mechameka/satellite_watch/README.md

# satellite_watch
ESP32-S3 based smartwatch with swappable, modular faceplate

Phase 1: Create prototype large-format board for diagnosing
Phase 2: Create compact mainboard
Phase 3: Create intial faceplate designs of LED, IPS, and blank protoboard/headers
