mechameka/satellite_watch/kicad_references/models/ips_0.96_mock.step

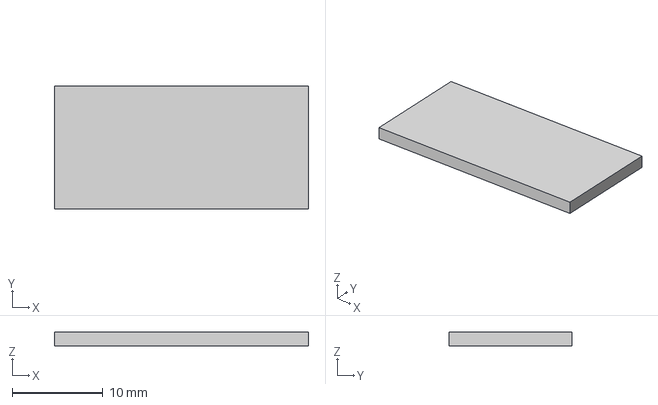
[picture p1: CAD file, 2026-07-30]
kicad_references/models/ips_0.96_mock.step
27.9 x 13.5 x 1.50 mm
