mechameka/satellite_watch/kicad_references/symbols/MSOP8_DIO.step

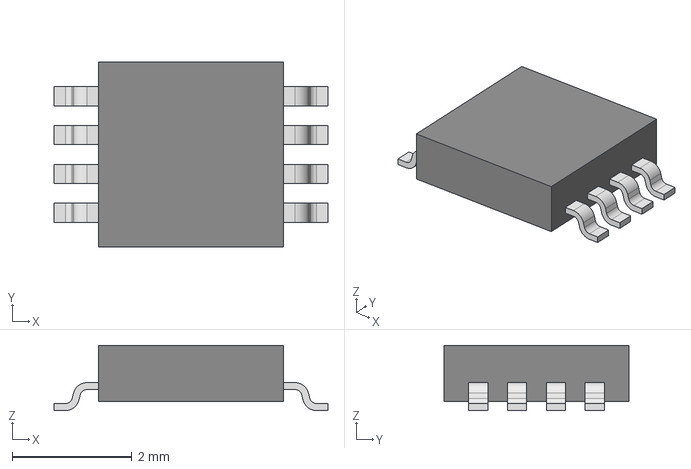
[picture p2: CAD file, 2026-06-10]
kicad_references/symbols/MSOP8_DIO.step
4.58 x 3.10 x 1.09 mm
