mechameka/satellite_watch/kicad_references/models/HP_BubbleLED.step

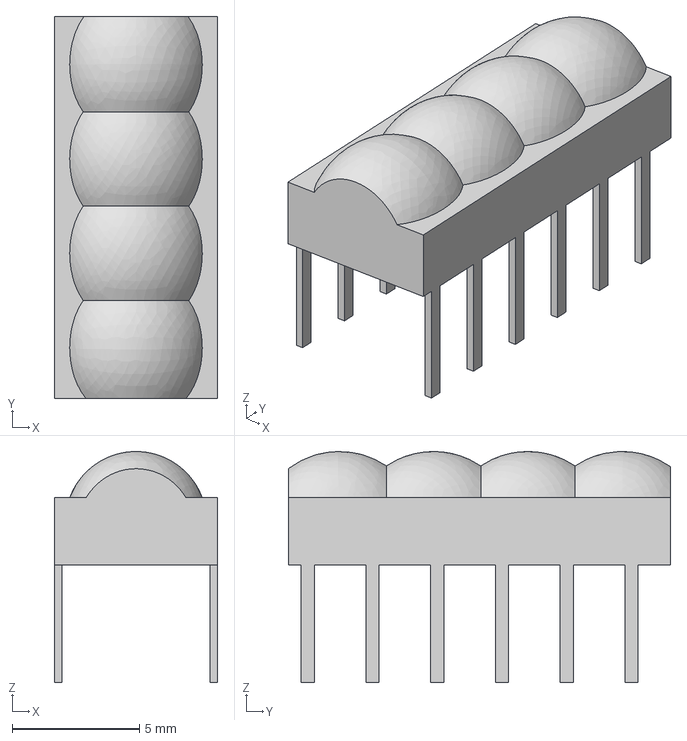
[picture p3: CAD file, 2026-07-30]
kicad_references/models/HP_BubbleLED.step
6.40 x 15.0 x 9.06 mm
