mechameka/satellite_watch/kicad_references/models/HCMS-2901.STEP

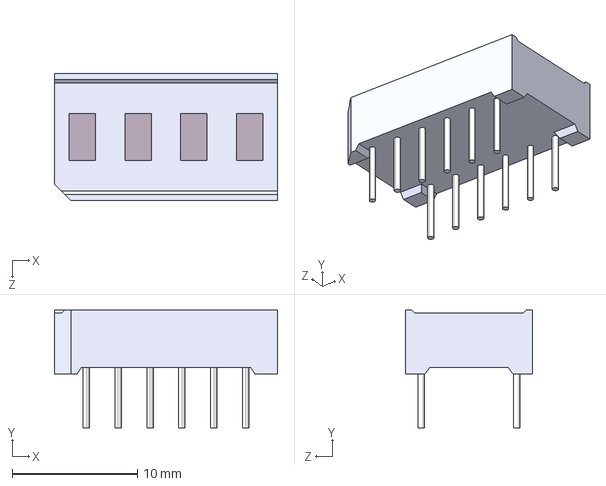
[picture p4: CAD file, 2026-07-30]
kicad_references/models/HCMS-2901.STEP
17.8 x 9.40 x 10.2 mm
