mechameka/satellite_watch/kicad_references/models/3028_2012BATTEYRHOLDER.step

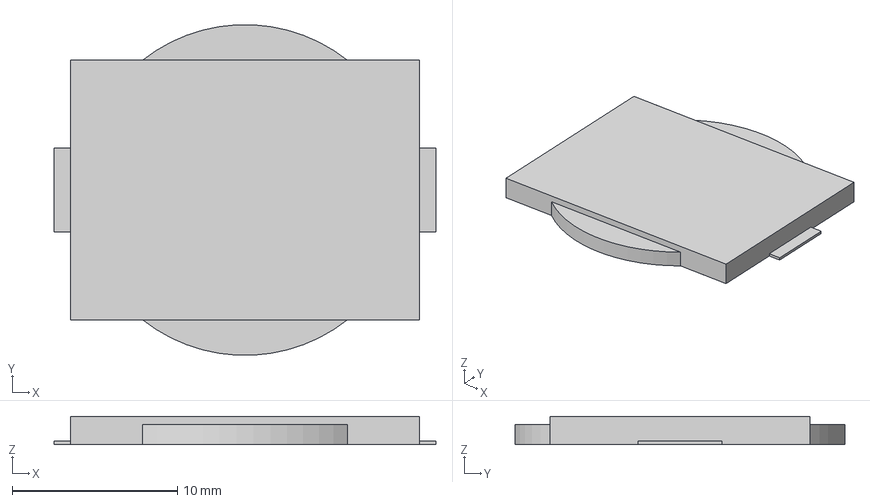
[picture p5: CAD file, 2026-07-30]
kicad_references/models/3028_2012BATTEYRHOLDER.step
23.1 x 20.0 x 1.70 mm
