mechameka/satellite_watch/kicad_references/models/Same_Sky_UJ20-C-H-G-SMT-2A-P16-TR.step

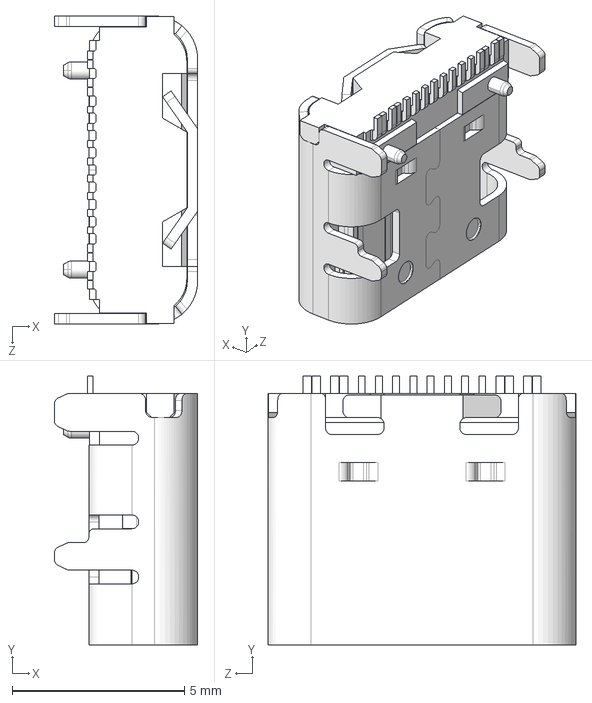
[picture p6: CAD file, 2026-07-30]
kicad_references/models/Same_Sky_UJ20-C-H-G-SMT-2A-P16-TR.step
4.16 x 7.80 x 8.94 mm
