mechameka/satellite_watch/kicad_references/models/SN74HC595NSR.stp

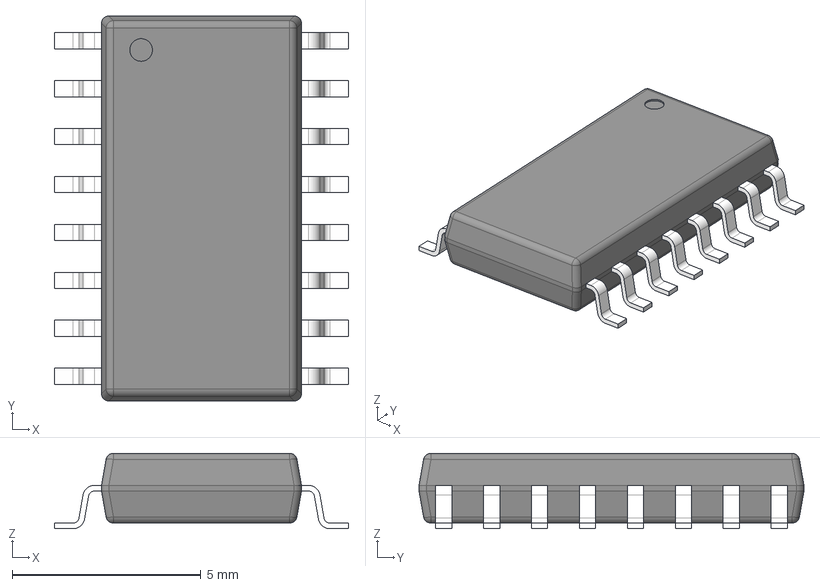
[picture p7: CAD file, 2026-07-30]
kicad_references/models/SN74HC595NSR.stp
7.80 x 10.2 x 2.00 mm
BODY-SO
LEAD-SO x 16
