mechameka/satellite_watch/kicad_references/models/BK-335-SM.step

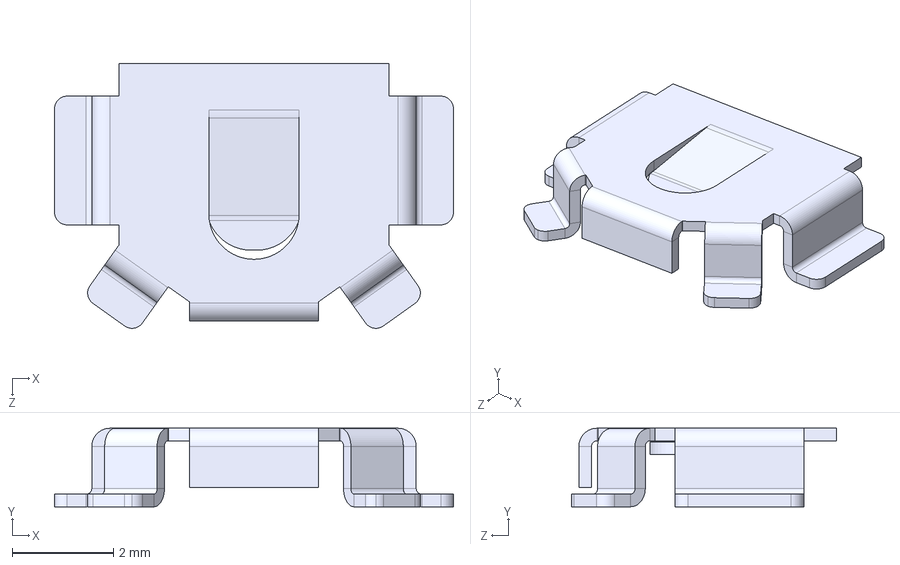
[picture p8: CAD file, 2026-07-30]
kicad_references/models/BK-335-SM.step
7.87 x 1.55 x 5.22 mm
