mechameka/satellite_watch/kicad_references/models/BC-2017.step

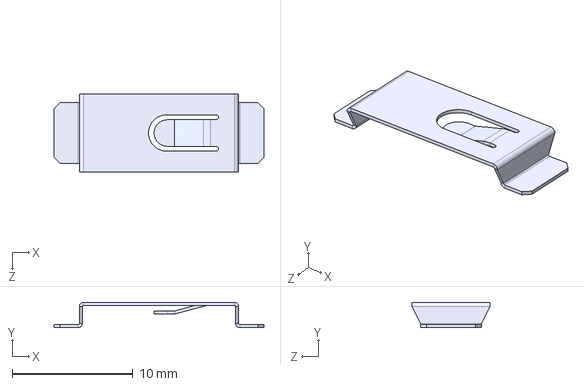
[picture p9: CAD file, 2026-07-20]
kicad_references/models/BC-2017.step
17.4 x 2.11 x 6.48 mm
