mechameka/satellite_watch/kicad_references/models/855-22-006-10-001101.stp

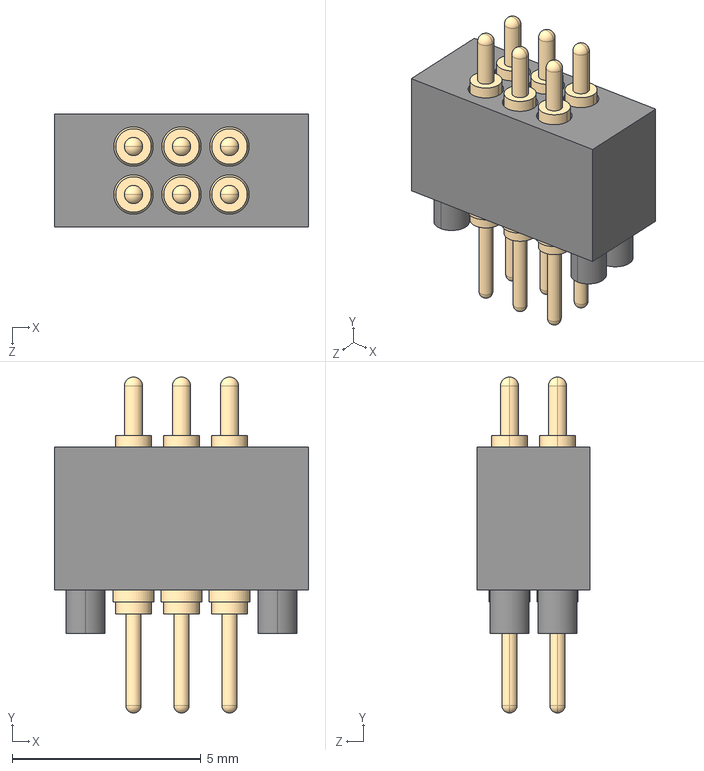
[picture p10: CAD file, 2026-07-16]
kicad_references/models/855-22-006-10-001101.stp
6.73 x 8.89 x 3.00 mm
mill-max-855-22-006-10-001101_P8XX-28-013-02-090000(P806-28-013-02-090000)
mill-max-855-22-006-10-001101_0985 x 6
