mechameka/satellite_watch/kicad_references/models/SOT-416.step

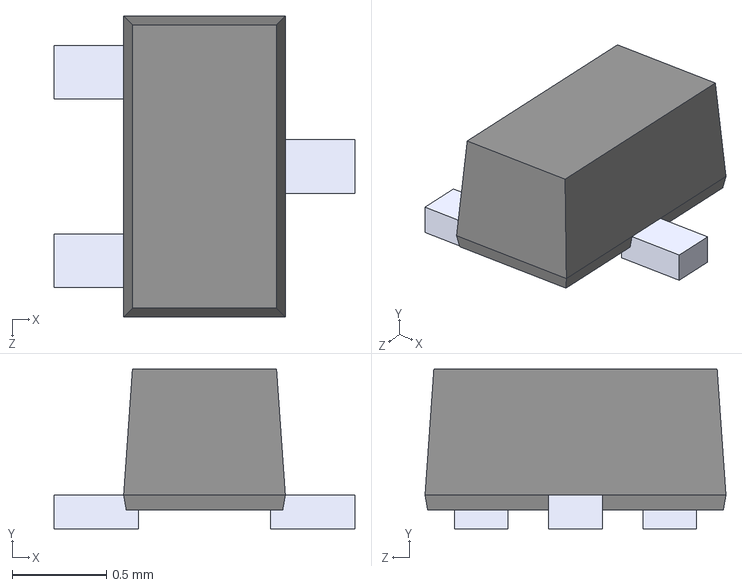
[picture p11: CAD file, 2026-07-16]
kicad_references/models/SOT-416.step
1.60 x 0.85 x 1.60 mm
