mechameka/satellite_watch/kicad_references/models/ABS07-32.768KHZ-T.STEP

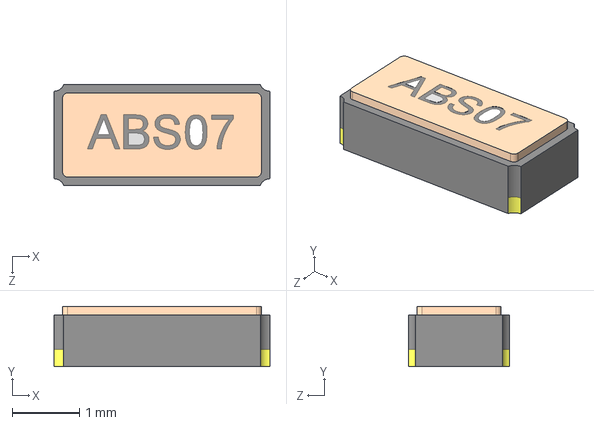
[picture p12: CAD file, 2026-07-16]
kicad_references/models/ABS07-32.768KHZ-T.STEP
3.20 x 0.889 x 1.50 mm
