mechameka/satellite_watch/kicad_references/models/R-667995_MIT.step

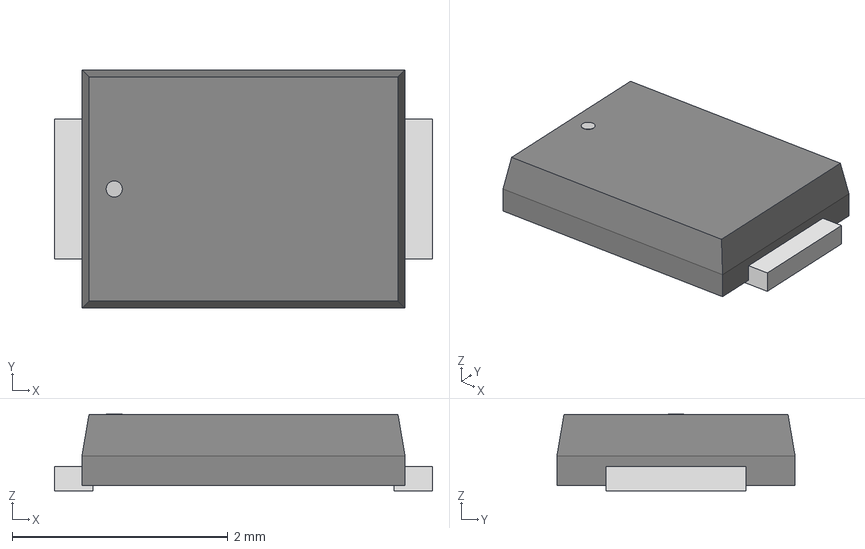
[picture p13: CAD file, 2026-07-16]
kicad_references/models/R-667995_MIT.step
3.51 x 2.21 x 0.714 mm
