mechameka/satellite_watch/kicad_references/models/PAM2401SCADJ.STEP

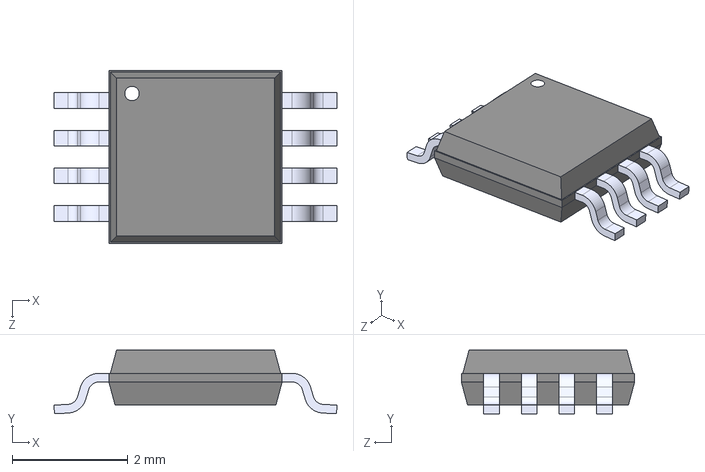
[picture p14: CAD file, 2026-07-06]
kicad_references/models/PAM2401SCADJ.STEP
4.90 x 1.10 x 3.00 mm
