mechameka/satellite_watch/kicad_references/models/TL1105SF160Q.step

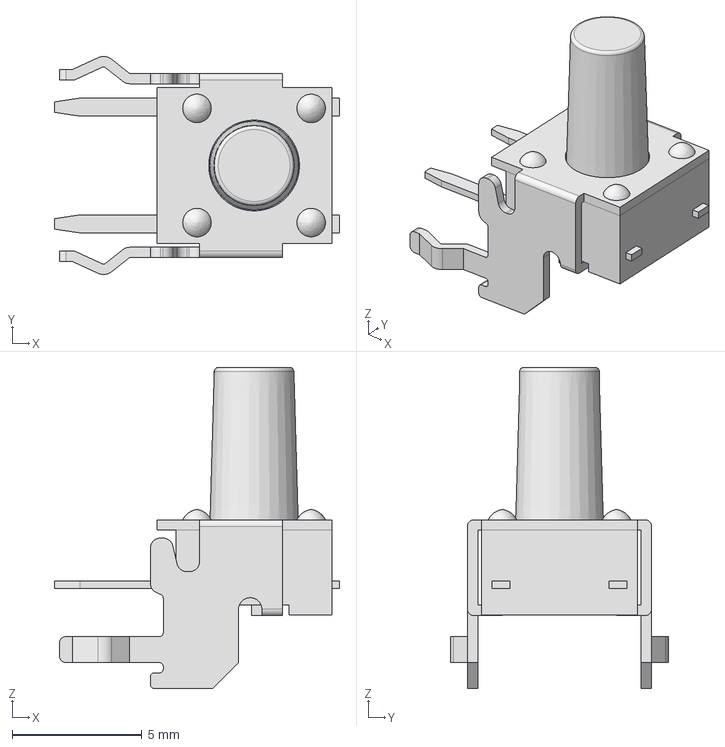
[picture p15: CAD file, 2026-07-06]
kicad_references/models/TL1105SF160Q.step
11.0 x 8.40 x 12.4 mm
