mechameka/satellite_watch/kicad_references/models/BNO085.step

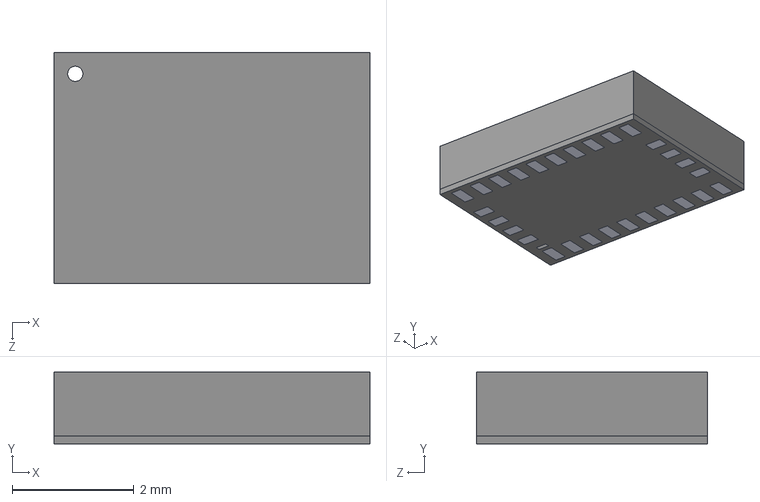
[picture p16: CAD file, 2026-06-24]
kicad_references/models/BNO085.step
5.20 x 1.18 x 3.80 mm
