mechameka/satellite_watch/kicad_references/models/FS8205.step

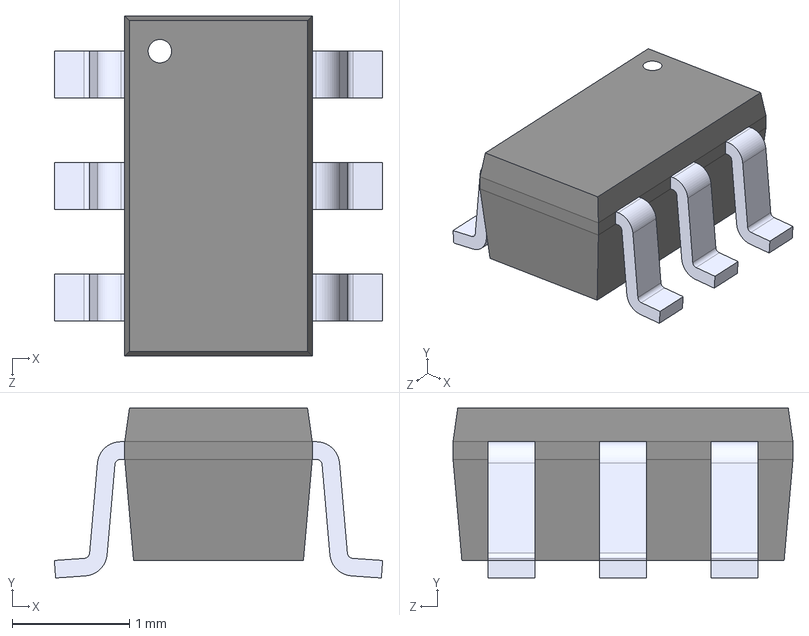
[picture p17: CAD file, 2026-06-17]
kicad_references/models/FS8205.step
2.80 x 1.45 x 2.90 mm
