mechameka/satellite_watch/kicad_references/models/UJ20-C-H-G-MSMT-2B-P16-TR.step

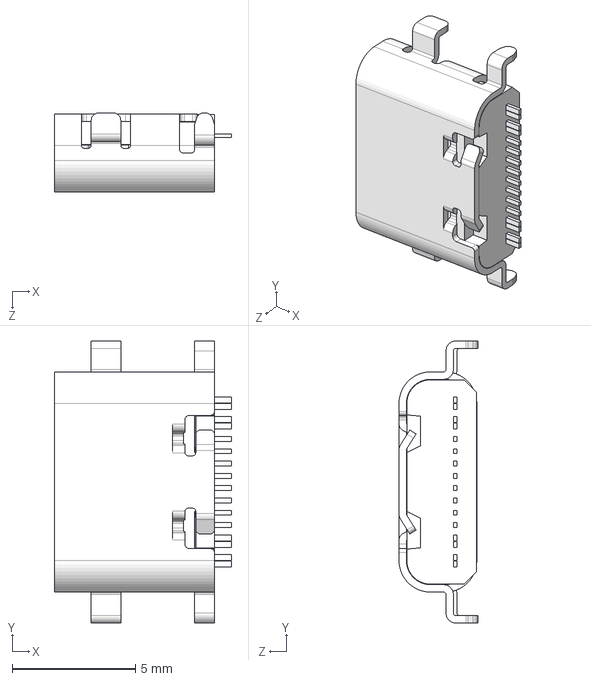
[picture p18: CAD file, 2026-06-10]
kicad_references/models/UJ20-C-H-G-MSMT-2B-P16-TR.step
7.21 x 11.4 x 3.21 mm
