mechameka/satellite_watch/kicad_references/models/NCP186AMX180TAG.STEP

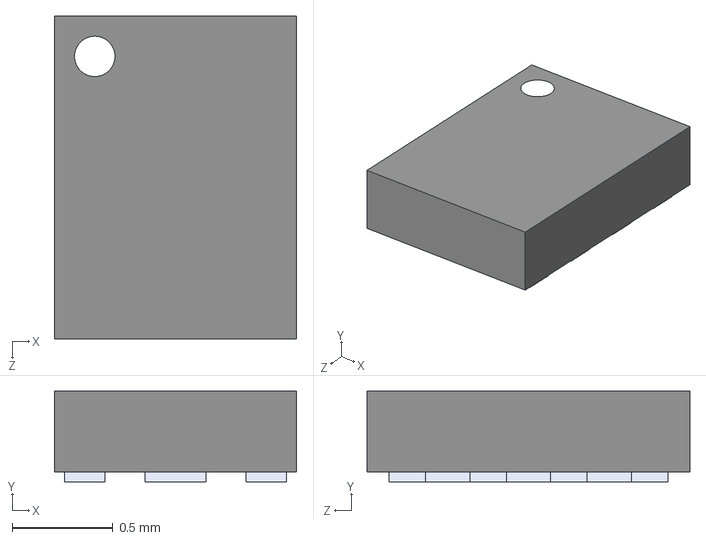
[picture p19: CAD file, 2026-06-10]
kicad_references/models/NCP186AMX180TAG.STEP
1.20 x 0.45 x 1.60 mm
