mechameka/satellite_watch/kicad_references/models/2895.step

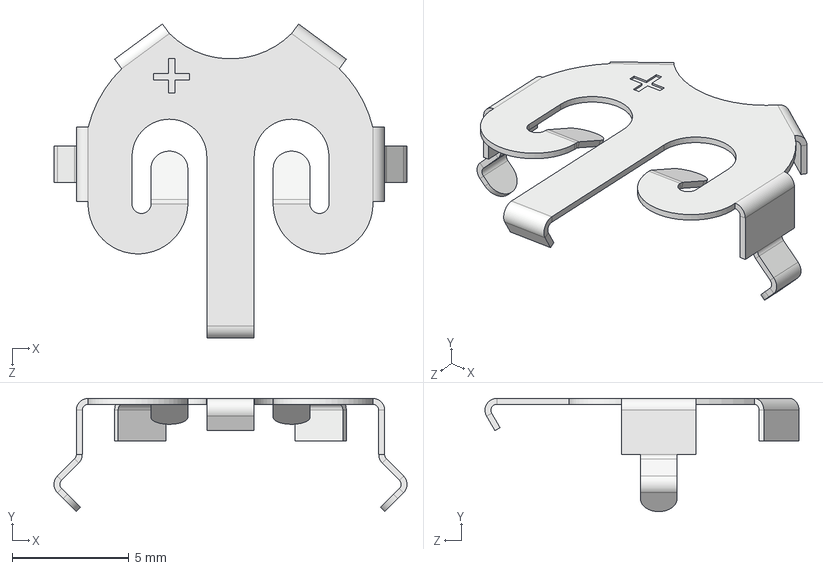
[picture p20: CAD file, 2026-06-10]
kicad_references/models/2895.step
15.1 x 4.85 x 13.5 mm
