mechameka/satellite_watch/(list of files, cad)

Other CAD files:
kicad_references/models/MAX30101EFD_T.step
