mechameka/satellite_watch/schematics/proteus_watch/proteus_watch.kicad_pcb

## KiCad design schematics/proteus_watch/proteus_watch.kicad_pcb (2026-08-21)

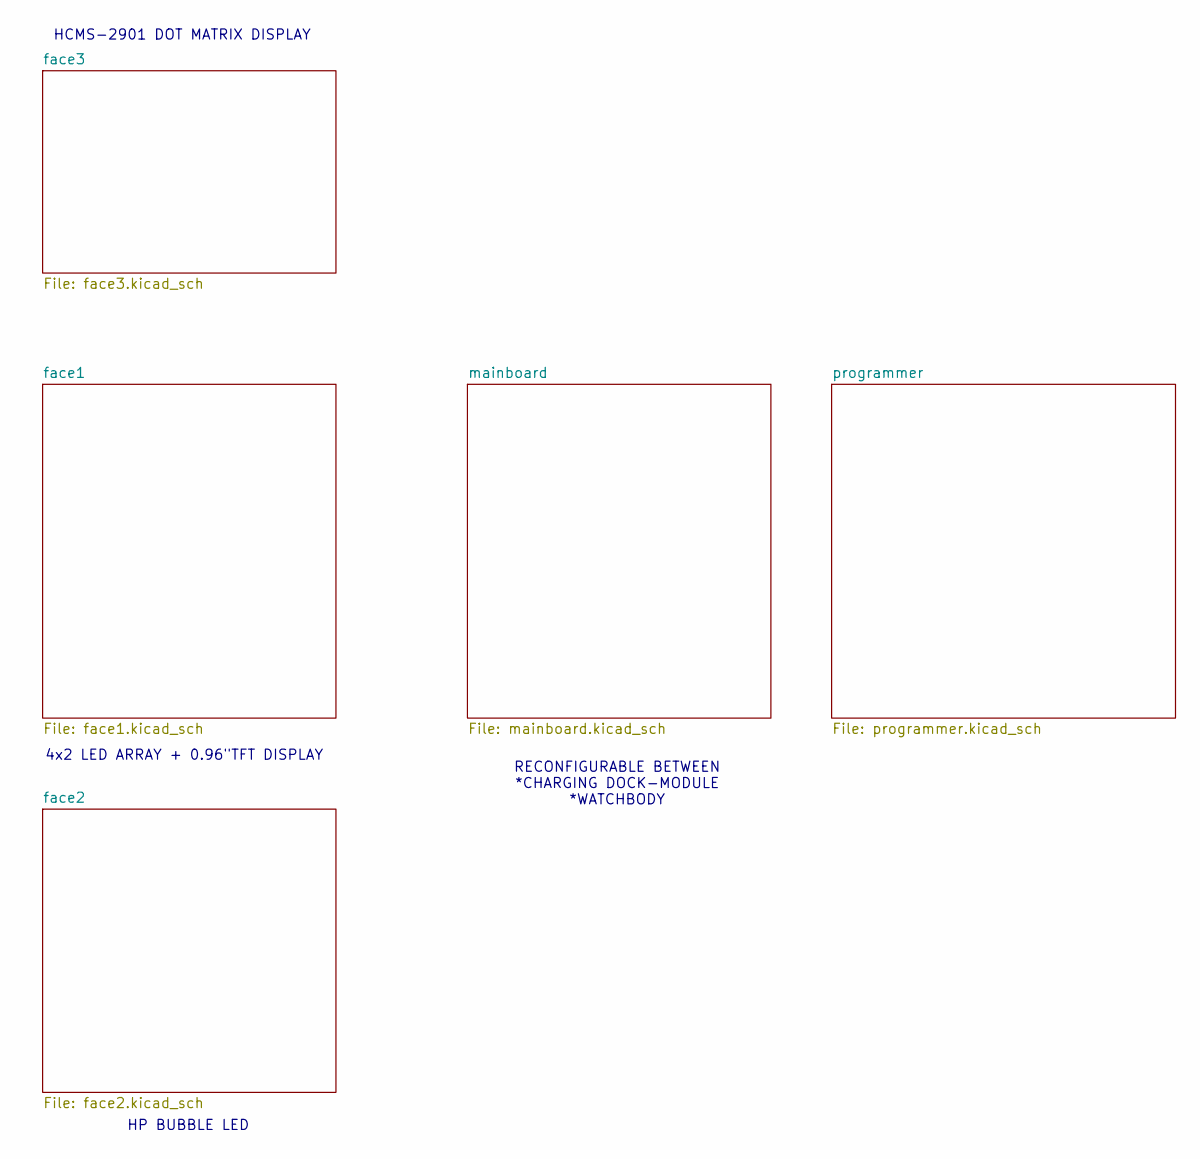
[picture p21: schematic proteus_watch.kicad_sch, PROTEUS SMARTWATCH]

Notes on the sheet:
RECONFIGURABLE BETWEEN *CHARGING DOCK-MODULE *WATCHBODY
4x2 LED ARRAY + 0.96"TFT DISPLAY
HCMS-2901 DOT MATRIX DISPLAY
HP BUBBLE LED

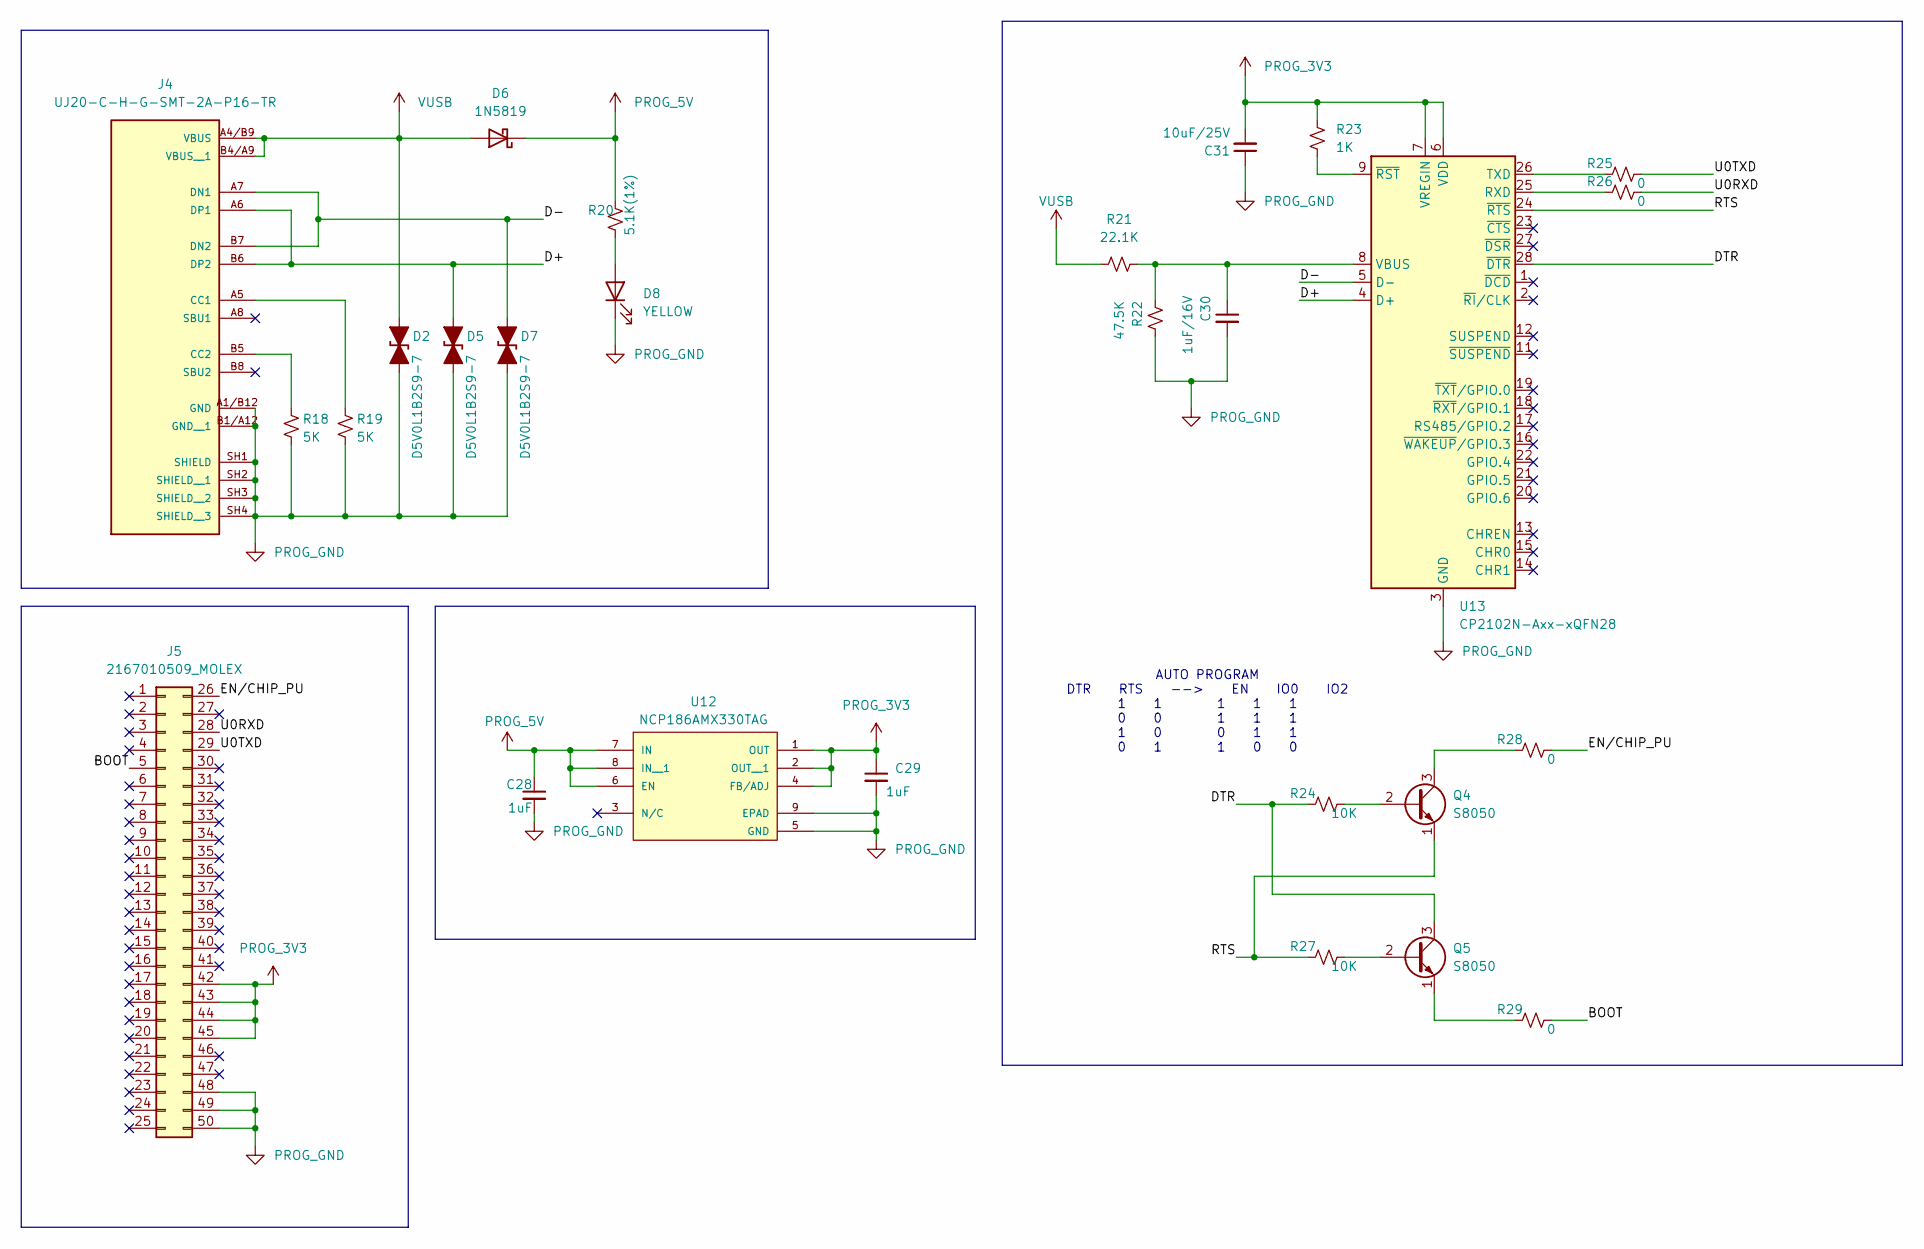
[picture p22: schematic programmer.kicad_sch, PROTEUS SMARTWATCH]

Parts:
C28, C29: 1uF; C_0402_1005Metric_Pad0.74x0.62mm_HandSolder
C30: 1uF/16V; C_0402_1005Metric_Pad0.74x0.62mm_HandSolder
C31: 10uF/25V; C_0402_1005Metric_Pad0.74x0.62mm_HandSolder
D2, D5, D7: D5V0L1B2S9-7; D_SOD-923
D6: 1N5819; D_SOD-123
D8: YELLOW; LED_0402_1005Metric_Pad0.77x0.64mm_HandSolder
J4: UJ20-C-H-G-SMT-2A-P16-TR; SAMESKY_UJ20-C-H-G-SMT-2A-P16-TR_1; PARTREV 1.0
J5: 2167010509_MOLEX; CON_2167010509_MOL
Q4, Q5: S8050; SOT-23
R18, R19: 5K; R_0402_1005Metric_Pad0.72x0.64mm_HandSolder
R20: 5.1K(1%); R_0402_1005Metric_Pad0.72x0.64mm_HandSolder
R21: 22.1K; R_0402_1005Metric_Pad0.72x0.64mm_HandSolder
R22: 47.5K; R_0402_1005Metric_Pad0.72x0.64mm_HandSolder
R23: 1K; R_0402_1005Metric_Pad0.72x0.64mm_HandSolder
R24, R27: 10K; R_0402_1005Metric_Pad0.72x0.64mm_HandSolder
R25, R26, R28, R29: 0; R_0402_1005Metric_Pad0.72x0.64mm_HandSolder
U12: NCP186AMX330TAG; PSON40P160X120X45-9N; PARTREV Rev.5
U13: CP2102N-Axx-xQFN28; QFN-28-1EP_5x5mm_P0.5mm_EP3.25x3.25mm_ThermalVias

Connections:
/programmer/BOOT: J5.5, R29.1
/programmer/D+: D5.1 (A1), J4.A6 (DP1), J4.B6 (DP2), U13.4 (D+)
/programmer/D-: D7.1 (A1), J4.A7 (DN1), J4.B7 (DN2), U13.5 (D-)
/programmer/DTR: Q5.3 (C), R24.2, U13.28 (~DTR)
/programmer/EN/CHIP_PU: J5.26, R28.1
/programmer/RTS: Q4.1 (E), R27.2, U13.24 (~RTS)
/programmer/U0RXD: J5.28, R26.1
/programmer/U0TXD: J5.29, R25.1
unnamed: D8.2 (A), R20.1
unnamed: J4.A5 (CC1), R19.1
unnamed: J4.B5 (CC2), R18.1
unnamed: Q4.2 (B), R24.1
unnamed: Q4.3 (C), R28.2
unnamed: Q5.2 (B), R27.1
unnamed: Q5.1 (E), R29.2
unnamed: R26.2, U13.25 (RXD)
unnamed: R25.2, U13.26 (TXD)
unnamed: C30.1, R21.2, R22.1, U13.8 (VBUS)
unnamed: R23.1, U13.9 (~RST)
PROG_3V3: C29.1, C31.2, J5.42, J5.43, J5.44, J5.45, R23.2, U12.1 (OUT), U12.2 (OUT__1), U12.4 (FB/ADJ), U13.6 (VDD), U13.7 (VREGIN)
PROG_5V: C28.1, D6.1 (K), R20.2, U12.6 (EN), U12.7 (IN), U12.8 (IN__1)
PROG_GND: C28.2, C29.2, C30.2, C31.1, D2.2 (A2), D5.2 (A2), D7.2 (A2), D8.1 (K), J4.A1/B12 (GND), J4.B1/A12 (GND__1), J4.SH1 (SHIELD), J4.SH2 (SHIELD__1), J4.SH3 (SHIELD__2), J4.SH4 (SHIELD__3), J5.48, J5.49, J5.50, R18.2, R19.2, R22.2, U12.5 (GND), U12.9 (EPAD), U13.3 (GND), U13.29 (GND)
VUSB: D2.1 (A1), D6.2 (A), J4.A4/B9 (VBUS), J4.B4/A9 (VBUS__1), R21.1

Notes on the sheet:
AUTO PROGRAM DTR RTS --> EN IO0 IO2 1 1 1 1 1 0 0 1 1 1 1 0 0 1 1 0 1 1 0 0

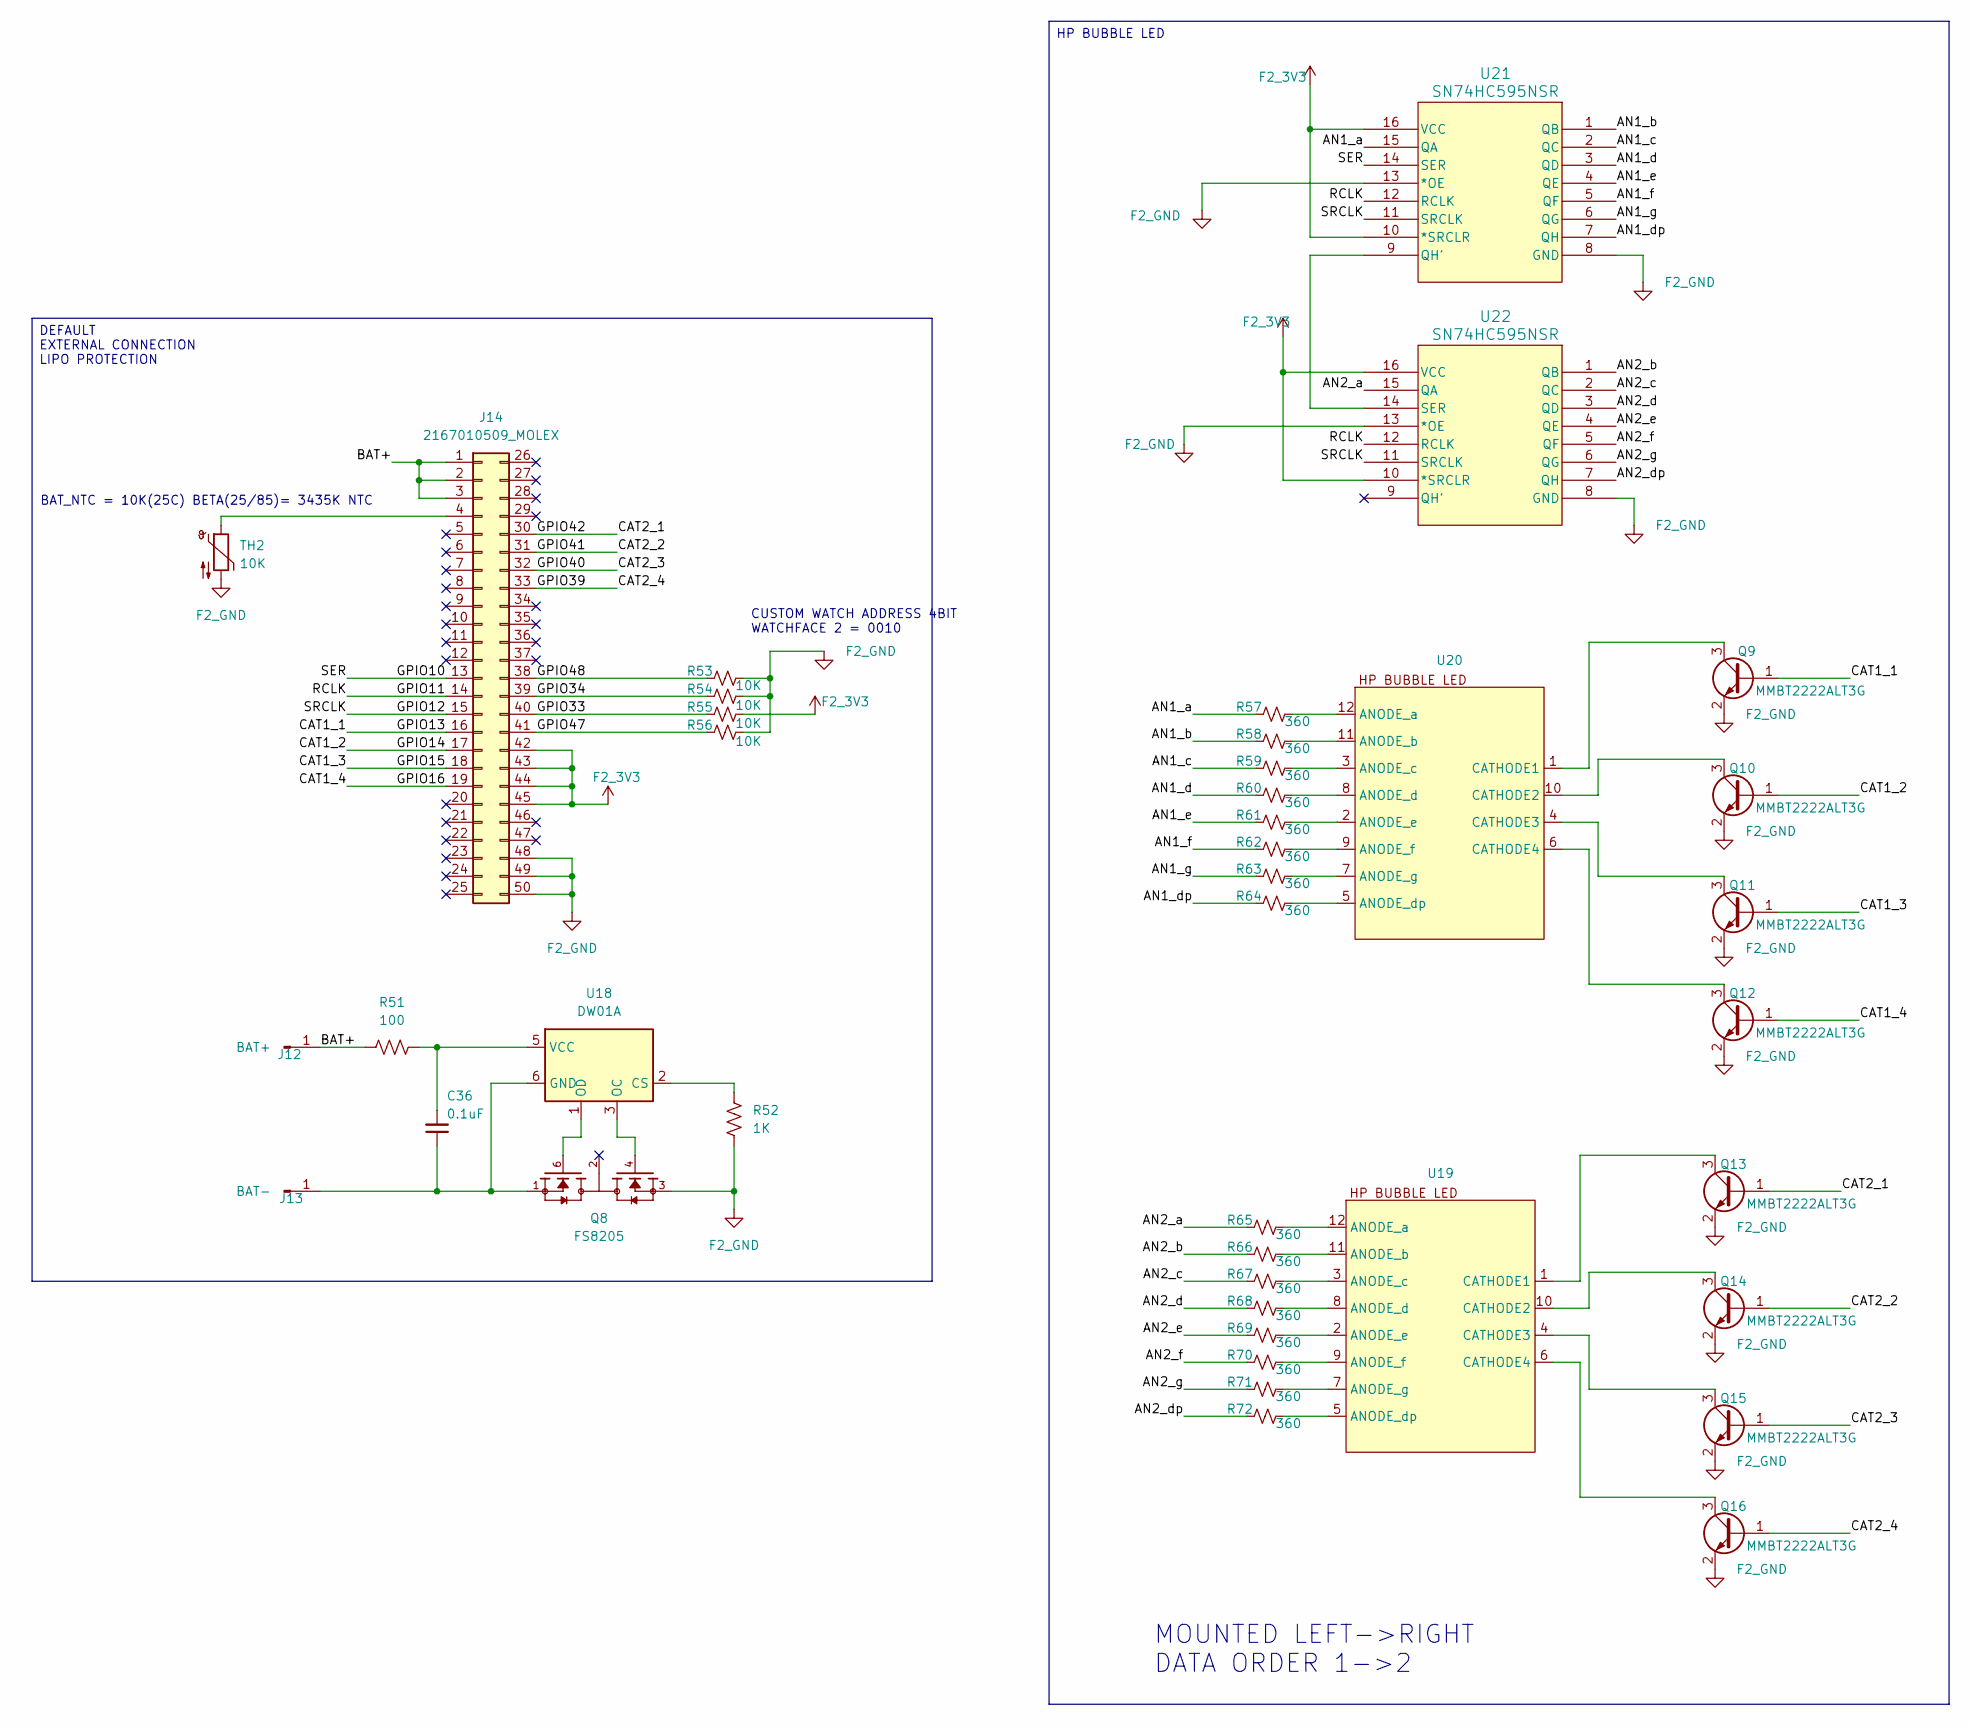
[picture p23: schematic face2.kicad_sch, PROTEUS SMARTWATCH]

Parts:
C36: 0.1uF; C_0402_1005Metric_Pad0.74x0.62mm_HandSolder
J12: BAT+; SolderWirePad_1x01_SMD_3x6mm
J13: BAT-; SolderWirePad_1x01_SMD_3x6mm
J14: 2167010509_MOLEX; CON_2167010509_MOL
Q8: FS8205; SOT95P280X145-6N; PARTREV 1.9
Q9, Q10, Q11, Q12, Q13, Q14, Q15, Q16: MMBT2222ALT3G; SOT-23
R51: 100; R_0402_1005Metric_Pad0.72x0.64mm_HandSolder
R52: 1K; R_0402_1005Metric_Pad0.72x0.64mm_HandSolder
R53, R54, R55, R56: 10K; R_0402_1005Metric_Pad0.72x0.64mm_HandSolder
R57, R58, R59, R60, R61, R62, R63, R64, R65, R66, R67, R68, R69, R70, R71, R72: 360; R_0402_1005Metric_Pad0.72x0.64mm_HandSolder
TH2: 10K; R_0402_1005Metric_Pad0.72x0.64mm_HandSolder
U18: DW01A; SOT-23-6
U19, U20: DIP-12_W7.62mm
U21, U22: SN74HC595NSR; NS16-L

Connections:
/face2/AN1_a: R57.1, U21.15 (QA)
/face2/AN1_b: R58.1, U21.1 (QB)
/face2/AN1_c: R59.1, U21.2 (QC)
/face2/AN1_d: R60.1, U21.3 (QD)
/face2/AN1_dp: R64.1, U21.7 (QH)
/face2/AN1_e: R61.1, U21.4 (QE)
/face2/AN1_f: R62.1, U21.5 (QF)
/face2/AN1_g: R63.1, U21.6 (QG)
/face2/AN2_a: R65.1, U22.15 (QA)
/face2/AN2_b: R66.1, U22.1 (QB)
/face2/AN2_c: R67.1, U22.2 (QC)
/face2/AN2_d: R68.1, U22.3 (QD)
/face2/AN2_dp: R72.1, U22.7 (QH)
/face2/AN2_e: R69.1, U22.4 (QE)
/face2/AN2_f: R70.1, U22.5 (QF)
/face2/AN2_g: R71.1, U22.6 (QG)
/face2/BAT+: J12.1 (Pin_1_1), J14.1, J14.2, J14.3, R51.1
/face2/CAT1_1: J14.16, Q9.1 (B)
/face2/CAT1_2: J14.17, Q10.1 (B)
/face2/CAT1_3: J14.18, Q11.1 (B)
/face2/CAT1_4: J14.19, Q12.1 (B)
/face2/CAT2_1: J14.30, Q13.1 (B)
/face2/CAT2_2: J14.31, Q14.1 (B)
/face2/CAT2_3: J14.32, Q15.1 (B)
/face2/CAT2_4: J14.33, Q16.1 (B)
/face2/GPIO10: J14.13, U21.14 (SER)
/face2/GPIO11: J14.14, U21.12 (RCLK), U22.12 (RCLK)
/face2/GPIO12: J14.15, U21.11 (SRCLK), U22.11 (SRCLK)
/face2/GPIO33: J14.40, R55.1
/face2/GPIO34: J14.39, R54.1
/face2/GPIO47: J14.41, R56.1
/face2/GPIO48: J14.38, R53.1
F2_3V3: J14.42, J14.43, J14.44, J14.45, R55.2, U21.10 (*SRCLR), U21.16 (VCC), U22.10 (*SRCLR), U22.16 (VCC)
F2_GND: J14.48, J14.49, J14.50, Q8.3, Q9.2 (E), Q10.2 (E), Q11.2 (E), Q12.2 (E), Q13.2 (E), Q14.2 (E), Q15.2 (E), Q16.2 (E), R52.1, R53.2, R54.2, R56.2, TH2.2, U21.8 (GND), U21.13 (*OE), U22.8 (GND), U22.13 (*OE)
unnamed: C36.1, J13.1 (Pin_1_1), Q8.1, U18.6 (GND)
unnamed: J14.4, TH2.1
unnamed: Q9.3 (C), U20.1 (CATHODE1)
unnamed: Q10.3 (C), U20.10 (CATHODE2)
unnamed: Q11.3 (C), U20.4 (CATHODE3)
unnamed: Q12.3 (C), U20.6 (CATHODE4)
unnamed: Q13.3 (C), U19.1 (CATHODE1)
unnamed: Q14.3 (C), U19.10 (CATHODE2)
unnamed: Q15.3 (C), U19.4 (CATHODE3)
unnamed: Q16.3 (C), U19.6 (CATHODE4)
unnamed: R52.2, U18.2 (CS)
unnamed: Q8.4, U18.3 (OC)
unnamed: Q8.6, U18.1 (OD)
unnamed: C36.2, R51.2, U18.5 (VCC)
unnamed: R65.2, U19.12 (ANODE_a)
unnamed: R66.2, U19.11 (ANODE_b)
unnamed: R67.2, U19.3 (ANODE_c)
unnamed: R68.2, U19.8 (ANODE_d)
unnamed: R72.2, U19.5 (ANODE_dp)
unnamed: R69.2, U19.2 (ANODE_e)
unnamed: R70.2, U19.9 (ANODE_f)
unnamed: R71.2, U19.7 (ANODE_g)
unnamed: R57.2, U20.12 (ANODE_a)
unnamed: R58.2, U20.11 (ANODE_b)
unnamed: R59.2, U20.3 (ANODE_c)
unnamed: R60.2, U20.8 (ANODE_d)
unnamed: R64.2, U20.5 (ANODE_dp)
unnamed: R61.2, U20.2 (ANODE_e)
unnamed: R62.2, U20.9 (ANODE_f)
unnamed: R63.2, U20.7 (ANODE_g)
unnamed: U21.9 (QH'), U22.14 (SER)

Notes on the sheet:
MOUNTED LEFT->RIGHT DATA ORDER 1->2
BAT_NTC = 10K(25C) BETA(25/85)= 3435K NTC
CUSTOM WATCH ADDRESS 4BIT WATCHFACE 2 = 0010
DEFAULT EXTERNAL CONNECTION LIPO PROTECTION
HP BUBBLE LED

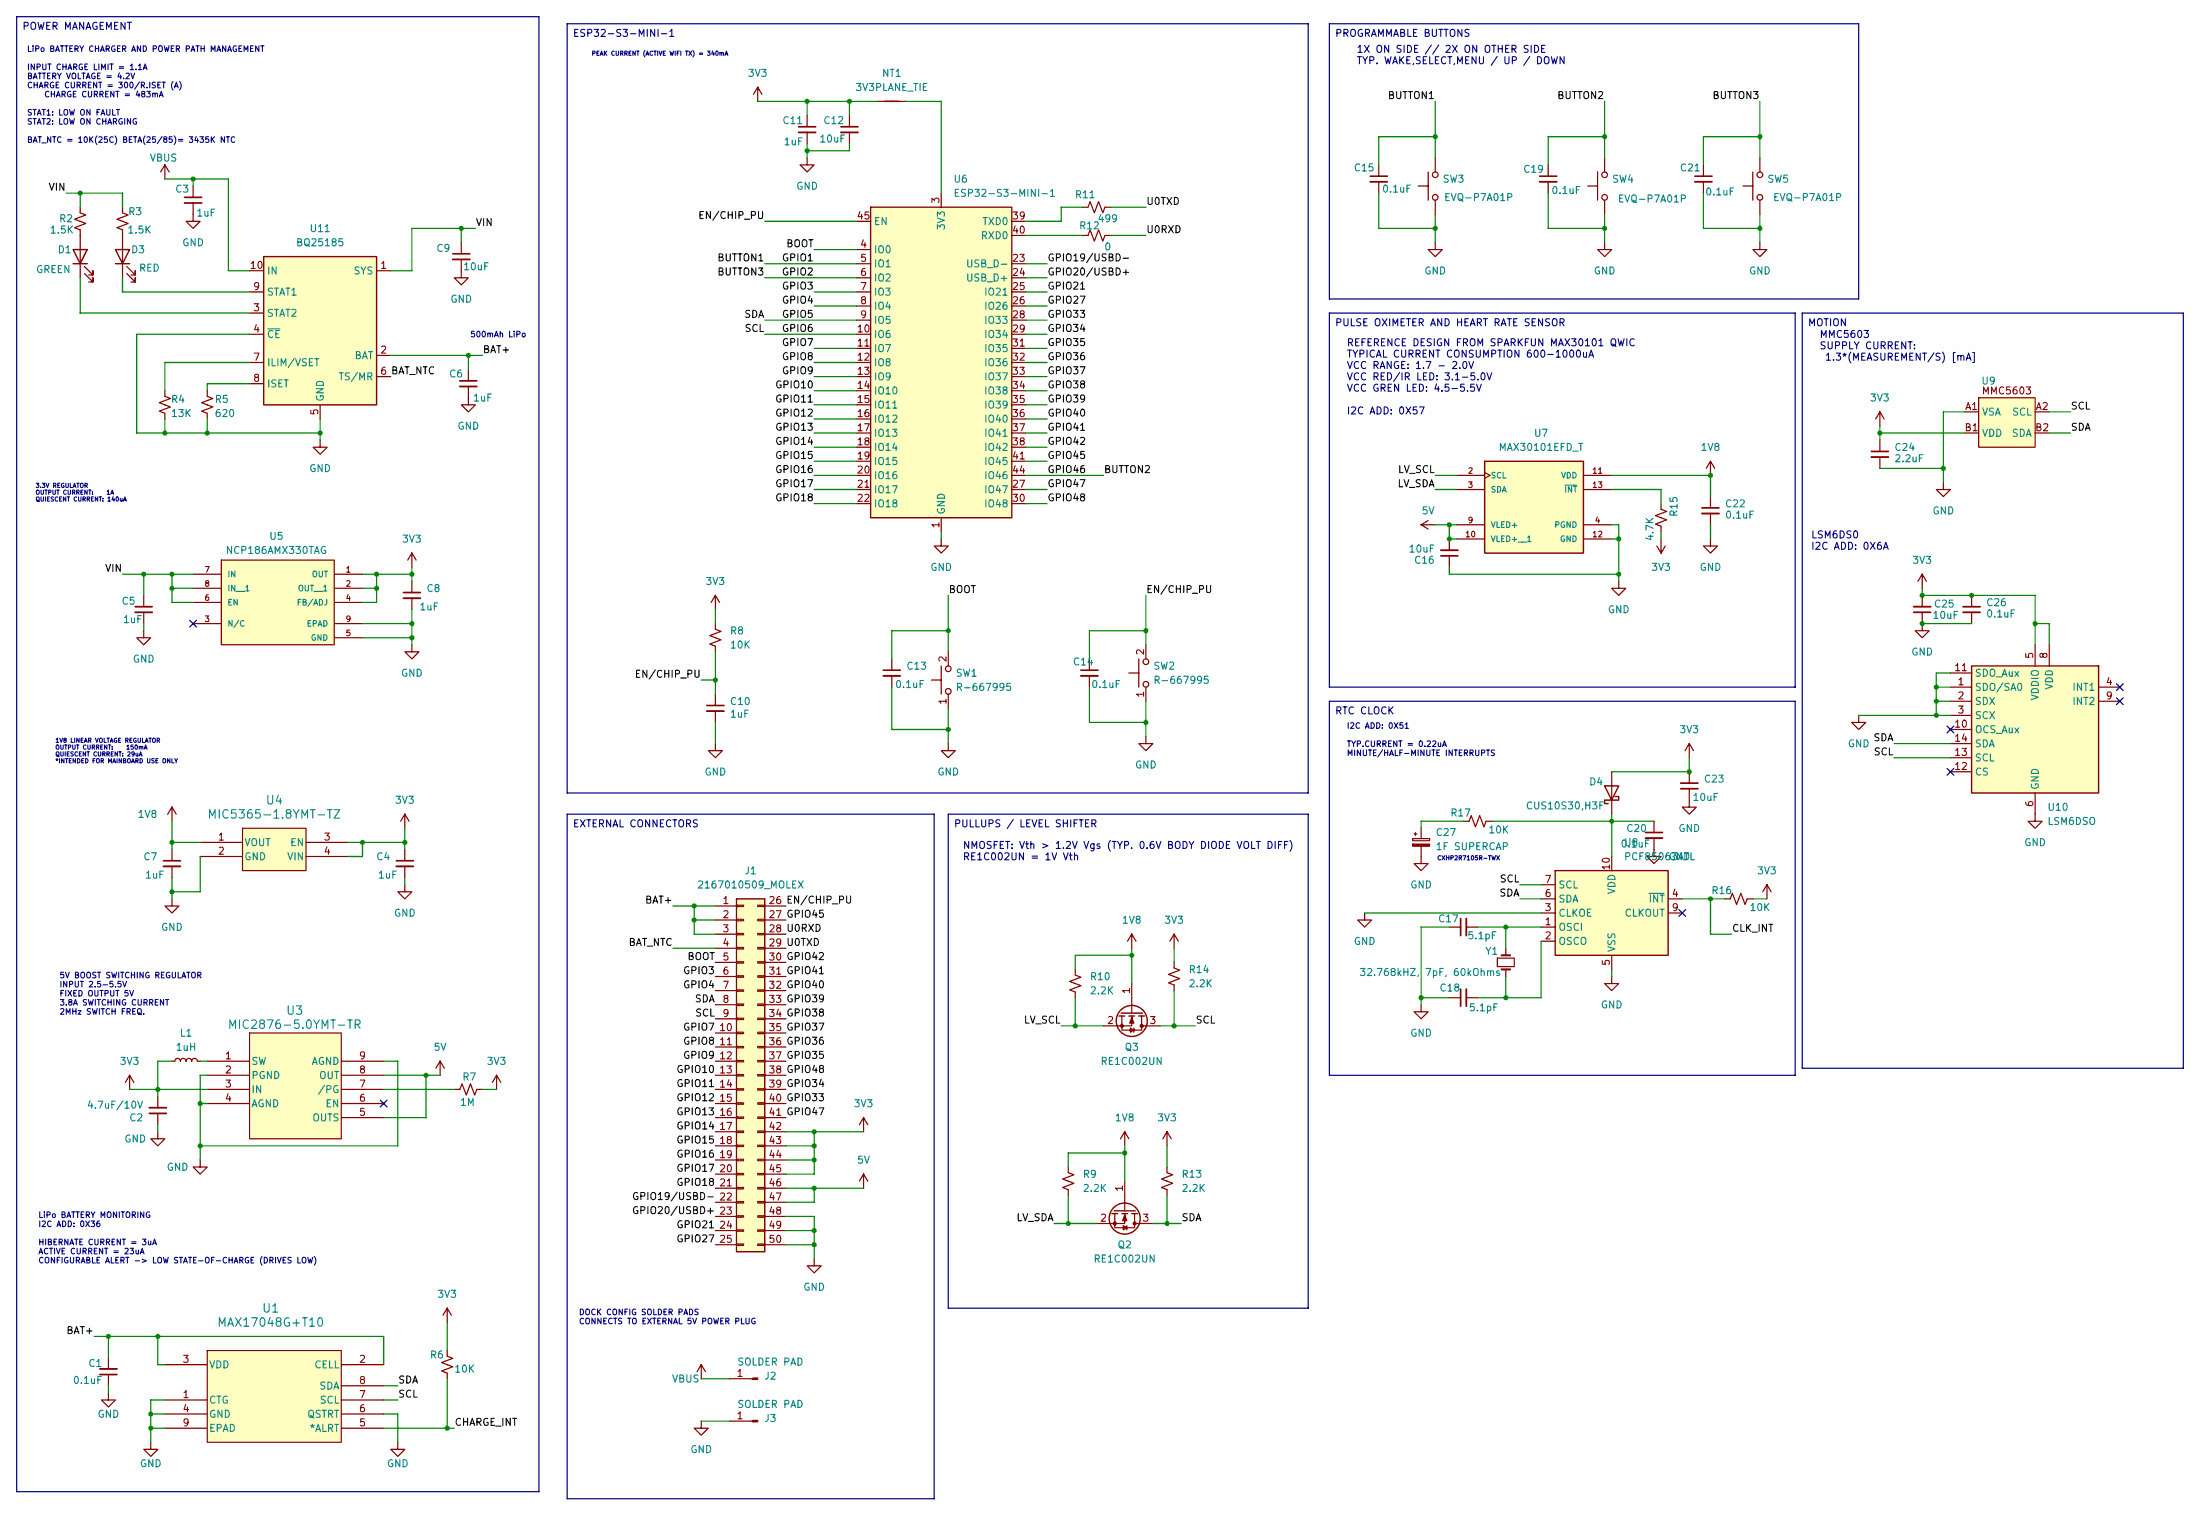
[picture p24: schematic mainboard.kicad_sch, PROTEUS SMARTWATCH]

Parts:
C1, C13, C14, C15, C19, C20, C21, C22, C26: 0.1uF; C_0402_1005Metric_Pad0.74x0.62mm_HandSolder
C2: 4.7uF/10V; C_0402_1005Metric_Pad0.74x0.62mm_HandSolder
C3, C4, C5, C6, C7, C8, C10, C11: 1uF; C_0402_1005Metric_Pad0.74x0.62mm_HandSolder
C9, C12, C16, C23, C25: 10uF; C_0402_1005Metric_Pad0.74x0.62mm_HandSolder
C17, C18: 5.1pF; C_0402_1005Metric_Pad0.74x0.62mm_HandSolder
C24: 2.2uF; C_0402_1005Metric_Pad0.74x0.62mm_HandSolder
C27: 1F SUPERCAP; 2.54mm_SUPERCAP_THT_RIGHTANGLE
D1: GREEN; LED_0402_1005Metric_Pad0.77x0.64mm_HandSolder
D3: RED; LED_0402_1005Metric_Pad0.77x0.64mm_HandSolder
D4: CUS10S30,H3F; D_SOD-323
J1: 2167010509_MOLEX; CON_2167010509_MOL
J2, J3: SOLDER PAD; SolderWirePad_1x01_SMD_1x2mm
L1: 1uH; L_0402_1005Metric_Pad0.77x0.64mm_HandSolder
NT1: 3V3PLANE_TIE; NetTie-2_SMD_Pad0.5mm
Q2, Q3: RE1C002UN; SOT-416
R2, R3: 1.5K; R_0402_1005Metric_Pad0.72x0.64mm_HandSolder
R4: 13K; R_0402_1005Metric_Pad0.72x0.64mm_HandSolder
R5: 620; R_0402_1005Metric_Pad0.72x0.64mm_HandSolder
R6, R8, R16, R17: 10K; R_0402_1005Metric_Pad0.72x0.64mm_HandSolder
R7: 1M; R_0402_1005Metric_Pad0.72x0.64mm_HandSolder
R9, R10, R13, R14: 2.2K; R_0402_1005Metric_Pad0.72x0.64mm_HandSolder
R11: 499; R_0402_1005Metric_Pad0.72x0.64mm_HandSolder
R12: 0; R_0402_1005Metric_Pad0.72x0.64mm_HandSolder
R15: 4.7K; R_0402_1005Metric_Pad0.72x0.64mm_HandSolder
SW1, SW2: R-667995; R-667995_MIT-L
SW3, SW4, SW5: EVQ-P7A01P; SW_SPST_EVQP7A
U1: MAX17048G+T10; TDFN-8-1EP_2x2mm_P0.5mm_EP0.8x1.2mm
U3: MIC2876-5.0YMT-TR; UDFN8_2X2_MCH-L
U4: MIC5365-1.8YMT-TZ; UDFN-4-1EP_1x1mm_P0.65mm_EP0.48x0.48mm
U5: NCP186AMX330TAG; PSON40P160X120X45-9N; PARTREV Rev.5
U6: ESP32-S3-MINI-1
U7: MAX30101EFD_T; MAX30101EFD+T; PARTREV 2
U8: PCF85063ATL; DFN-10-1EP_2.6x2.6mm_P0.5mm_EP1.3x2.2mm
U9: WLP-4_0.83x0.83mm_P0.4mm
U10: LSM6DSO; LGA-14_3x2.5mm_P0.5mm_LayoutBorder3x4y
U11: BQ25185; Texas_DLH0010A_WSON-10-1EP_2.2x2mm_P0.4mm_EP0.9x1.5mm_Therm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
Y1: 32.768kHZ, 7pF, 60kOhms; Crystal_SMD_GEYER_12.87147

Connections:
1V8: C7.1, C22.1, Q2.1 (G), Q3.1 (G), R9.1, R10.1, U4.1 (VOUT), U7.11 (VDD)
3V3: C2.2, C4.1, C8.1, C11.1, C12.1, C23.1, C24.1, C25.2, C26.1, D4.2 (A), J1.42, J1.43, J1.44, J1.45, L1.1, NT1.1, R6.2, R7.2, R8.1, R13.1, R14.1, R15.2, R16.2, U3.3 (IN), U4.3 (EN), U4.4 (VIN), U5.1 (OUT), U5.2 (OUT__1), U5.4 (FB/ADJ), U9.B1 (VDD), U10.5 (VDDIO), U10.8 (VDD)
5V: C16.2, J1.46, J1.47, U3.5 (OUTS), U3.8 (OUT), U7.9 (VLED+), U7.10 (VLED+__1)
/mainboard/BAT+: C1.2, C6.1, J1.1, J1.2, J1.3, U1.2 (CELL), U1.3 (VDD), U11.2 (BAT)
/mainboard/BAT_NTC: J1.4, U11.6 (TS/MR)
/mainboard/BOOT: C13.1, J1.5, SW1.2, U6.4 (IO0)
/mainboard/BUTTON1: C15.1, SW3.2, U6.5 (IO1)
/mainboard/BUTTON2: C19.1, SW4.2, U6.44 (IO46)
/mainboard/BUTTON3: C21.1, SW5.2, U6.6 (IO2)
/mainboard/CHARGE_INT: R6.1, U1.5 (*ALRT)
/mainboard/CLK_INT: R16.1, U8.4 (~INT)
/mainboard/EN/CHIP_PU: C10.1, C14.1, J1.26, R8.2, SW2.2, U6.45 (EN)
/mainboard/GPIO3: J1.6, U6.7 (IO3)
/mainboard/GPIO4: J1.7, U6.8 (IO4)
/mainboard/GPIO5: J1.8, Q2.3 (D), R13.2, U1.8 (SDA), U6.9 (IO5), U8.6 (SDA), U9.B2 (SDA), U10.14 (SDA)
/mainboard/GPIO6: J1.9, Q3.3 (D), R14.2, U1.7 (SCL), U6.10 (IO6), U8.7 (SCL), U9.A2 (SCL), U10.13 (SCL)
/mainboard/GPIO7: J1.10, U6.11 (IO7)
/mainboard/GPIO8: J1.11, U6.12 (IO8)
/mainboard/GPIO9: J1.12, U6.13 (IO9)
/mainboard/GPIO10: J1.13, U6.14 (IO10)
/mainboard/GPIO11: J1.14, U6.15 (IO11)
/mainboard/GPIO12: J1.15, U6.16 (IO12)
/mainboard/GPIO13: J1.16, U6.17 (IO13)
/mainboard/GPIO14: J1.17, U6.18 (IO14)
/mainboard/GPIO15: J1.18, U6.19 (IO15)
/mainboard/GPIO16: J1.19, U6.20 (IO16)
/mainboard/GPIO17: J1.20, U6.21 (IO17)
/mainboard/GPIO18: J1.21, U6.22 (IO18)
/mainboard/GPIO19/USBD-: J1.22, U6.23 (USB_D-)
/mainboard/GPIO20/USBD+: J1.23, U6.24 (USB_D+)
/mainboard/GPIO21: J1.24, U6.25 (IO21)
/mainboard/GPIO27: J1.25, U6.26 (IO26)
/mainboard/GPIO33: J1.40, U6.28 (IO33)
/mainboard/GPIO34: J1.39, U6.29 (IO34)
/mainboard/GPIO35: J1.37, U6.31 (IO35)
/mainboard/GPIO36: J1.36, U6.32 (IO36)
/mainboard/GPIO37: J1.35, U6.33 (IO37)
/mainboard/GPIO38: J1.34, U6.34 (IO38)
/mainboard/GPIO39: J1.33, U6.35 (IO39)
/mainboard/GPIO40: J1.32, U6.36 (IO40)
/mainboard/GPIO41: J1.31, U6.37 (IO41)
/mainboard/GPIO42: J1.30, U6.38 (IO42)
/mainboard/GPIO45: J1.27, U6.41 (IO45)
/mainboard/GPIO47: J1.41, U6.27 (IO47)
/mainboard/GPIO48: J1.38, U6.30 (IO48)
/mainboard/LV_SCL: Q3.2 (S), R10.2, U7.2 (SCL)
/mainboard/LV_SDA: Q2.2 (S), R9.2, U7.3 (SDA)
/mainboard/U0RXD: J1.28, R12.2
/mainboard/U0TXD: J1.29, R11.2
/mainboard/VIN: C5.1, C9.1, R2.2, R3.2, U5.6 (EN), U5.7 (IN), U5.8 (IN__1), U11.1 (SYS)
GND: C1.1, C2.1, C3.2, C4.2, C5.2, C6.2, C7.2, C8.2, C9.2, C10.2, C11.2, C12.2, C13.2, C14.2, C15.2, C16.1, C17.1, C18.1, C19.2, C20.2, C21.2, C22.2, C23.2, C24.2, C25.1, C26.2, C27.2, J1.48, J1.49, J1.50, J3.1 (Pin_1_1), R4.2, R5.2, SW1.1, SW2.1, SW3.1, SW4.1, SW5.1, U1.1 (CTG), U1.4 (GND), U1.6 (QSTRT), U1.9 (EPAD), U3.2 (PGND), U3.4 (AGND), U3.9 (AGND), U4.2 (GND), U4.5 (EP), U5.5 (GND), U5.9 (EPAD), U6.1 (GND), U6.2 (GND), U6.42 (GND), U6.43 (GND), U6.46 (GND), U6.47 (GND), U6.48 (GND), U6.49 (GND), U6.50 (GND), U6.51 (GND), U6.52 (GND), U6.53 (GND), U6.54 (GND), U6.55 (GND), U6.56 (GND), U6.57 (GND), U6.58 (GND), U6.59 (GND), U6.60 (GND), U6.61 (GND), U6.62 (GND), U6.63 (GND), U6.64 (GND), U6.65 (GND), U7.4 (PGND), U7.12 (GND), U8.3 (CLKOE), U8.5 (VSS), U8.11 (EP), U9.A1 (VSA), U10.1 (SDO/SA0), U10.2 (SDX), U10.3 (SCX), U10.6 (GND), U10.7 (GND), U10.11 (SDO_Aux), U11.4 (~CE), U11.5 (GND), U11.11 (EP)
unnamed: C27.1, R17.1
unnamed: D1.2 (A), R2.1
unnamed: D1.1 (K), U11.3 (STAT2)
unnamed: D3.2 (A), R3.1
unnamed: D3.1 (K), U11.9 (STAT1)
unnamed: C20.1, D4.1 (K), R17.2, U8.10 (VDD)
unnamed: L1.2, U3.1 (SW)
unnamed: R7.1, U3.7 (/PG)
unnamed: NT1.2, U6.3 (3V3)
unnamed: R12.1, U6.40 (RXD0)
unnamed: R11.1, U6.39 (TXD0)
unnamed: R15.1, U7.13 (~INT)
unnamed: C17.2, U8.1 (OSCI), Y1.1
unnamed: C18.2, U8.2 (OSCO), Y1.2
unnamed: R4.1, U11.7 (ILIM/VSET)
unnamed: R5.1, U11.8 (ISET)
VBUS: C3.1, J2.1 (Pin_1_1), U11.10 (IN)

Notes on the sheet:
PEAK CURRENT (ACTIVE WIFI TX) = 340mA
REFERENCE DESIGN FROM SPARKFUN MAX30101 QWIC TYPICAL CURRENT CONSUMPTION 600-1000uA VCC RANGE: 1.7 - 2.0V VCC RED/IR LED: 3.1-5.0V VCC GREN LED: 4.5-5.5V I2C ADD: 0X57
500mAh LiPo
LSM6DS0 I2C ADD: 0X6A
LiPo BATTERY CHARGER AND POWER PATH MANAGEMENT INPUT CHARGE LIMIT = 1.1A BATTERY VOLTAGE = 4.2V CHARGE CURRENT = 300/R.ISET (A) CHARGE CURRENT = 483mA STAT1: LOW ON FAULT STAT2: LOW ON CHARGING BAT_NTC = 10K(25C) BETA(25/85)= 3435K NTC
1X ON SIDE // 2X ON OTHER SIDE TYP. WAKE,SELECT,MENU / UP / DOWN
LiPo BATTERY MONITORING I2C ADD: 0X36 HIBERNATE CURRENT = 3uA ACTIVE CURRENT = 23uA CONFIGURABLE ALERT -> LOW STATE-OF-CHARGE (DRIVES LOW)
CXHP2R7105R-TWX
DOCK CONFIG SOLDER PADS CONNECTS TO EXTERNAL 5V POWER PLUG
MMC5603 SUPPLY CURRENT: 1.3*(MEASUREMENT/S) [mA]
NMOSFET: Vth > 1.2V Vgs (TYP. 0.6V BODY DIODE VOLT DIFF) RE1C002UN = 1V Vth
1V8 LINEAR VOLTAGE REGULATOR OUTPUT CURRENT: 150mA QUIESCENT CURRENT: 29uA *INTENDED FOR MAINBOARD USE ONLY
5V BOOST SWITCHING REGULATOR INPUT 2.5-5.5V FIXED OUTPUT 5V 3.8A SWITCHING CURRENT 2MHz SWITCH FREQ.
3.3V REGULATOR OUTPUT CURRENT: 1A QUIESCENT CURRENT: 140uA
I2C ADD: 0X51 TYP.CURRENT = 0.22uA MINUTE/HALF-MINUTE INTERRUPTS
MOTION
POWER MANAGEMENT
RTC CLOCK
PROGRAMMABLE BUTTONS
ESP32-S3-MINI-1
PULSE OXIMETER AND HEART RATE SENSOR
PULLUPS / LEVEL SHIFTER
EXTERNAL CONNECTORS

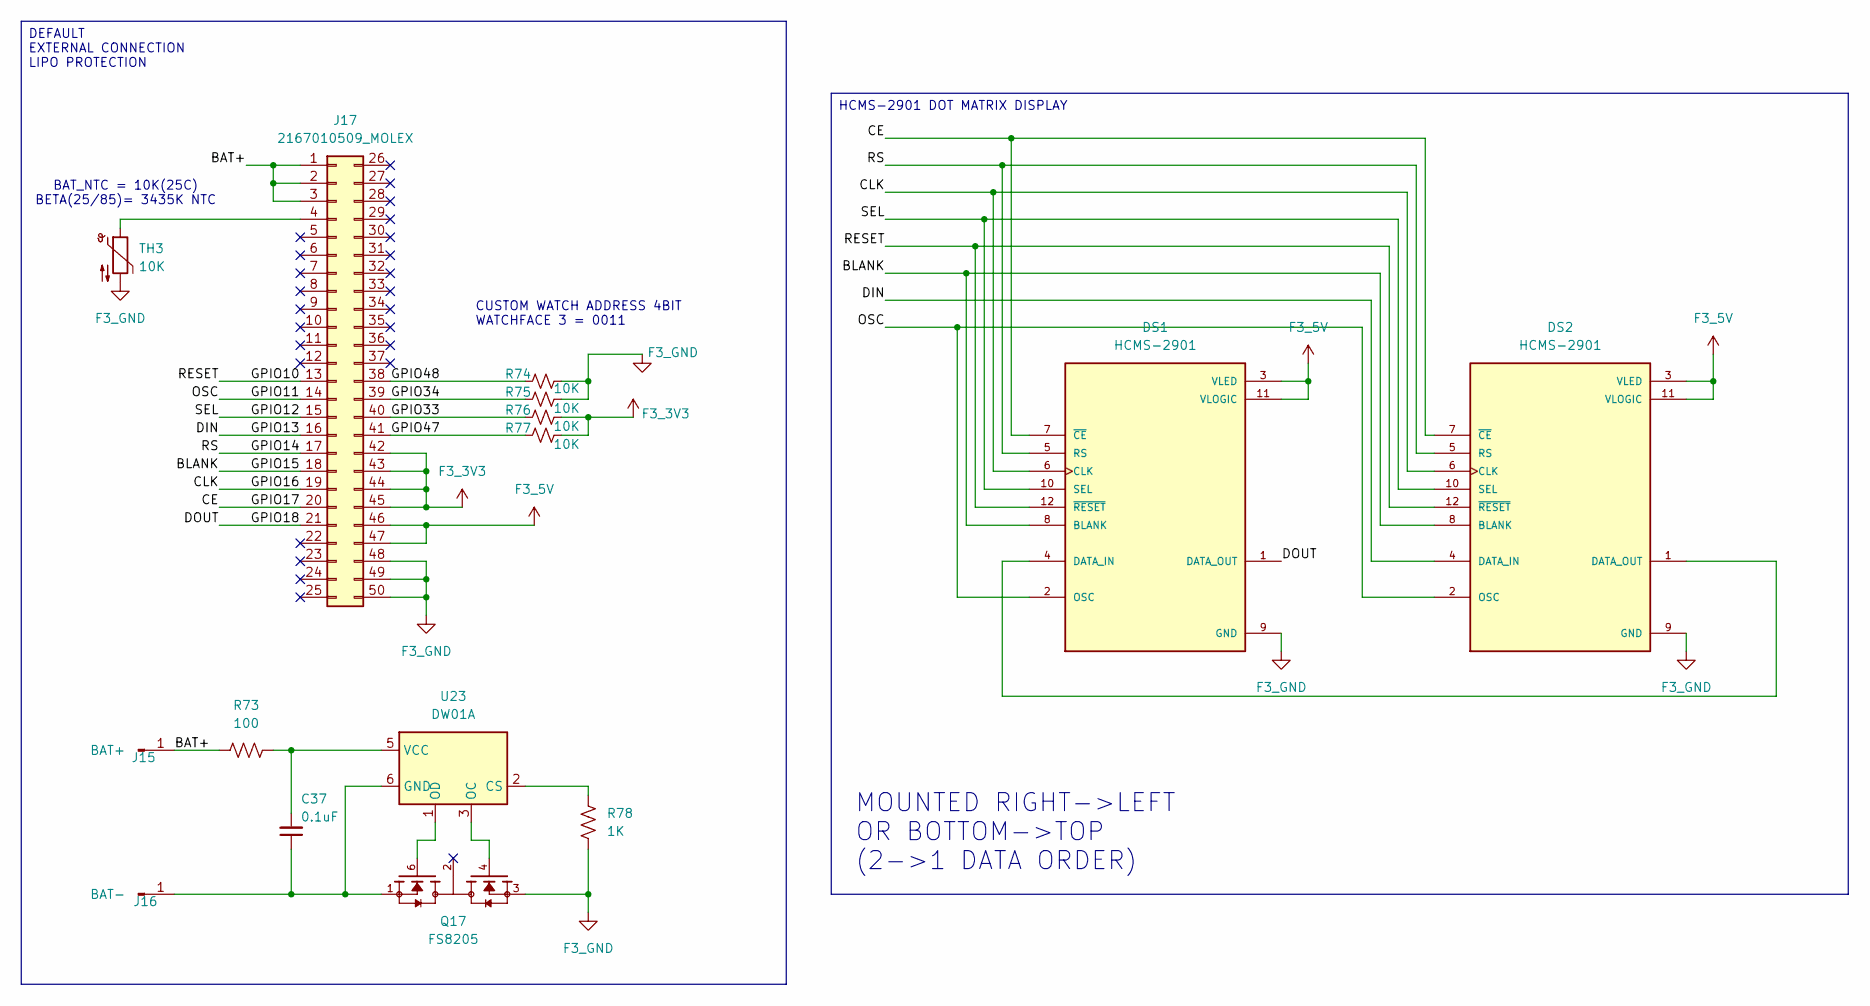
[picture p25: schematic face3.kicad_sch, PROTEUS SMARTWATCH]

Parts:
C37: 0.1uF; C_0402_1005Metric_Pad0.74x0.62mm_HandSolder
DS1, DS2: HCMS-2901; DIP-12_W7.62mm; PARTREV N/A
J15: BAT+; SolderWirePad_1x01_SMD_3x6mm
J16: BAT-; SolderWirePad_1x01_SMD_3x6mm
J17: 2167010509_MOLEX; CON_2167010509_MOL
Q17: FS8205; SOT95P280X145-6N; PARTREV 1.9
R73: 100; R_0402_1005Metric_Pad0.72x0.64mm_HandSolder
R74, R75, R76, R77: 10K; R_0402_1005Metric_Pad0.72x0.64mm_HandSolder
R78: 1K; R_0402_1005Metric_Pad0.72x0.64mm_HandSolder
TH3: 10K; R_0402_1005Metric_Pad0.72x0.64mm_HandSolder
U23: DW01A; SOT-23-6

Connections:
/face3/BAT+: J15.1 (Pin_1_1), J17.1, J17.2, J17.3, R73.1
/face3/BLANK: DS1.8 (BLANK), DS2.8 (BLANK), J17.18
/face3/CE: DS1.7 (~CE), DS2.7 (~CE), J17.20
/face3/CLK: DS1.6 (CLK), DS2.6 (CLK), J17.19
/face3/DIN: DS2.4 (DATA_IN), J17.16
/face3/DOUT: DS1.1 (DATA_OUT), J17.21
/face3/GPIO10: DS1.12 (~RESET), DS2.12 (~RESET), J17.13
/face3/GPIO11: DS1.2 (OSC), DS2.2 (OSC), J17.14
/face3/GPIO12: DS1.10 (SEL), DS2.10 (SEL), J17.15
/face3/GPIO14: DS1.5 (RS), DS2.5 (RS), J17.17
/face3/GPIO33: J17.40, R76.1
/face3/GPIO34: J17.39, R75.1
/face3/GPIO47: J17.41, R77.1
/face3/GPIO48: J17.38, R74.1
F3_3V3: J17.42, J17.43, J17.44, J17.45, R76.2, R77.2
F3_5V: DS1.3 (VLED), DS1.11 (VLOGIC), DS2.3 (VLED), DS2.11 (VLOGIC), J17.46, J17.47
F3_GND: DS1.9 (GND), DS2.9 (GND), J17.48, J17.49, J17.50, Q17.3, R74.2, R75.2, R78.1, TH3.2
unnamed: DS1.4 (DATA_IN), DS2.1 (DATA_OUT)
unnamed: C37.1, J16.1 (Pin_1_1), Q17.1, U23.6 (GND)
unnamed: J17.4, TH3.1
unnamed: R78.2, U23.2 (CS)
unnamed: Q17.4, U23.3 (OC)
unnamed: Q17.6, U23.1 (OD)
unnamed: C37.2, R73.2, U23.5 (VCC)

Notes on the sheet:
BAT_NTC = 10K(25C) BETA(25/85)= 3435K NTC
MOUNTED RIGHT->LEFT OR BOTTOM->TOP (2->1 DATA ORDER)
CUSTOM WATCH ADDRESS 4BIT WATCHFACE 3 = 0011
HCMS-2901 DOT MATRIX DISPLAY
DEFAULT EXTERNAL CONNECTION LIPO PROTECTION
