mechameka/satellite_watch/schematics/proteus_watch/proteus_watch.kicad_pcb

## KiCad design schematics/proteus_watch/proteus_watch.kicad_pcb (continued)

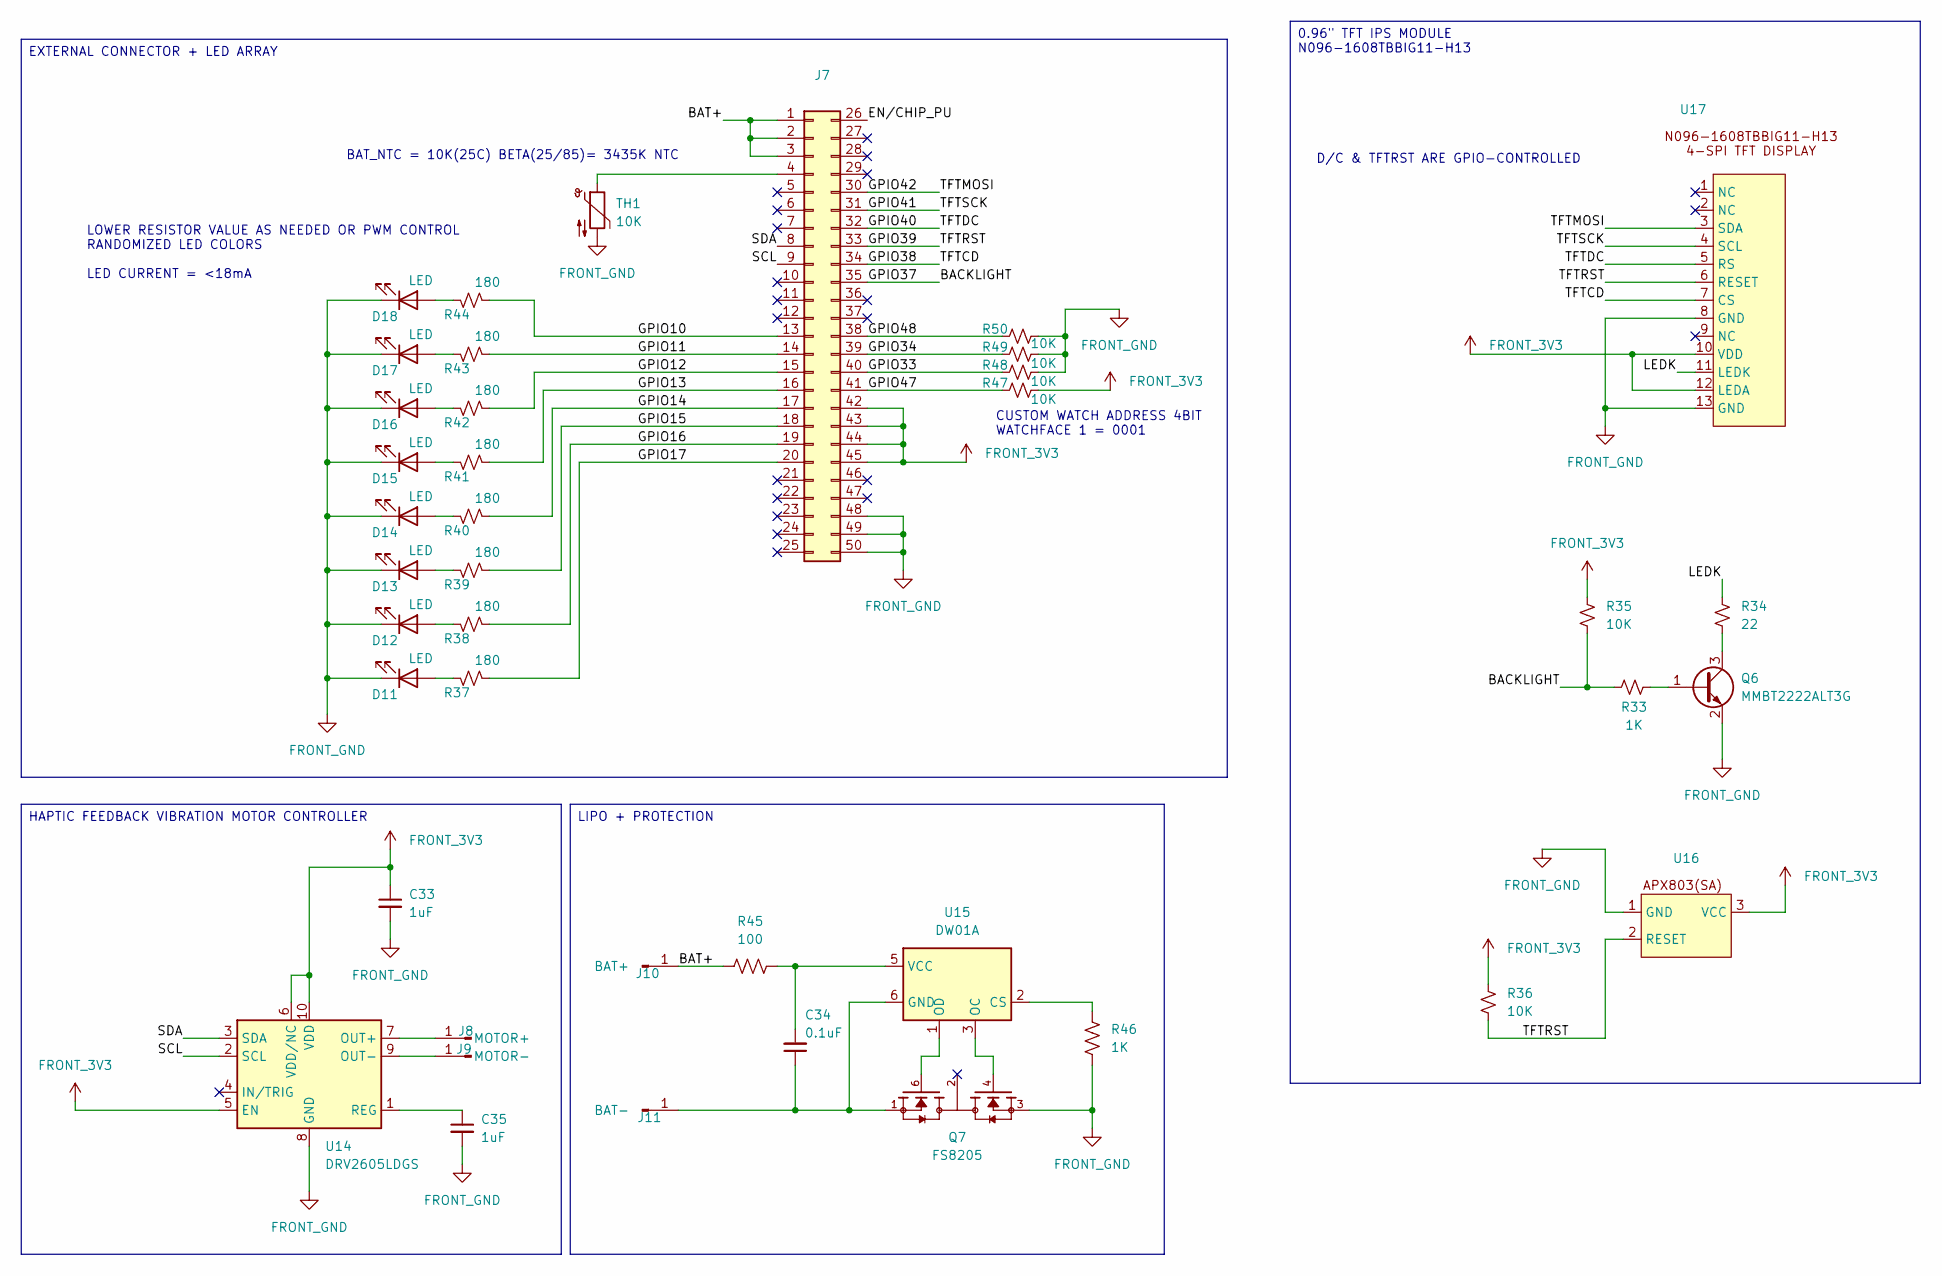
[picture p26: schematic face1.kicad_sch, PROTEUS SMARTWATCH]

Parts:
C33, C35: 1uF; C_0402_1005Metric_Pad0.74x0.62mm_HandSolder
C34: 0.1uF; C_0402_1005Metric_Pad0.74x0.62mm_HandSolder
D11, D12, D13, D14, D15, D16, D17, D18: LED; LED_1206_3216Metric_Pad1.42x1.75mm_HandSolder
J7: 2167010509_MOLEX; CON_2167010509_MOL
J8: MOTOR+; SolderWirePad_1x01_SMD_3x6mm
J9: MOTOR-; SolderWirePad_1x01_SMD_3x6mm
J10: BAT+; SolderWirePad_1x01_SMD_3x6mm
J11: BAT-; SolderWirePad_1x01_SMD_3x6mm
Q6: MMBT2222ALT3G; SOT-23
Q7: FS8205; SOT95P280X145-6N; PARTREV 1.9
R33, R46: 1K; R_0402_1005Metric_Pad0.72x0.64mm_HandSolder
R34: 22; R_0402_1005Metric_Pad0.72x0.64mm_HandSolder
R35, R36, R47, R48, R49, R50: 10K; R_0402_1005Metric_Pad0.72x0.64mm_HandSolder
R37, R38, R39, R40, R41, R42, R43, R44: 180; R_0402_1005Metric_Pad0.72x0.64mm_HandSolder
R45: 100; R_0402_1005Metric_Pad0.72x0.64mm_HandSolder
TH1: 10K; R_0402_1005Metric_Pad0.72x0.64mm_HandSolder
U14: DRV2605LDGS; TSSOP-10_3x3mm_P0.5mm
U15: DW01A; SOT-23-6
U16: SOT-23
U17: Wisevision N096-1608TBBIG11-H13

Connections:
/face1/BACKLIGHT: J7.35, R33.1, R35.1
/face1/BAT+: J7.1, J7.2, J7.3, J10.1 (Pin_1_1), R45.1
/face1/EN/CHIP_PU: J7.26
/face1/GPIO10: J7.13, R44.2
/face1/GPIO11: J7.14, R43.2
/face1/GPIO12: J7.15, R42.2
/face1/GPIO13: J7.16, R41.2
/face1/GPIO14: J7.17, R40.2
/face1/GPIO15: J7.18, R39.2
/face1/GPIO16: J7.19, R38.2
/face1/GPIO17: J7.20, R37.2
/face1/GPIO33: J7.40, R48.1
/face1/GPIO34: J7.39, R49.1
/face1/GPIO38: J7.34, U17.7 (CS)
/face1/GPIO39: J7.33, R36.1, U16.2 (RESET), U17.6 (RESET)
/face1/GPIO40: J7.32, U17.5 (RS)
/face1/GPIO41: J7.31, U17.4 (SCL)
/face1/GPIO42: J7.30, U17.3 (SDA)
/face1/GPIO47: J7.41, R47.1
/face1/GPIO48: J7.38, R50.1
/face1/LEDK: R34.2, U17.11 (LEDK)
/face1/SCL: J7.9, U14.2 (SCL)
/face1/SDA: J7.8, U14.3 (SDA)
FRONT_3V3: C33.1, J7.42, J7.43, J7.44, J7.45, R35.2, R36.2, R47.2, U14.5 (EN), U14.6 (VDD/NC), U14.10 (VDD), U16.3 (VCC), U17.10 (VDD), U17.12 (LEDA)
FRONT_GND: C33.2, C35.2, D11.1 (K), D12.1 (K), D13.1 (K), D14.1 (K), D15.1 (K), D16.1 (K), D17.1 (K), D18.1 (K), J7.48, J7.49, J7.50, Q6.2 (E), Q7.3, R46.1, R48.2, R49.2, R50.2, TH1.2, U14.8 (GND), U16.1 (GND), U17.8 (GND), U17.13 (GND)
unnamed: D11.2 (A), R37.1
unnamed: D12.2 (A), R38.1
unnamed: D13.2 (A), R39.1
unnamed: D14.2 (A), R40.1
unnamed: D15.2 (A), R41.1
unnamed: D16.2 (A), R42.1
unnamed: D17.2 (A), R43.1
unnamed: D18.2 (A), R44.1
unnamed: J7.4, TH1.1
unnamed: J8.1 (Pin_1_1), U14.7 (OUT+)
unnamed: J9.1 (Pin_1_1), U14.9 (OUT-)
unnamed: C34.1, J11.1 (Pin_1_1), Q7.1, U15.6 (GND)
unnamed: Q6.1 (B), R33.2
unnamed: Q6.3 (C), R34.1
unnamed: C35.1, U14.1 (REG)
unnamed: R46.2, U15.2 (CS)
unnamed: Q7.4, U15.3 (OC)
unnamed: Q7.6, U15.1 (OD)
unnamed: C34.2, R45.2, U15.5 (VCC)

Notes on the sheet:
BAT_NTC = 10K(25C) BETA(25/85)= 3435K NTC
D/C & TFTRST ARE GPIO-CONTROLLED
CUSTOM WATCH ADDRESS 4BIT WATCHFACE 1 = 0001
LOWER RESISTOR VALUE AS NEEDED OR PWM CONTROL RANDOMIZED LED COLORS LED CURRENT = <18mA
LIPO + PROTECTION
HAPTIC FEEDBACK VIBRATION MOTOR CONTROLLER
0.96" TFT IPS MODULE N096-1608TBBIG11-H13
EXTERNAL CONNECTOR + LED ARRAY

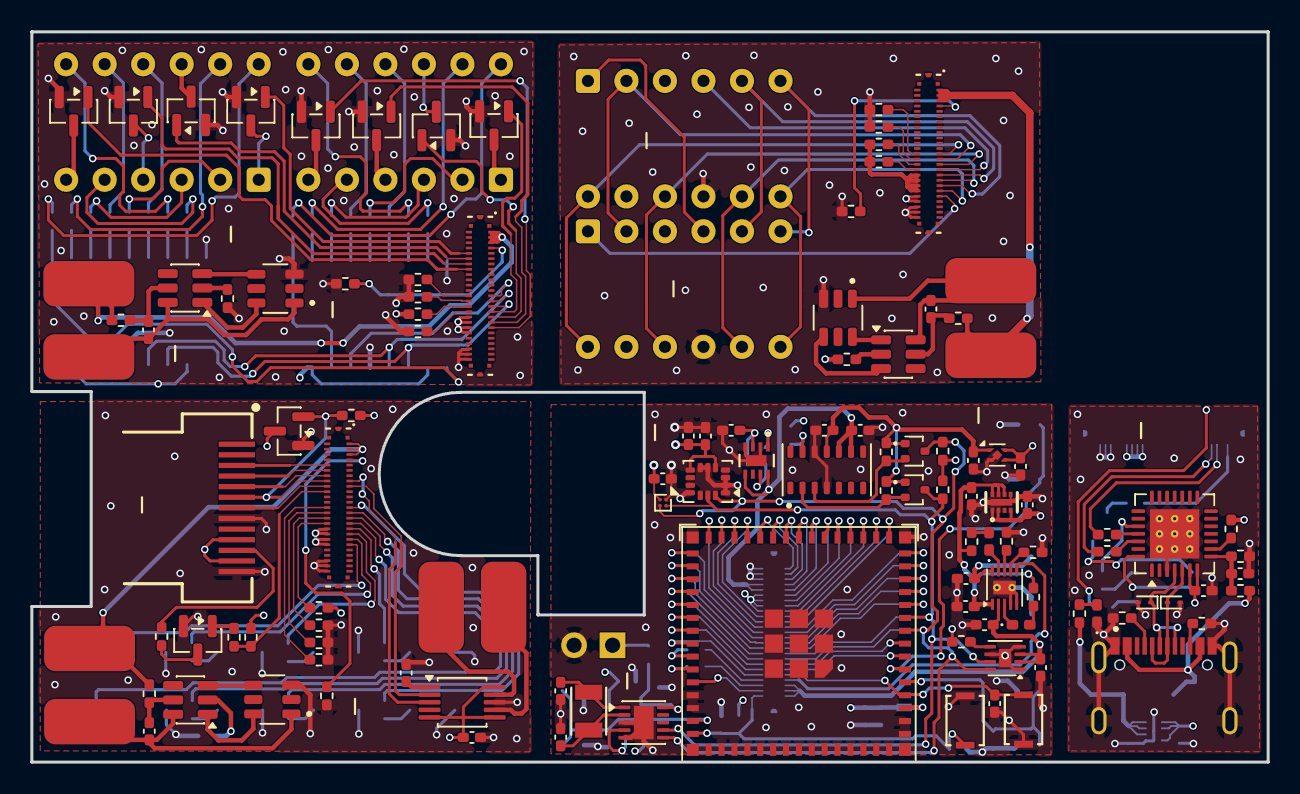
[picture p27: board proteus_watch.kicad_pcb from above]

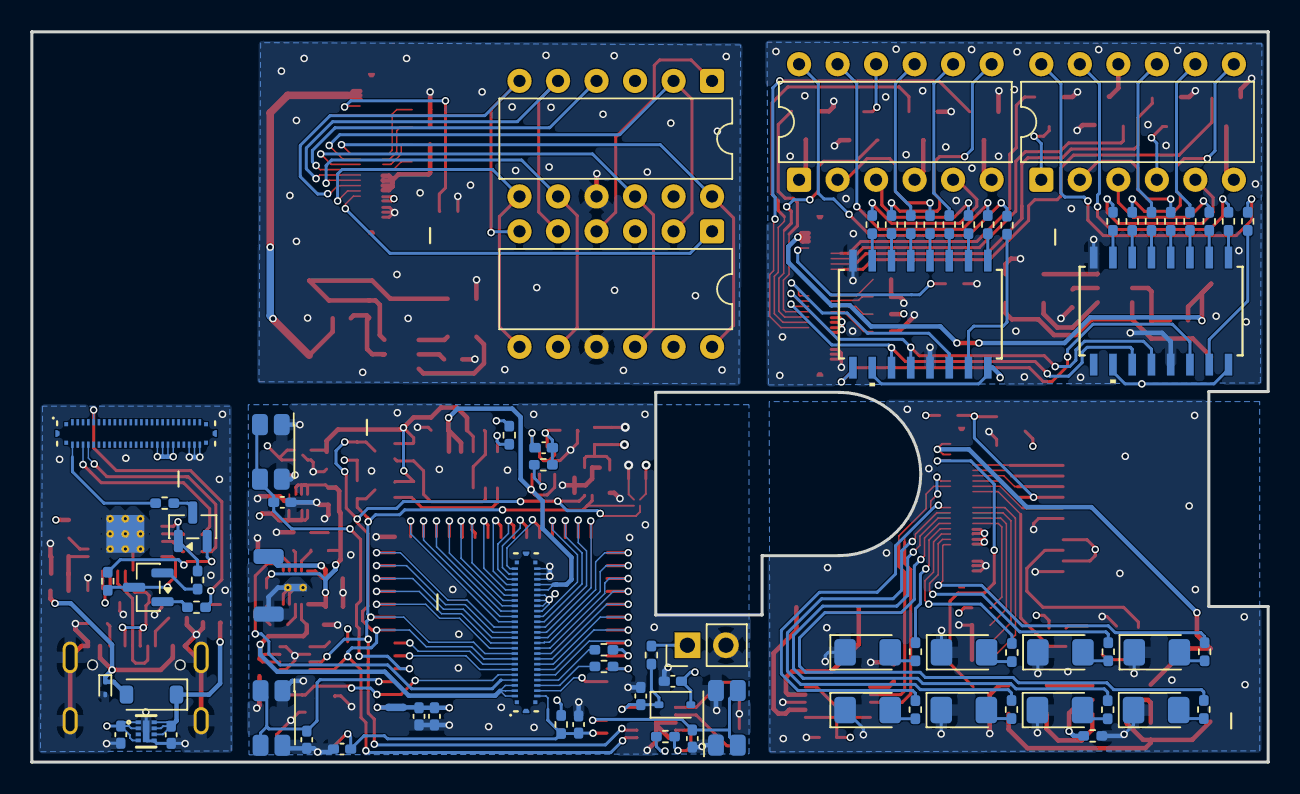
[picture p28: board proteus_watch.kicad_pcb from below]

Board: 4 copper layers, 81.5 x 48.2 mm, 193 parts (77 on the bottom side), 223 nets.
