mechameka/satellite_watch/schematics/satWatch_main/satWatch_main.kicad_pcb

## KiCad design schematics/satWatch_main/satWatch_main.kicad_pcb (2026-07-30)

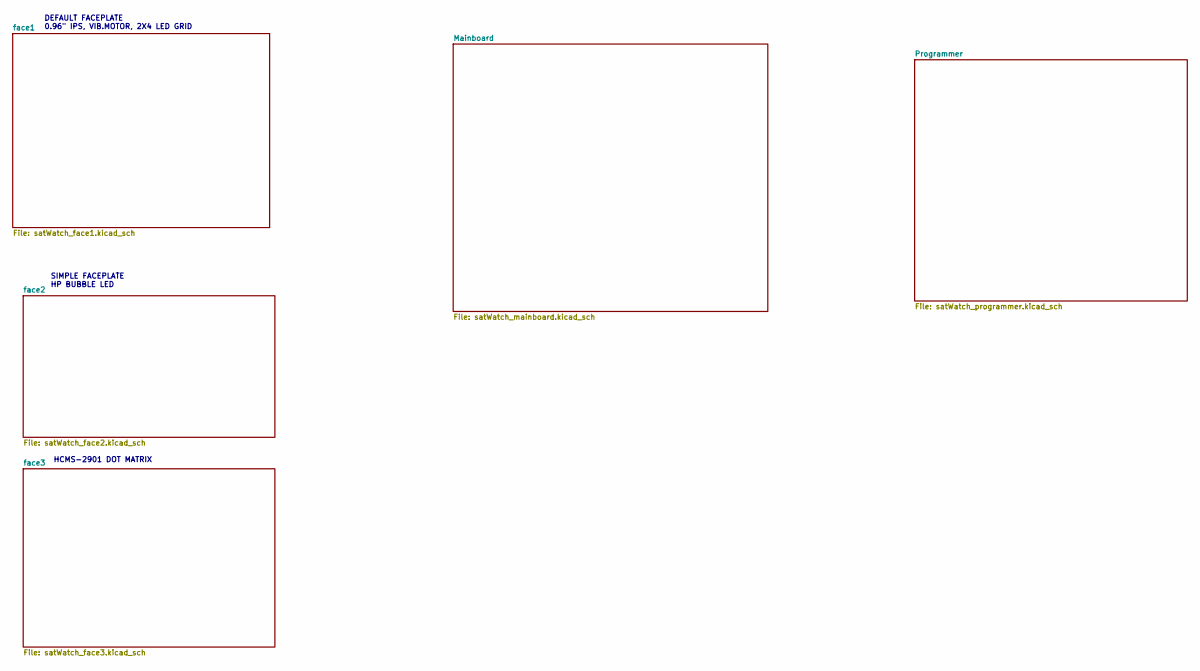
[picture p29: schematic satWatch_main.kicad_sch, satWatch]

Notes on the sheet:
HCMS-2901 DOT MATRIX
SIMPLE FACEPLATE HP BUBBLE LED
DEFAULT FACEPLATE 0.96" IPS, VIB.MOTOR, 2X4 LED GRID

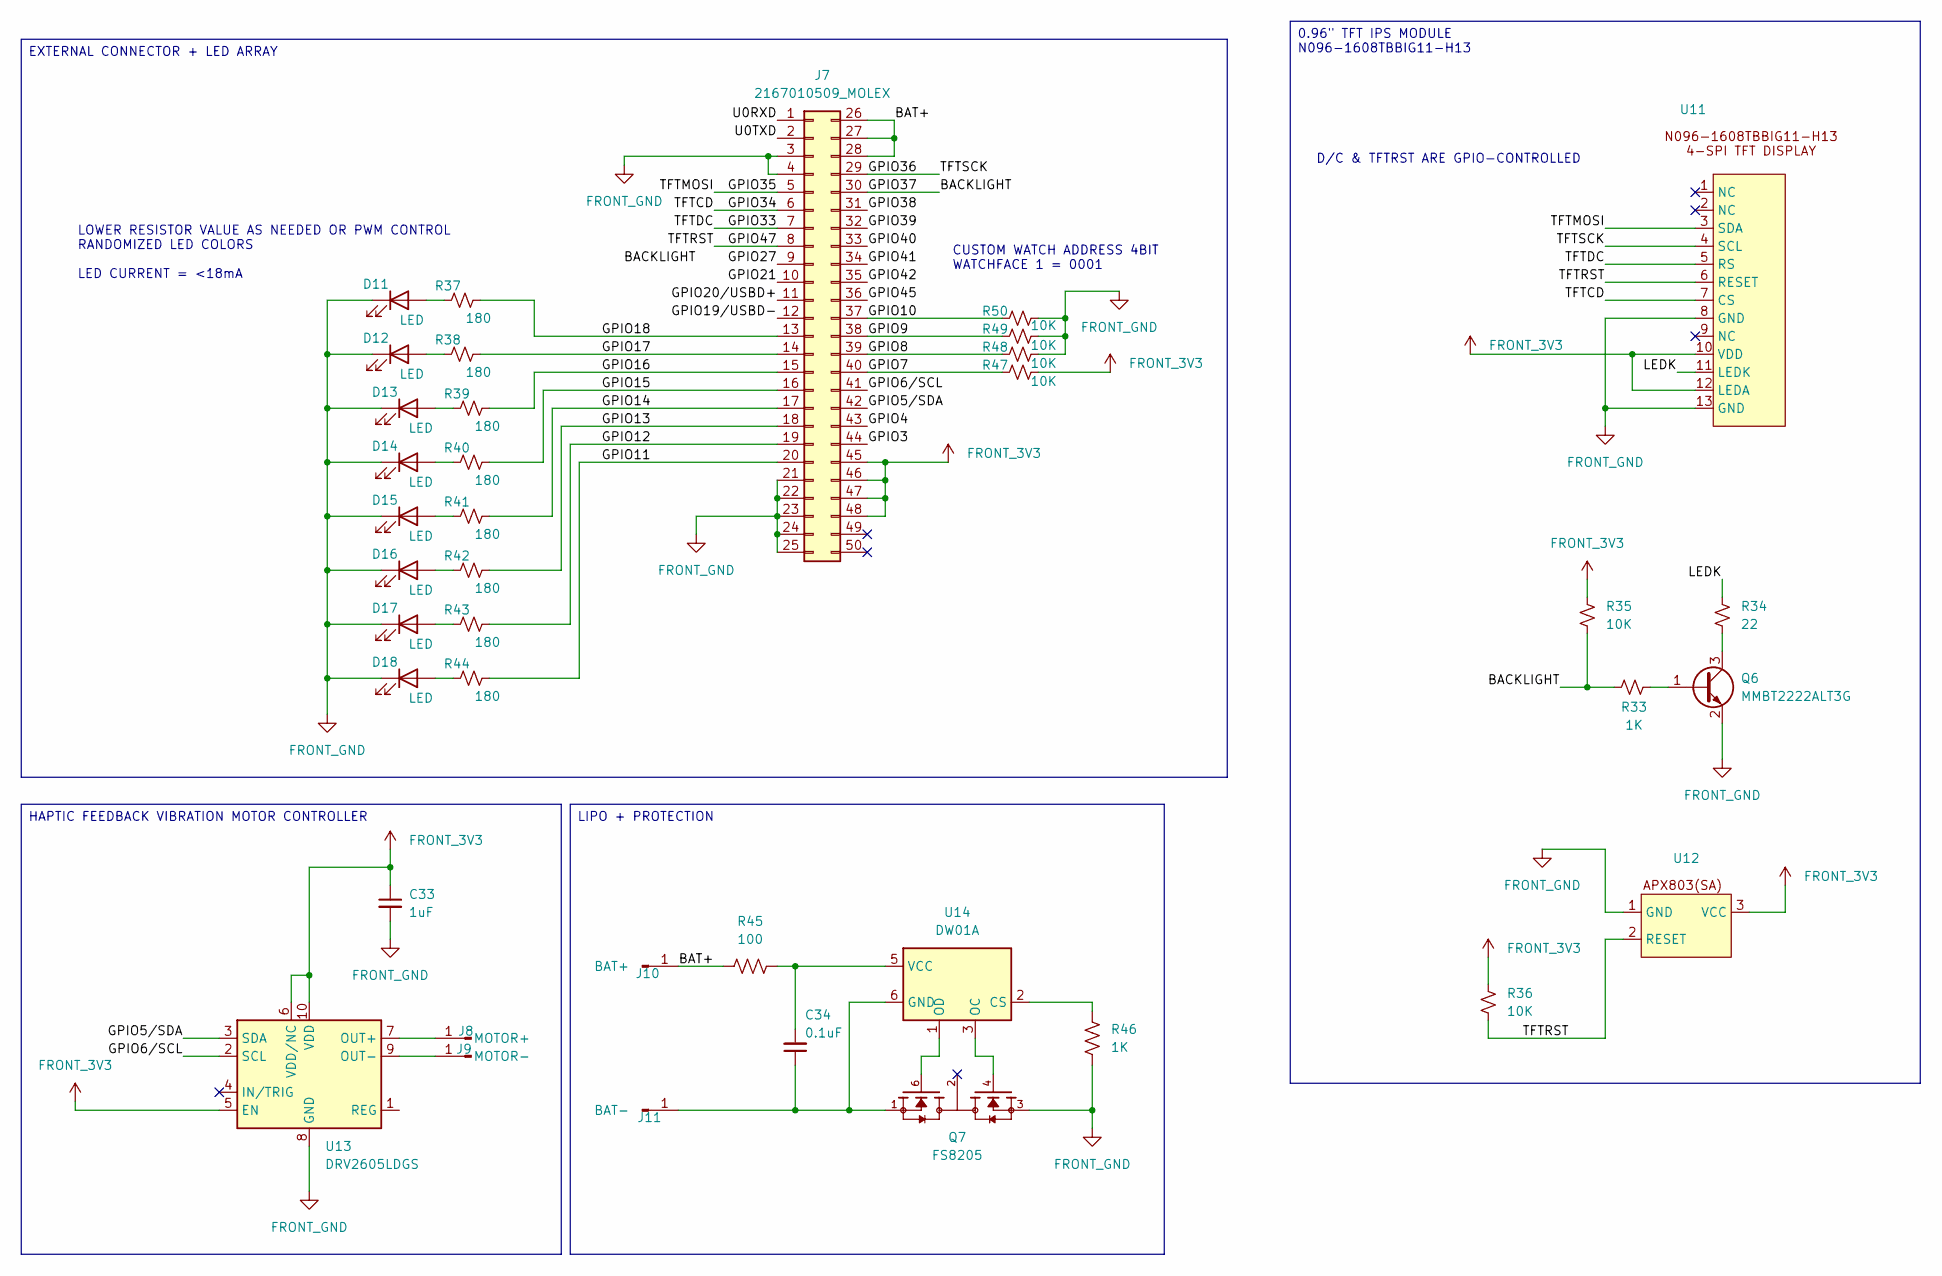
[picture p30: schematic satWatch_face1.kicad_sch, satWatch]

Parts:
C33: 1uF; C_0402_1005Metric_Pad0.74x0.62mm_HandSolder
C34: 0.1uF; C_0402_1005Metric_Pad0.74x0.62mm_HandSolder
D11, D12, D13, D14, D15, D16, D17, D18: LED; LED_1206_3216Metric_Pad1.42x1.75mm_HandSolder
J7: 2167010509_MOLEX; CON_2167010509_MOL
J8: MOTOR+; SolderWirePad_1x01_SMD_3x6mm
J9: MOTOR-; SolderWirePad_1x01_SMD_3x6mm
J10: BAT+; SolderWirePad_1x01_SMD_3x6mm
J11: BAT-; SolderWirePad_1x01_SMD_3x6mm
Q6: MMBT2222ALT3G; SOT-23
Q7: FS8205; SOT95P280X145-6N; PARTREV 1.9
R33, R46: 1K; R_0402_1005Metric_Pad0.72x0.64mm_HandSolder
R34: 22; R_0402_1005Metric_Pad0.72x0.64mm_HandSolder
R35, R36, R47, R48, R49, R50: 10K; R_0402_1005Metric_Pad0.72x0.64mm_HandSolder
R37, R38, R39, R40, R41, R42, R43, R44: 180; R_0402_1005Metric_Pad0.72x0.64mm_HandSolder
R45: 100; R_0402_1005Metric_Pad0.72x0.64mm_HandSolder
U11: Wisevision N096-1608TBBIG11-H13
U12: SOT-23
U13: DRV2605LDGS; TSSOP-10_3x3mm_P0.5mm
U14: DW01A; SOT-23-6

Connections:
/face1/BACKLIGHT: J7.30, R33.1, R35.1
/face1/BAT+: J7.26, J7.27, J7.28, J10.1 (Pin_1_1), R45.1
/face1/GPIO3: J7.44
/face1/GPIO4: J7.43
/face1/GPIO5/SDA: J7.42, U13.3 (SDA)
/face1/GPIO6/SCL: J7.41, U13.2 (SCL)
/face1/GPIO7: J7.40, R47.1
/face1/GPIO8: J7.39, R48.1
/face1/GPIO9: J7.38, R49.1
/face1/GPIO10: J7.37, R50.1
/face1/GPIO11: J7.20, R44.2
/face1/GPIO12: J7.19, R43.2
/face1/GPIO13: J7.18, R42.2
/face1/GPIO14: J7.17, R41.2
/face1/GPIO15: J7.16, R40.2
/face1/GPIO16: J7.15, R39.2
/face1/GPIO17: J7.14, R38.2
/face1/GPIO18: J7.13, R37.2
/face1/GPIO19/USBD-: J7.12
/face1/GPIO20/USBD+: J7.11
/face1/GPIO21: J7.10
/face1/GPIO27: J7.9
/face1/GPIO33: J7.7, U11.5 (RS)
/face1/GPIO34: J7.6, U11.7 (CS)
/face1/GPIO35: J7.5, U11.3 (SDA)
/face1/GPIO36: J7.29, U11.4 (SCL)
/face1/GPIO38: J7.31
/face1/GPIO39: J7.32
/face1/GPIO40: J7.33
/face1/GPIO41: J7.34
/face1/GPIO42: J7.35
/face1/GPIO45: J7.36
/face1/GPIO47: J7.8, R36.1, U11.6 (RESET), U12.2 (RESET)
/face1/LEDK: R34.2, U11.11 (LEDK)
/face1/U0RXD: J7.1
/face1/U0TXD: J7.2
FRONT_3V3: C33.1, J7.45, J7.46, J7.47, J7.48, R35.2, R36.2, R47.2, U11.10 (VDD), U11.12 (LEDA), U12.3 (VCC), U13.5 (EN), U13.6 (VDD/NC), U13.10 (VDD); also elsewhere on the board
FRONT_GND: C33.2, D11.1 (K), D12.1 (K), D13.1 (K), D14.1 (K), D15.1 (K), D16.1 (K), D17.1 (K), D18.1 (K), J7.3, J7.4, J7.21, J7.22, J7.23, J7.24, J7.25, Q6.2 (E), Q7.3, R46.1, R48.2, R49.2, R50.2, U11.8 (GND), U11.13 (GND), U12.1 (GND), U13.8 (GND); also elsewhere on the board
unnamed: D11.2 (A), R37.1
unnamed: D12.2 (A), R38.1
unnamed: D13.2 (A), R39.1
unnamed: D14.2 (A), R40.1
unnamed: D15.2 (A), R41.1
unnamed: D16.2 (A), R42.1
unnamed: D17.2 (A), R43.1
unnamed: D18.2 (A), R44.1
unnamed: J8.1 (Pin_1_1), U13.7 (OUT+)
unnamed: J9.1 (Pin_1_1), U13.9 (OUT-)
unnamed: C34.1, J11.1 (Pin_1_1), Q7.1, U14.6 (GND)
unnamed: Q6.1 (B), R33.2
unnamed: Q6.3 (C), R34.1
unnamed: R46.2, U14.2 (CS)
unnamed: Q7.4, U14.3 (OC)
unnamed: Q7.6, U14.1 (OD)
unnamed: C34.2, R45.2, U14.5 (VCC)

Notes on the sheet:
CUSTOM WATCH ADDRESS 4BIT WATCHFACE 1 = 0001
LOWER RESISTOR VALUE AS NEEDED OR PWM CONTROL RANDOMIZED LED COLORS LED CURRENT = <18mA
D/C & TFTRST ARE GPIO-CONTROLLED
LIPO + PROTECTION
EXTERNAL CONNECTOR + LED ARRAY
0.96" TFT IPS MODULE N096-1608TBBIG11-H13
HAPTIC FEEDBACK VIBRATION MOTOR CONTROLLER

Schematic: satWatch_mainboard.kicad_sch, satWatch

Parts:
BT1: 2895 (CR1220 Holder); BAT_2895; PARTREV B
C1, C3, C31, C32: 1uF; C_0402_1005Metric_Pad0.74x0.62mm_HandSolder
C2, C10, C17, C30: 10uF; C_0402_1005Metric_Pad0.74x0.62mm_HandSolder
C4: 22uF; C_0402_1005Metric_Pad0.74x0.62mm_HandSolder
C5, C7: 1uF/16V(10%); C_0402_1005Metric_Pad0.74x0.62mm_HandSolder
C6: 10uF/16V(10%); C_0402_1005Metric_Pad0.74x0.62mm_HandSolder
C8, C9, C11, C13, C14: 0.1uF/50V(10%); C_0402_1005Metric_Pad0.74x0.62mm_HandSolder
C12, C15, C16, C19, C29: 0.1uF; C_0402_1005Metric_Pad0.74x0.62mm_HandSolder
C18, C20: 22pF; C_0402_1005Metric_Pad0.74x0.62mm_HandSolder
C37: 1uF/6.3V; C_0402_1005Metric_Pad0.74x0.62mm_HandSolder
C38: 10uF/6.3V; C_0402_1005Metric_Pad0.74x0.62mm_HandSolder
D1: SDB14HS-AQ; D_SOD-323_HandSoldering
D8: DONE; LED_0402_1005Metric_Pad0.77x0.64mm_HandSolder
D9: CHRG; LED_0402_1005Metric_Pad0.77x0.64mm_HandSolder
D10: RED; LED_0402_1005Metric_Pad0.77x0.64mm_HandSolder
J1: 2167010509_MOLEX; CON_2167010509_MOL
J2: Pogo_02x03_UARTPROG; CUSTOM_POGO_02X03
J5, J6: SOLDER POINT; SolderWire-0.25sqmm_1x01_D0.65mm_OD1.7mm
L1: 2.2Uh; L_0402_1005Metric_Pad0.77x0.64mm_HandSolder
Q1: DMP1045U; SOT-23-3; PARTREV 7 - 2
Q2, Q3: RE1C002UN; SOT-416
R1, R14: 10K; R_0402_1005Metric_Pad0.72x0.64mm_HandSolder
R2: 100K; R_0402_1005Metric_Pad0.72x0.64mm_HandSolder
R3: 750K; R_0402_1005Metric_Pad0.72x0.64mm_HandSolder
R4, R8, R11, R13: 2.2K; R_0402_1005Metric_Pad0.72x0.64mm_HandSolder
R5: 10K(1%); R_0402_1005Metric_Pad0.72x0.64mm_HandSolder
R6: 499; R_0402_1005Metric_Pad0.72x0.64mm_HandSolder
R7, R9: 0; R_0402_1005Metric_Pad0.72x0.64mm_HandSolder
R10, R12: 220K; R_0402_1005Metric_Pad0.72x0.64mm_HandSolder
R15: 4.7K; R_0402_1005Metric_Pad0.72x0.64mm_HandSolder
R29, R30: 1K; R_0402_1005Metric_Pad0.72x0.64mm_HandSolder
R31: 1.2k; R_0402_1005Metric_Pad0.72x0.64mm_HandSolder
R32: 5.1K(1%); R_0402_1005Metric_Pad0.72x0.64mm_HandSolder
SW1, SW2: R-667995; R-667995_MIT-L
SW3, SW4, SW5: EVQ-P7A01P; SW_SPST_EVQP7A
U1: PAM2401SCADJ; MSOP8_DIO
U2: MIC5365-1.8YC5; SOT-353_SC-70-5
U3: ESP32-S3-MINI-1
U4: MAX30101EFD_T; MAX30101EFD+T; PARTREV 2
U5: BNO085; IC_BNO085; PARTREV v1.17
U6: DS3231MZ; SOIC-8_3.9x4.9mm_P1.27mm
U9: TP4056-42-ESOP8; SOIC-8-1EP_3.9x4.9mm_P1.27mm_EP2.41x3.3mm_ThermalVias
U10: NCP186AMX330TAG; PSON40P160X120X45-9N; PARTREV Rev.5
U21: ADP5063; QFN-20-1EP_4x4mm_P0.5mm_EP2.5x2.5mm
U22: AXP2101; QFN-40-1EP_5x5mm_P0.4mm_EP3.6x3.6mm_ThermalVias
Y1: 32.768Hz; ABS07-32.768KHZ-T

Connections:
1V8: C3.1, C12.1, Q2.1 (G), Q3.1 (G), R4.1, R11.1, U2.5 (VOUT), U4.11 (VDD)
3V3: C1.1, C2.1, C5.1, C6.1, C16.1, C17.1, C19.1, D1.1 (K), J1.45, J1.46, J1.47, J1.48, L1.1, Q1.2, R5.1, R8.1, R13.1, R14.1, R15.2, U1.2 (EN), U1.3 (VIN), U2.1 (VIN), U2.3 (EN), U3.3 (3V3), U5.3 (VDD), U5.11 (~RST), U5.28 (VDDIO), U6.2 (VCC)
5V: C4.1, C10.2, J1.49, J1.50, R3.2, U1.7 (OUT), U4.9 (VLED+), U4.10 (VLED+__1)
/Mainboard/BAT+: C30.1, J1.26, J1.27, J1.28, Q1.3, R10.2, U9.5 (BAT)
/Mainboard/BATTERY_MONITOR: R9.1, U3.30 (IO48)
/Mainboard/EN/CHIP_PU: C7.1, C9.1, J2.3, R5.2, SW2.2, U3.45 (EN)
/Mainboard/GPIO0/BOOT: C8.1, J2.6, SW1.2, U3.4 (IO0)
/Mainboard/GPIO1/BUTTON1: C11.1, SW3.2, U3.5 (IO1)
/Mainboard/GPIO2/BUTTON3: C14.1, SW5.2, U3.6 (IO2)
/Mainboard/GPIO3: J1.44, U3.7 (IO3)
/Mainboard/GPIO4: J1.43, U3.8 (IO4)
/Mainboard/GPIO5/SDA: J1.42, Q3.3 (D), R13.2, U3.9 (IO5), U5.20 (H_SDA/H_MISO/TX), U6.7 (SDA)
/Mainboard/GPIO6/SCL: J1.41, Q2.3 (D), R8.2, U3.10 (IO6), U5.19 (H_SCL/SCK/RX), U6.8 (SCL)
/Mainboard/GPIO7: J1.40, U3.11 (IO7)
/Mainboard/GPIO8: J1.39, U3.12 (IO8)
/Mainboard/GPIO9: J1.38, U3.13 (IO9)
/Mainboard/GPIO10: J1.37, U3.14 (IO10)
/Mainboard/GPIO11: J1.20, U3.15 (IO11)
/Mainboard/GPIO12: J1.19, U3.16 (IO12)
/Mainboard/GPIO13: J1.18, U3.17 (IO13)
/Mainboard/GPIO14: J1.17, U3.18 (IO14)
/Mainboard/GPIO15: J1.16, U3.19 (IO15)
/Mainboard/GPIO16: J1.15, U3.20 (IO16)
/Mainboard/GPIO17: J1.14, U3.21 (IO17)
/Mainboard/GPIO18: J1.13, U3.22 (IO18)
/Mainboard/GPIO19/USBD-: J1.12, U3.23 (USB_D-)
/Mainboard/GPIO20/USBD+: J1.11, U3.24 (USB_D+)
/Mainboard/GPIO21: J1.10, U3.25 (IO21)
/Mainboard/GPIO27: J1.9, U3.26 (IO26)
/Mainboard/GPIO33: J1.7, U3.28 (IO33)
/Mainboard/GPIO34: J1.6, U3.29 (IO34)
/Mainboard/GPIO35: J1.5, U3.31 (IO35)
/Mainboard/GPIO36: J1.29, U3.32 (IO36)
/Mainboard/GPIO37: J1.30, U3.33 (IO37)
/Mainboard/GPIO38: J1.31, U3.34 (IO38)
/Mainboard/GPIO39: J1.32, U3.35 (IO39)
/Mainboard/GPIO40: J1.33, U3.36 (IO40)
/Mainboard/GPIO41: J1.34, U3.37 (IO41)
/Mainboard/GPIO42: J1.35, U3.38 (IO42)
/Mainboard/GPIO45: J1.36, U3.41 (IO45)
/Mainboard/GPIO46/BUTTON2: C13.1, SW4.2, U3.44 (IO46)
/Mainboard/GPIO47: J1.8, U3.27 (IO47)
/Mainboard/LV_SCL: Q2.2 (S), R4.2, U4.2 (SCL)
/Mainboard/LV_SDA: Q3.2 (S), R11.2, U4.3 (SDA)
/Mainboard/U0RXD: J1.1, J2.4, R7.2
/Mainboard/U0TXD: J1.2, J2.5, R6.2
/Mainboard/VDOCK_5V: C29.1, C31.1, D8.2 (A), D9.2 (A), J5.1 (Pin_1_1), U9.4 (V_{CC}), U9.8 (CE), U10.6 (EN), U10.7 (IN), U10.8 (IN__1)
GND: BT1.N, C1.2, C2.2, C3.2, C4.2, C5.2, C6.2, C7.2, C8.2, C9.2, C10.1, C11.2, C12.2, C13.2, C14.2, C15.2, C16.2, C17.2, C18.2, C19.2, C20.2, C29.2, C30.2, C31.2, C32.2, C37.1, C38.1, D10.1 (K), J1.3, J1.4, J1.21, J1.22, J1.23, J1.24, J1.25, J2.2, J6.1 (Pin_1_1), R1.2, R2.2, R12.2, R31.2, SW1.1, SW2.1, SW3.1, SW4.1, SW5.1, U1.4 (AGND), U1.8 (PGND), U2.2 (GND), U3.1 (GND), U3.2 (GND), U3.42 (GND), U3.43 (GND), U3.46 (GND), U3.47 (GND), U3.48 (GND), U3.49 (GND), U3.50 (GND), U3.51 (GND), U3.52 (GND), U3.53 (GND), U3.54 (GND), U3.55 (GND), U3.56 (GND), U3.57 (GND), U3.58 (GND), U3.59 (GND), U3.60 (GND), U3.61 (GND), U3.62 (GND), U3.63 (GND), U3.64 (GND), U3.65 (GND), U4.4 (PGND), U4.12 (GND), U5.2 (GND), U5.5 (PS1), U5.6 (PS0/WAKE), U5.10 (CLKSEL0), U5.17 (SA0/H_MOSI), U5.18 (~H_CS), U5.25 (GNDIO), U6.5 (GND), U9.1 (TEMP), U9.3 (GND), U9.9 (EPAD), U10.5 (GND), U10.9 (EPAD), U22.3 (GND), U22.40 (SCK)
unnamed: C37.2, U22.2 (VREF)
unnamed: C38.2, U22.37 (VBUS)
unnamed: D8.1 (K), R29.1
unnamed: D9.1 (K), R30.1
unnamed: D10.2 (A), R32.2
unnamed: R9.2, R10.1, R12.1
unnamed: R2.1, R3.1, U1.5 (FB)
unnamed: L1.2, U1.1 (LX)
unnamed: R7.1, U3.40 (RXD0)
unnamed: R6.1, U3.39 (TXD0)
unnamed: R15.1, U4.13 (~INT)
unnamed: C15.1, U5.9 (CAP)
unnamed: C20.1, U5.27 (XIN32), Y1.1
unnamed: C18.1, U5.26 (XOUT32/CLKSEL1), Y1.2
unnamed: R14.2, U5.4 (~BOOT)
unnamed: BT1.P1, BT1.P2, U6.6 (VBAT)
unnamed: R31.1, U9.2 (PROG)
unnamed: R30.2, U9.7 (~CHRG)
unnamed: R29.2, U9.6 (~STDBY)
unnamed: U21.6 (VINx), U21.7 (VINx), U21.8 (VINx)
unnamed: U21.9 (ISO_Sx), U21.10 (ISO_Sx), U21.11 (ISO_Sx)
unnamed: U21.12 (ISO_Bx), U21.13 (ISO_Bx), U21.14 (ISO_Bx)
VIN_3V3: C32.1, D1.2 (A), J2.1, Q1.1, R1.1, R32.1, U10.1 (OUT), U10.2 (OUT__1), U10.4 (FB/ADJ)

Notes on the sheet:
MOUNTS TO AN EXTERNAL CHARGING DOCK BATTERY OVERCHARGE/DISCHARGE (DW01A) TYPICALLY INCLUDED IN FACEPLATE 1000mAh/1A
SWITCHES BETWEEN FRONT PANEL POWER AND PROGRAMMER-SUPPLIED POWER
POPULATE ONLY FOR DOCKUNIT SETUP
NMOSFET: Vth > 1.2V Vgs (TYP. 0.6V BODY DIODE VOLT DIFF) RE1C002UN = 1V Vth
1X ON SIDE // 2X ON OTHER SIDE TYP. WAKE,SELECT,MENU / UP / DOWN
3.3V REGULATOR OUTPUT CURRENT: 1A QUIESCENT CURRENT: 140uA
DC-DC CONVERTER TO 5V FOR MAX30101 INPUT: 2.4-4.75V
REFERENCE DESIGN FROM SPARKFUN MAX30101 QWIC TYPICAL CURRENT CONSUMPTION 600-1000uA VCC RANGE: 1.7 - 2.0V VCC RED/IR LED: 3.1-5.0V VCC GREN LED: 4.5-5.5V I2C ADD: 0X57
I2C ADD: 0X4A (SA0 PULLED TO 0) RESET CONTROL DISABLED (PULLED HIGH)
1.8V REGULATOR OUTPUT CURRENT: 150mA QUIESCENT CURRENT: 29uA
PROGRAMMABLE BUTTONS
POWER LOAD SHARING PROTECTION
POWER REGULATION
PULSE OXIMETER AND HEART RATE SENSOR
EXTERNAL CONNECTORS
9AXIS IMU BNO085
**DOCK CONFIGURATION**
ESP32-S3-MINI-1
RTC CLOCK
LIPO BATTERY CHARGER
DIAGNOSTIC BUTTONS
PULLUPS / LEVEL SHIFTER
WATCHBODY CONFIGURATION

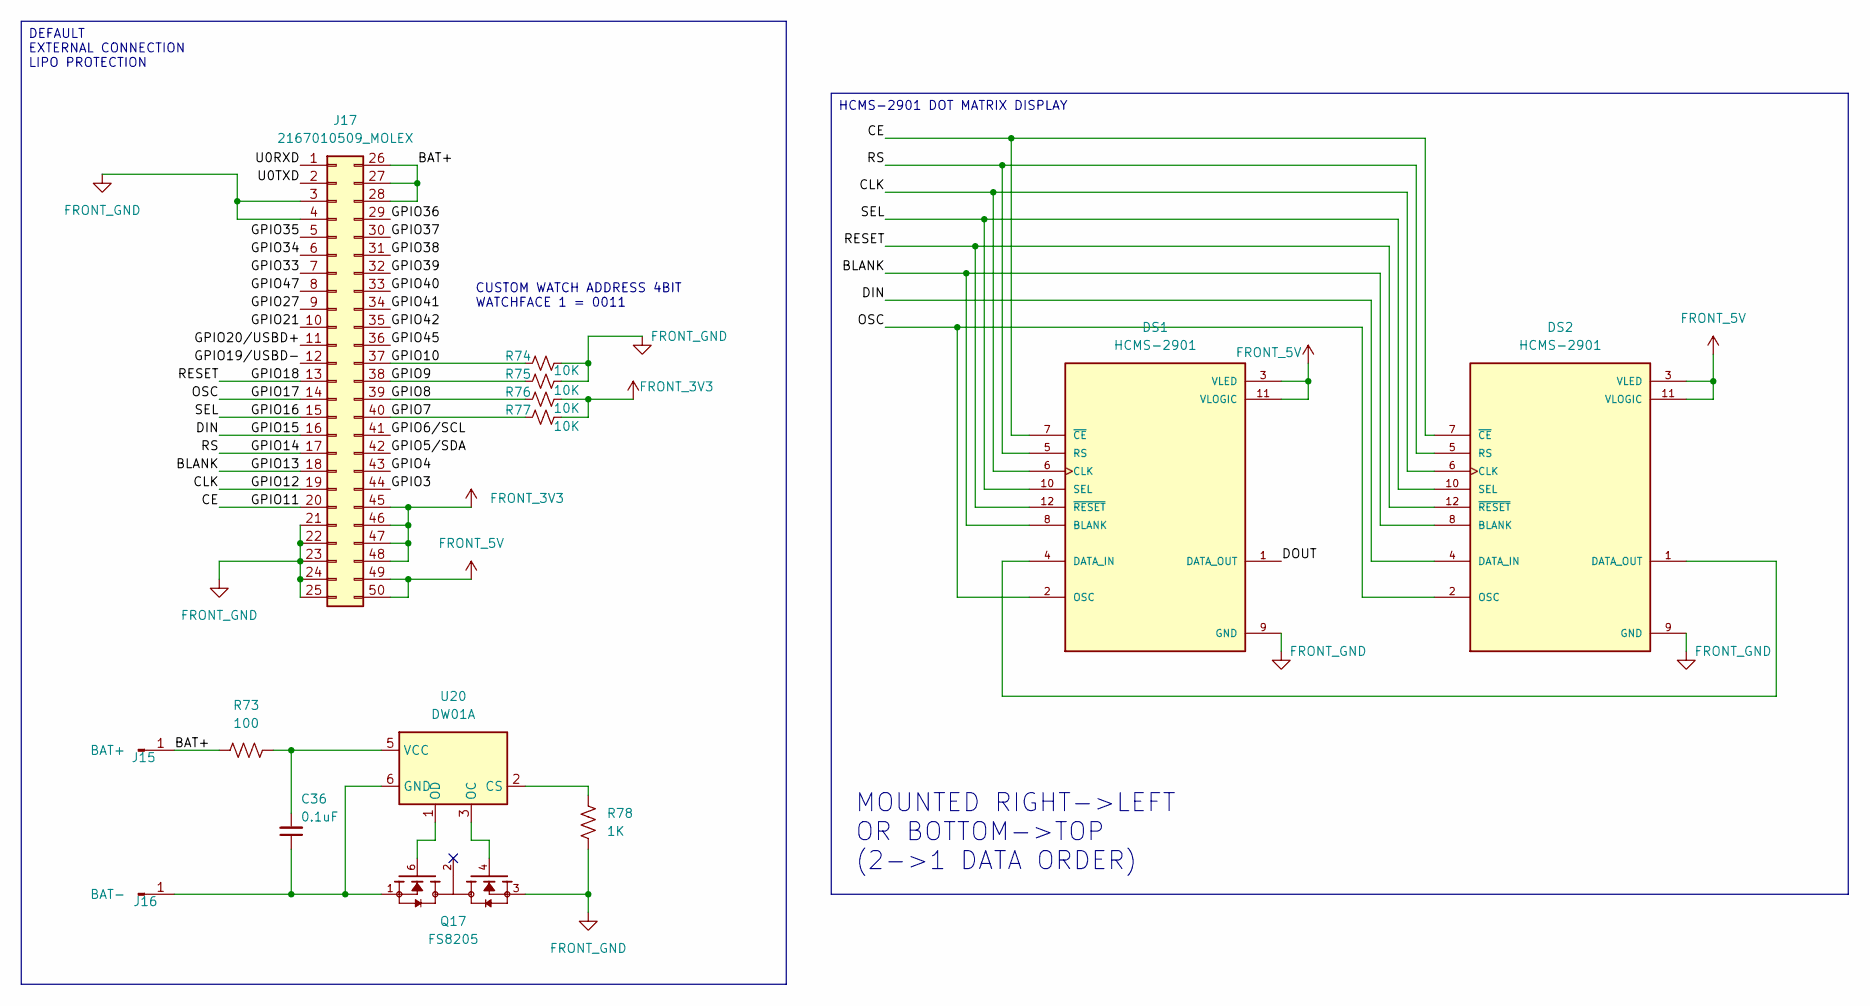
[picture p31: schematic satWatch_face3.kicad_sch, satWatch]

Parts:
C36: 0.1uF; C_0402_1005Metric_Pad0.74x0.62mm_HandSolder
DS1, DS2: HCMS-2901; DIP-12_W7.62mm; PARTREV N/A
J15: BAT+; SolderWirePad_1x01_SMD_3x6mm
J16: BAT-; SolderWirePad_1x01_SMD_3x6mm
J17: 2167010509_MOLEX; CON_2167010509_MOL
Q17: FS8205; SOT95P280X145-6N; PARTREV 1.9
R73: 100; R_0402_1005Metric_Pad0.72x0.64mm_HandSolder
R74, R75, R76, R77: 10K; R_0402_1005Metric_Pad0.72x0.64mm_HandSolder
R78: 1K; R_0402_1005Metric_Pad0.72x0.64mm_HandSolder
U20: DW01A; SOT-23-6

Connections:
/face3/BAT+: J15.1 (Pin_1_1), J17.26, J17.27, J17.28, R73.1
/face3/BLANK: DS1.8 (BLANK), DS2.8 (BLANK), J17.18
/face3/CE: DS1.7 (~CE), DS2.7 (~CE), J17.20
/face3/CLK: DS1.6 (CLK), DS2.6 (CLK), J17.19
/face3/DIN: DS2.4 (DATA_IN), J17.16
/face3/DOUT: DS1.1 (DATA_OUT)
/face3/GPIO3: J17.44
/face3/GPIO4: J17.43
/face3/GPIO5/SDA: J17.42
/face3/GPIO6/SCL: J17.41
/face3/GPIO7: J17.40, R77.1
/face3/GPIO8: J17.39, R76.1
/face3/GPIO9: J17.38, R75.1
/face3/GPIO10: J17.37, R74.1
/face3/GPIO14: DS1.5 (RS), DS2.5 (RS), J17.17
/face3/GPIO16: DS1.10 (SEL), DS2.10 (SEL), J17.15
/face3/GPIO17: DS1.2 (OSC), DS2.2 (OSC), J17.14
/face3/GPIO18: DS1.12 (~RESET), DS2.12 (~RESET), J17.13
/face3/GPIO19/USBD-: J17.12
/face3/GPIO20/USBD+: J17.11
/face3/GPIO21: J17.10
/face3/GPIO27: J17.9
/face3/GPIO33: J17.7
/face3/GPIO34: J17.6
/face3/GPIO35: J17.5
/face3/GPIO36: J17.29
/face3/GPIO37: J17.30
/face3/GPIO38: J17.31
/face3/GPIO39: J17.32
/face3/GPIO40: J17.33
/face3/GPIO41: J17.34
/face3/GPIO42: J17.35
/face3/GPIO45: J17.36
/face3/GPIO47: J17.8
/face3/U0RXD: J17.1
/face3/U0TXD: J17.2
FRONT_3V3: J17.45, J17.46, J17.47, J17.48, R76.2, R77.2; also elsewhere on the board
FRONT_5V: DS1.3 (VLED), DS1.11 (VLOGIC), DS2.3 (VLED), DS2.11 (VLOGIC), J17.49, J17.50
FRONT_GND: DS1.9 (GND), DS2.9 (GND), J17.3, J17.4, J17.21, J17.22, J17.23, J17.24, J17.25, Q17.3, R74.2, R75.2, R78.1; also elsewhere on the board
unnamed: DS1.4 (DATA_IN), DS2.1 (DATA_OUT)
unnamed: C36.1, J16.1 (Pin_1_1), Q17.1, U20.6 (GND)
unnamed: R78.2, U20.2 (CS)
unnamed: Q17.4, U20.3 (OC)
unnamed: Q17.6, U20.1 (OD)
unnamed: C36.2, R73.2, U20.5 (VCC)

Notes on the sheet:
MOUNTED RIGHT->LEFT OR BOTTOM->TOP (2->1 DATA ORDER)
CUSTOM WATCH ADDRESS 4BIT WATCHFACE 1 = 0011
DEFAULT EXTERNAL CONNECTION LIPO PROTECTION
HCMS-2901 DOT MATRIX DISPLAY
