mechameka/satellite_watch/schematics/satWatch_main/satWatch_main.kicad_pcb

## KiCad design schematics/satWatch_main/satWatch_main.kicad_pcb (continued)

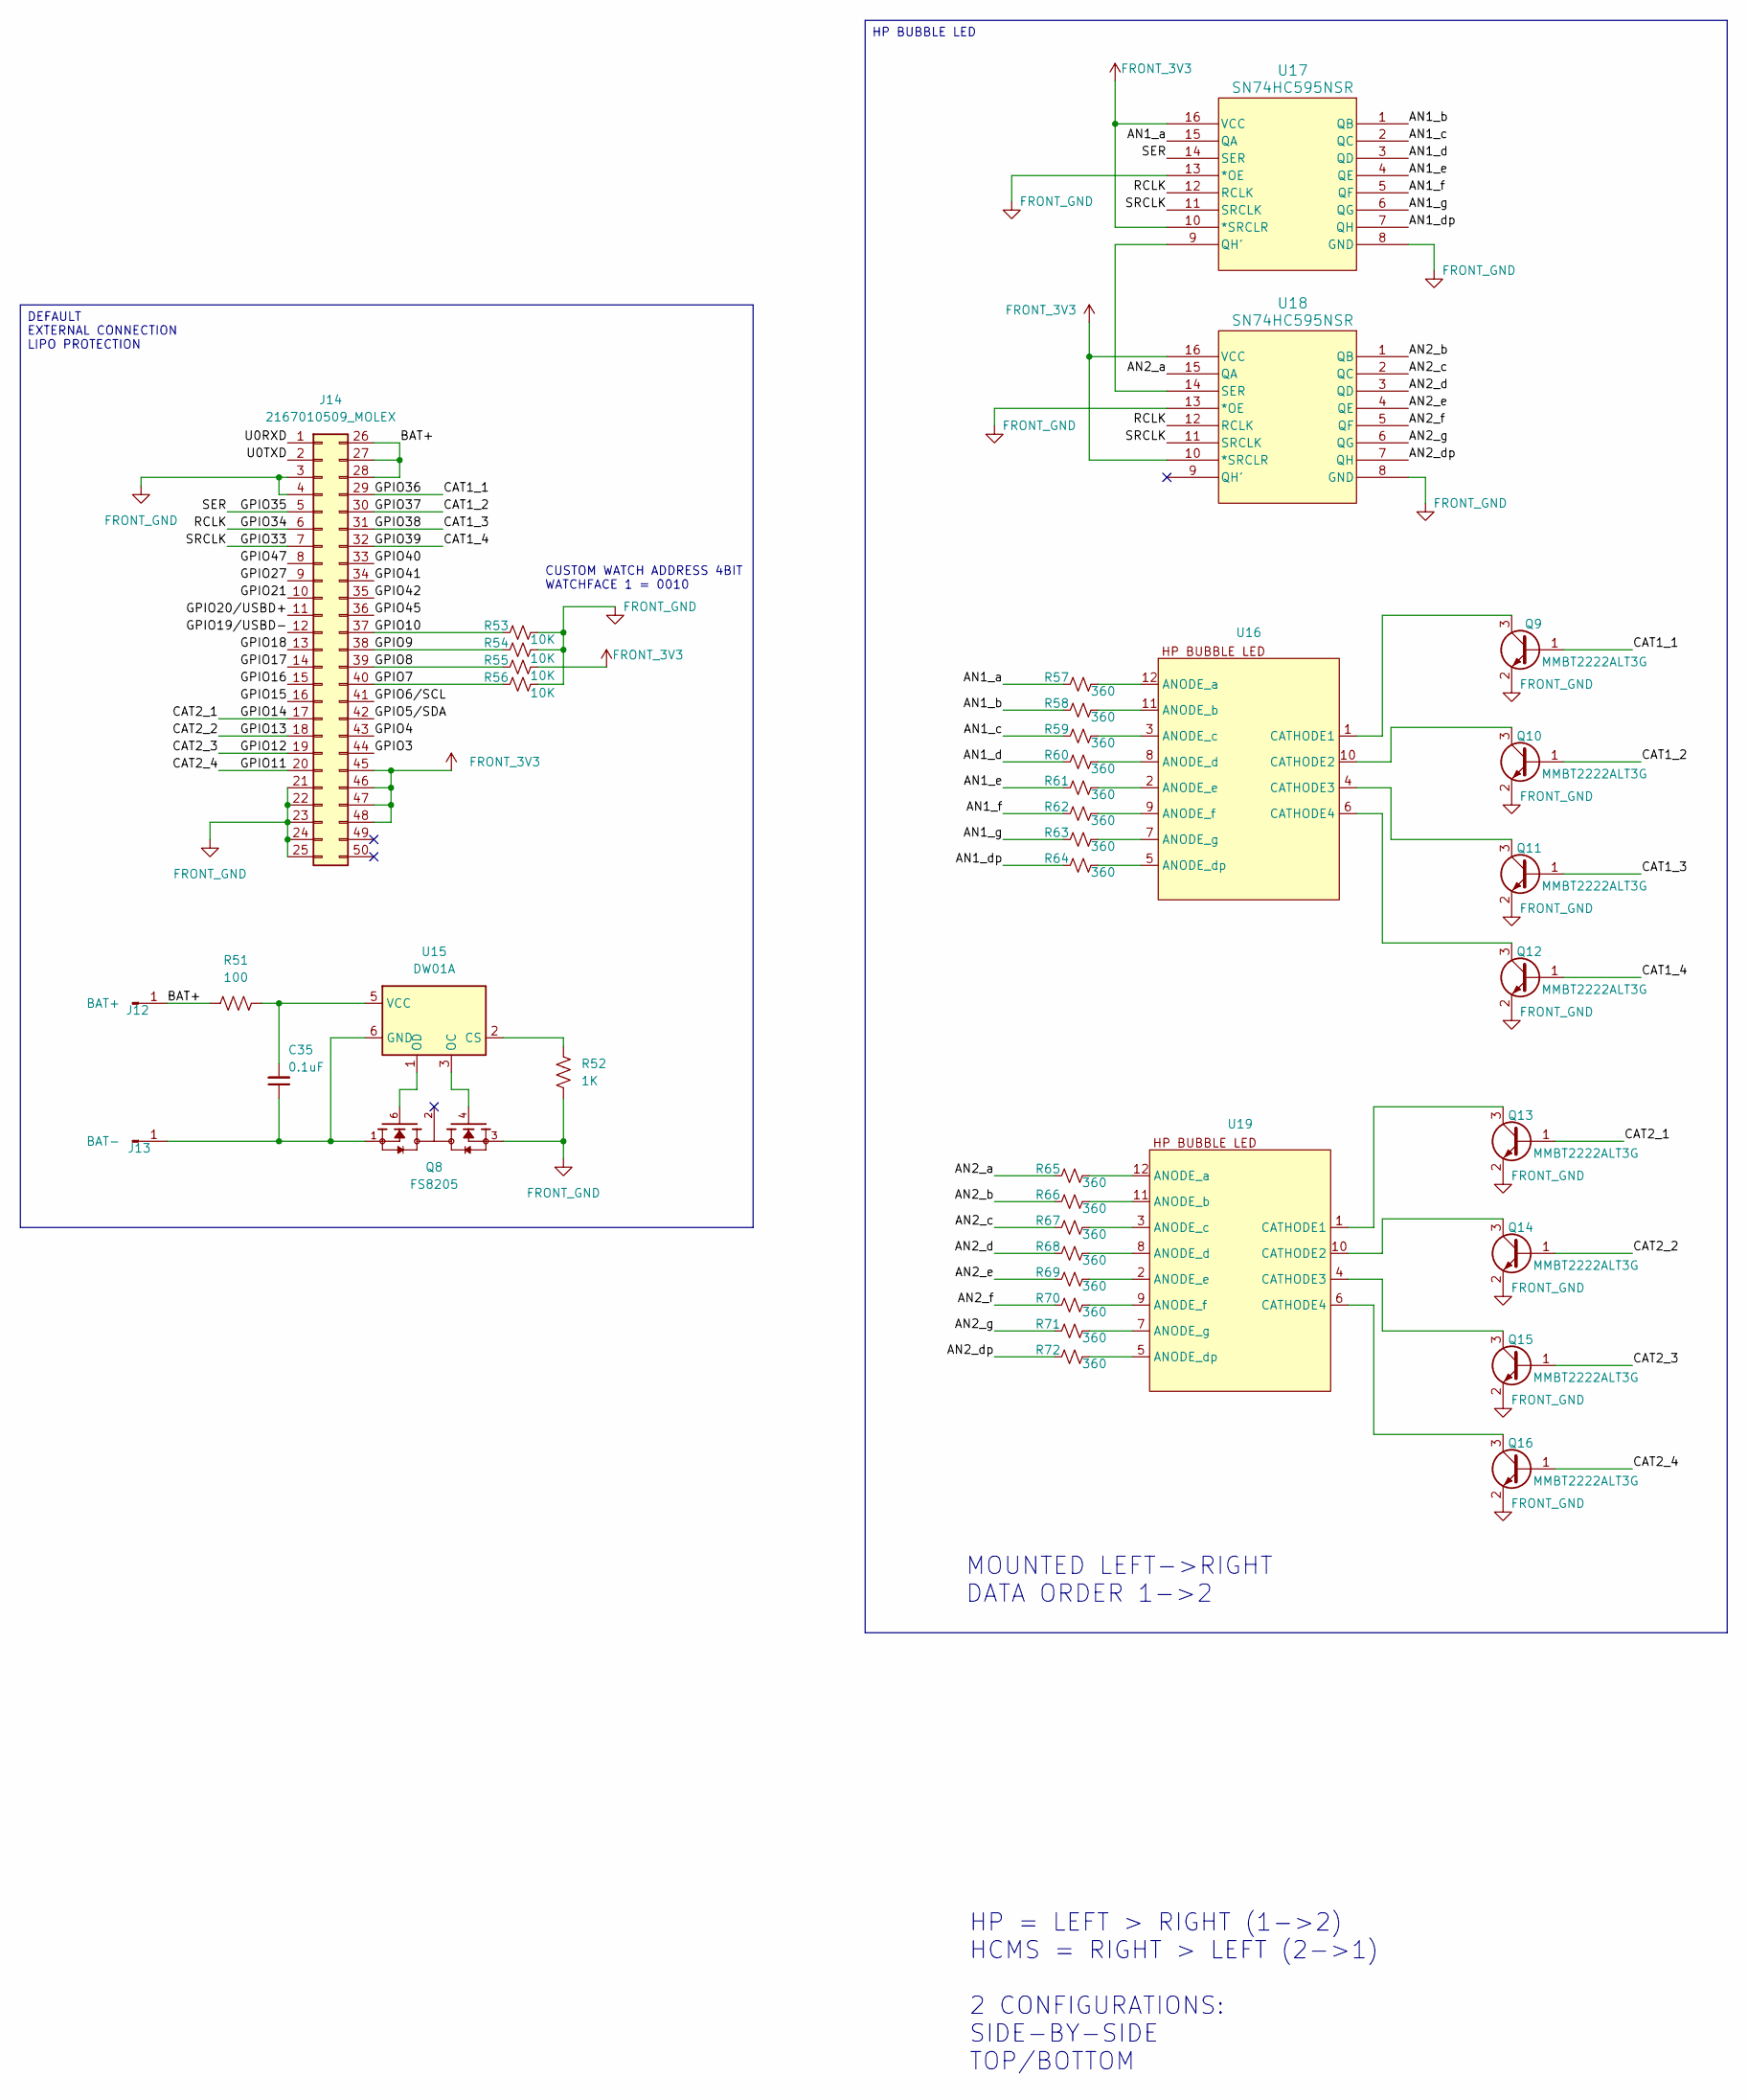
[picture p32: schematic satWatch_face2.kicad_sch, satWatch]

Parts:
C35: 0.1uF; C_0402_1005Metric_Pad0.74x0.62mm_HandSolder
J12: BAT+; SolderWirePad_1x01_SMD_3x6mm
J13: BAT-; SolderWirePad_1x01_SMD_3x6mm
J14: 2167010509_MOLEX; CON_2167010509_MOL
Q8: FS8205; SOT95P280X145-6N; PARTREV 1.9
Q9, Q10, Q11, Q12, Q13, Q14, Q15, Q16: MMBT2222ALT3G; SOT-23
R51: 100; R_0402_1005Metric_Pad0.72x0.64mm_HandSolder
R52: 1K; R_0402_1005Metric_Pad0.72x0.64mm_HandSolder
R53, R54, R55, R56: 10K; R_0402_1005Metric_Pad0.72x0.64mm_HandSolder
R57, R58, R59, R60, R61, R62, R63, R64, R65, R66, R67, R68, R69, R70, R71, R72: 360; R_0402_1005Metric_Pad0.72x0.64mm_HandSolder
U15: DW01A; SOT-23-6
U16, U19: DIP-12_W7.62mm
U17, U18: SN74HC595NSR; NS16-L

Connections:
/face2/AN1_a: R57.1, U17.15 (QA)
/face2/AN1_b: R58.1, U17.1 (QB)
/face2/AN1_c: R59.1, U17.2 (QC)
/face2/AN1_d: R60.1, U17.3 (QD)
/face2/AN1_dp: R64.1, U17.7 (QH)
/face2/AN1_e: R61.1, U17.4 (QE)
/face2/AN1_f: R62.1, U17.5 (QF)
/face2/AN1_g: R63.1, U17.6 (QG)
/face2/AN2_a: R65.1, U18.15 (QA)
/face2/AN2_b: R66.1, U18.1 (QB)
/face2/AN2_c: R67.1, U18.2 (QC)
/face2/AN2_d: R68.1, U18.3 (QD)
/face2/AN2_dp: R72.1, U18.7 (QH)
/face2/AN2_e: R69.1, U18.4 (QE)
/face2/AN2_f: R70.1, U18.5 (QF)
/face2/AN2_g: R71.1, U18.6 (QG)
/face2/BAT+: J12.1 (Pin_1_1), J14.26, J14.27, J14.28, R51.1
/face2/CAT1_1: J14.29, Q9.1 (B)
/face2/CAT1_2: J14.30, Q10.1 (B)
/face2/CAT1_3: J14.31, Q11.1 (B)
/face2/CAT1_4: J14.32, Q12.1 (B)
/face2/CAT2_1: J14.17, Q13.1 (B)
/face2/CAT2_2: J14.18, Q14.1 (B)
/face2/CAT2_3: J14.19, Q15.1 (B)
/face2/CAT2_4: J14.20, Q16.1 (B)
/face2/GPIO3: J14.44
/face2/GPIO4: J14.43
/face2/GPIO5/SDA: J14.42
/face2/GPIO6/SCL: J14.41
/face2/GPIO7: J14.40, R56.1
/face2/GPIO8: J14.39, R55.1
/face2/GPIO9: J14.38, R54.1
/face2/GPIO10: J14.37, R53.1
/face2/GPIO15: J14.16
/face2/GPIO16: J14.15
/face2/GPIO17: J14.14
/face2/GPIO18: J14.13
/face2/GPIO19/USBD-: J14.12
/face2/GPIO20/USBD+: J14.11
/face2/GPIO21: J14.10
/face2/GPIO27: J14.9
/face2/GPIO33: J14.7, U17.11 (SRCLK), U18.11 (SRCLK)
/face2/GPIO34: J14.6, U17.12 (RCLK), U18.12 (RCLK)
/face2/GPIO35: J14.5, U17.14 (SER)
/face2/GPIO40: J14.33
/face2/GPIO41: J14.34
/face2/GPIO42: J14.35
/face2/GPIO45: J14.36
/face2/GPIO47: J14.8
/face2/U0RXD: J14.1
/face2/U0TXD: J14.2
FRONT_3V3: J14.45, J14.46, J14.47, J14.48, R55.2, U17.10 (*SRCLR), U17.16 (VCC), U18.10 (*SRCLR), U18.16 (VCC); also elsewhere on the board
FRONT_GND: J14.3, J14.4, J14.21, J14.22, J14.23, J14.24, J14.25, Q8.3, Q9.2 (E), Q10.2 (E), Q11.2 (E), Q12.2 (E), Q13.2 (E), Q14.2 (E), Q15.2 (E), Q16.2 (E), R52.1, R53.2, R54.2, R56.2, U17.8 (GND), U17.13 (*OE), U18.8 (GND), U18.13 (*OE); also elsewhere on the board
unnamed: C35.1, J13.1 (Pin_1_1), Q8.1, U15.6 (GND)
unnamed: Q9.3 (C), U16.1 (CATHODE1)
unnamed: Q10.3 (C), U16.10 (CATHODE2)
unnamed: Q11.3 (C), U16.4 (CATHODE3)
unnamed: Q12.3 (C), U16.6 (CATHODE4)
unnamed: Q13.3 (C), U19.1 (CATHODE1)
unnamed: Q14.3 (C), U19.10 (CATHODE2)
unnamed: Q15.3 (C), U19.4 (CATHODE3)
unnamed: Q16.3 (C), U19.6 (CATHODE4)
unnamed: R52.2, U15.2 (CS)
unnamed: Q8.4, U15.3 (OC)
unnamed: Q8.6, U15.1 (OD)
unnamed: C35.2, R51.2, U15.5 (VCC)
unnamed: R57.2, U16.12 (ANODE_a)
unnamed: R58.2, U16.11 (ANODE_b)
unnamed: R59.2, U16.3 (ANODE_c)
unnamed: R60.2, U16.8 (ANODE_d)
unnamed: R64.2, U16.5 (ANODE_dp)
unnamed: R61.2, U16.2 (ANODE_e)
unnamed: R62.2, U16.9 (ANODE_f)
unnamed: R63.2, U16.7 (ANODE_g)
unnamed: U17.9 (QH'), U18.14 (SER)
unnamed: R65.2, U19.12 (ANODE_a)
unnamed: R66.2, U19.11 (ANODE_b)
unnamed: R67.2, U19.3 (ANODE_c)
unnamed: R68.2, U19.8 (ANODE_d)
unnamed: R72.2, U19.5 (ANODE_dp)
unnamed: R69.2, U19.2 (ANODE_e)
unnamed: R70.2, U19.9 (ANODE_f)
unnamed: R71.2, U19.7 (ANODE_g)

Notes on the sheet:
MOUNTED LEFT->RIGHT DATA ORDER 1->2
CUSTOM WATCH ADDRESS 4BIT WATCHFACE 1 = 0010
HP = LEFT > RIGHT (1->2) HCMS = RIGHT > LEFT (2->1) 2 CONFIGURATIONS: SIDE-BY-SIDE TOP/BOTTOM
DEFAULT EXTERNAL CONNECTION LIPO PROTECTION
HP BUBBLE LED

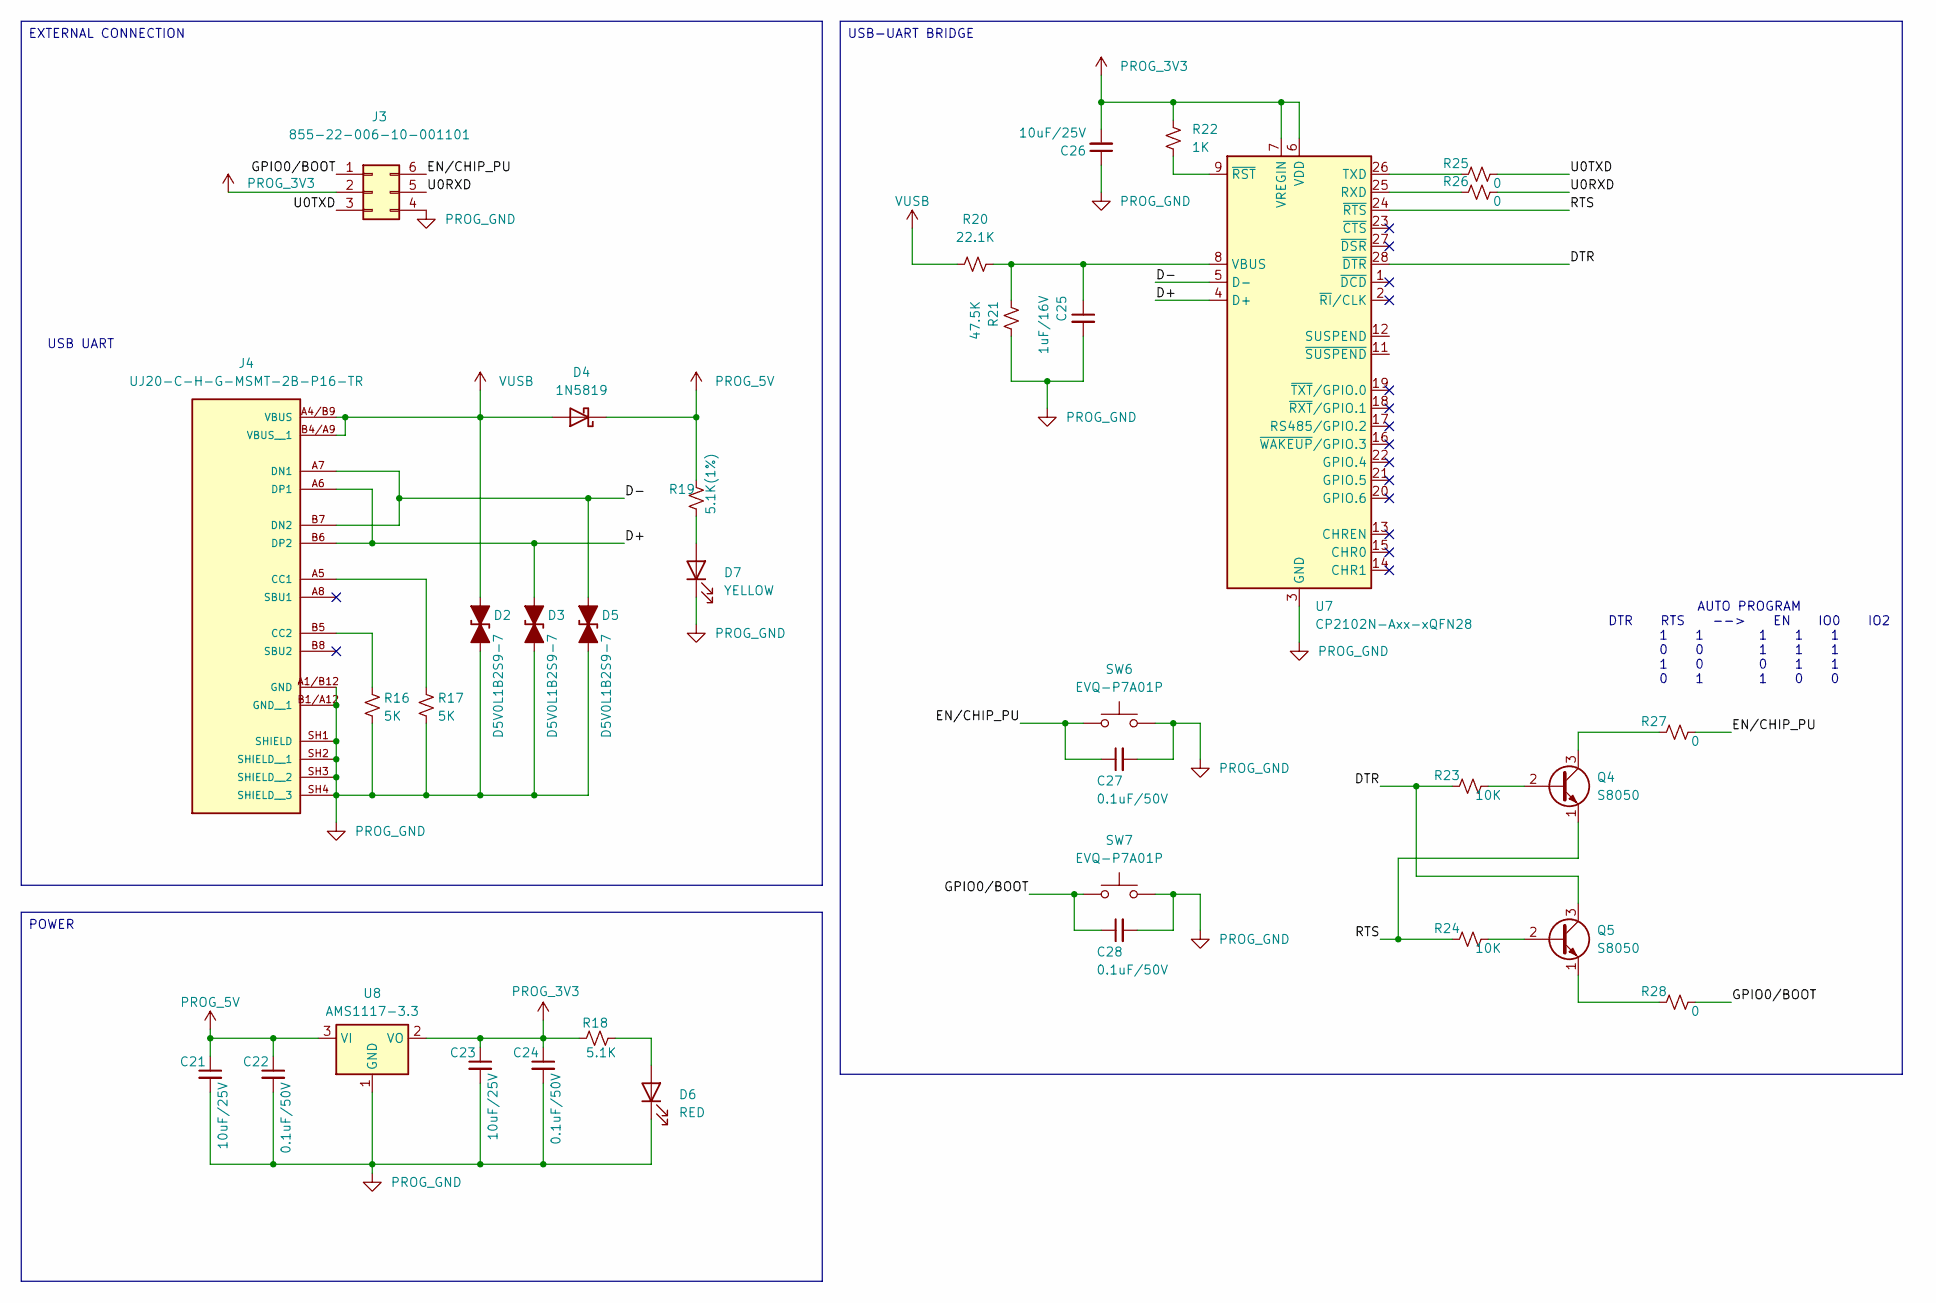
[picture p33: schematic satWatch_programmer.kicad_sch, satWatch]

Parts:
C21, C23, C26: 10uF/25V; C_0603_1608Metric_Pad1.08x0.95mm_HandSolder
C22, C24, C27, C28: 0.1uF/50V; C_0603_1608Metric_Pad1.08x0.95mm_HandSolder
C25: 1uF/16V; C_0603_1608Metric_Pad1.08x0.95mm_HandSolder
D2, D3, D5: D5V0L1B2S9-7; D_SOD-923
D4: 1N5819; D_SOD-123
D6: RED; LED_0603_1608Metric_Pad1.05x0.95mm_HandSolder
D7: YELLOW; LED_0603_1608Metric_Pad1.05x0.95mm_HandSolder
J3: 855-22-006-10-001101; 8552200610001101
J4: UJ20-C-H-G-MSMT-2B-P16-TR; SAMESKY_UJ20-C-H-G-MSMT-2B-P16-TR; PARTREV 1.0
Q4, Q5: S8050; SOT-23_Handsoldering
R16, R17: 5K; R_0603_1608Metric_Pad0.98x0.95mm_HandSolder
R18: 5.1K; R_0603_1608Metric_Pad0.98x0.95mm_HandSolder
R19: 5.1K(1%); R_0603_1608Metric_Pad0.98x0.95mm_HandSolder
R20: 22.1K; R_0603_1608Metric_Pad0.98x0.95mm_HandSolder
R21: 47.5K; R_0603_1608Metric_Pad0.98x0.95mm_HandSolder
R22: 1K; R_0603_1608Metric_Pad0.98x0.95mm_HandSolder
R23, R24: 10K; R_0603_1608Metric_Pad0.98x0.95mm_HandSolder
R25, R26, R27, R28: 0; R_0603_1608Metric_Pad0.98x0.95mm_HandSolder
SW6, SW7: EVQ-P7A01P; SW_SPST_EVQP7A
U7: CP2102N-Axx-xQFN28; QFN-28-1EP_5x5mm_P0.5mm_EP3.35x3.35mm
U8: AMS1117-3.3; SOT-223-3_TabPin2

Connections:
/Programmer/D+: D3.1 (A1), J4.A6 (DP1), J4.B6 (DP2), U7.4 (D+)
/Programmer/D-: D5.1 (A1), J4.A7 (DN1), J4.B7 (DN2), U7.5 (D-)
/Programmer/DTR: Q5.3 (C), R23.2, U7.28 (~DTR)
/Programmer/EN/CHIP_PU: C27.1, J3.6, R27.1, SW6.1
/Programmer/GPIO0/BOOT: C28.1, J3.1, R28.1, SW7.1
/Programmer/RTS: Q4.1 (E), R24.2, U7.24 (~RTS)
/Programmer/U0RXD: J3.5, R26.1
/Programmer/U0TXD: J3.3, R25.1
unnamed: D6.2 (A), R18.2
unnamed: D7.2 (A), R19.1
unnamed: J4.A5 (CC1), R17.1
unnamed: J4.B5 (CC2), R16.1
unnamed: Q4.2 (B), R23.1
unnamed: Q4.3 (C), R27.2
unnamed: Q5.2 (B), R24.1
unnamed: Q5.1 (E), R28.2
unnamed: R26.2, U7.25 (RXD)
unnamed: R25.2, U7.26 (TXD)
unnamed: C25.1, R20.2, R21.1, U7.8 (VBUS)
unnamed: R22.1, U7.9 (~RST)
PROG_3V3: C23.1, C24.1, C26.2, J3.2, R18.1, R22.2, U7.6 (VDD), U7.7 (VREGIN), U8.2 (VO)
PROG_5V: C21.1, C22.1, D4.1 (K), R19.2, U8.3 (VI)
PROG_GND: C21.2, C22.2, C23.2, C24.2, C25.2, C26.1, C27.2, C28.2, D2.2 (A2), D3.2 (A2), D5.2 (A2), D6.1 (K), D7.1 (K), J3.4, J4.A1/B12 (GND), J4.B1/A12 (GND__1), J4.SH1 (SHIELD), J4.SH2 (SHIELD__1), J4.SH3 (SHIELD__2), J4.SH4 (SHIELD__3), R16.2, R17.2, R21.2, SW6.2, SW7.2, U7.3 (GND), U7.29 (GND), U8.1 (GND)
VUSB: D2.1 (A1), D4.2 (A), J4.A4/B9 (VBUS), J4.B4/A9 (VBUS__1), R20.1

Notes on the sheet:
USB UART
AUTO PROGRAM DTR RTS --> EN IO0 IO2 1 1 1 1 1 0 0 1 1 1 1 0 0 1 1 0 1 1 0 0
USB-UART BRIDGE
EXTERNAL CONNECTION
POWER

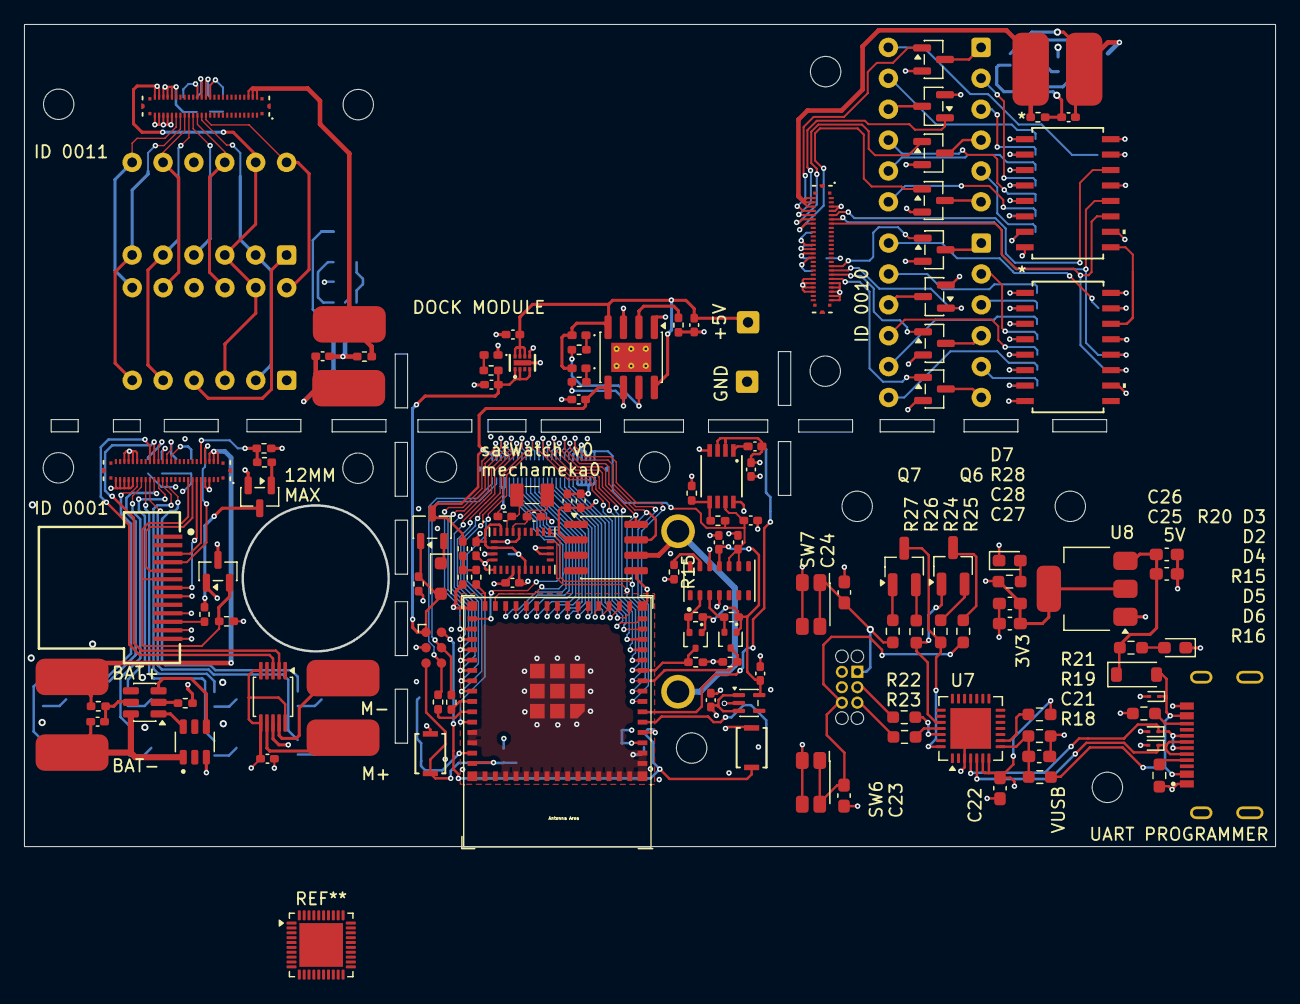
[picture p34: board satWatch_main.kicad_pcb from above]

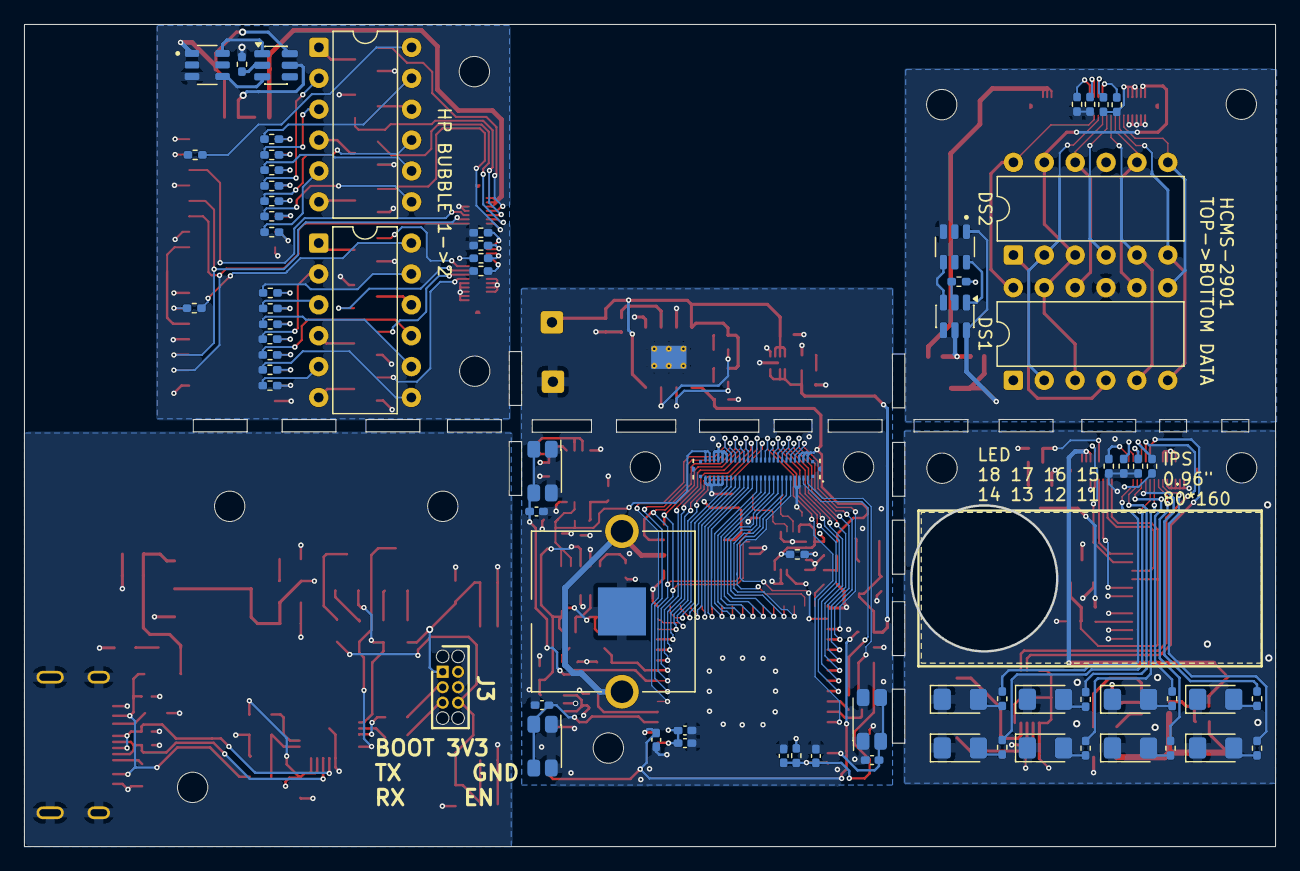
[picture p35: board satWatch_main.kicad_pcb from below]

Board: 4 copper layers, 102.9 x 67.6 mm, 210 parts (70 on the bottom side), 213 nets.

Other parts of the board:
H1, H1#2, H1#3, H1#4, H1#5, H2, H2#2, H2#3, H2#4, H2#5, H3, H3#2: MountingHole; MountingHole_2.5mm
