mechameka/satellite_watch/schematics/satWatch_main_LargePrototype/satWatch_main_LargePrototype.kicad_pcb

## KiCad design schematics/satWatch_main_LargePrototype/satWatch_main_LargePrototype.kicad_pcb (2026-07-16)

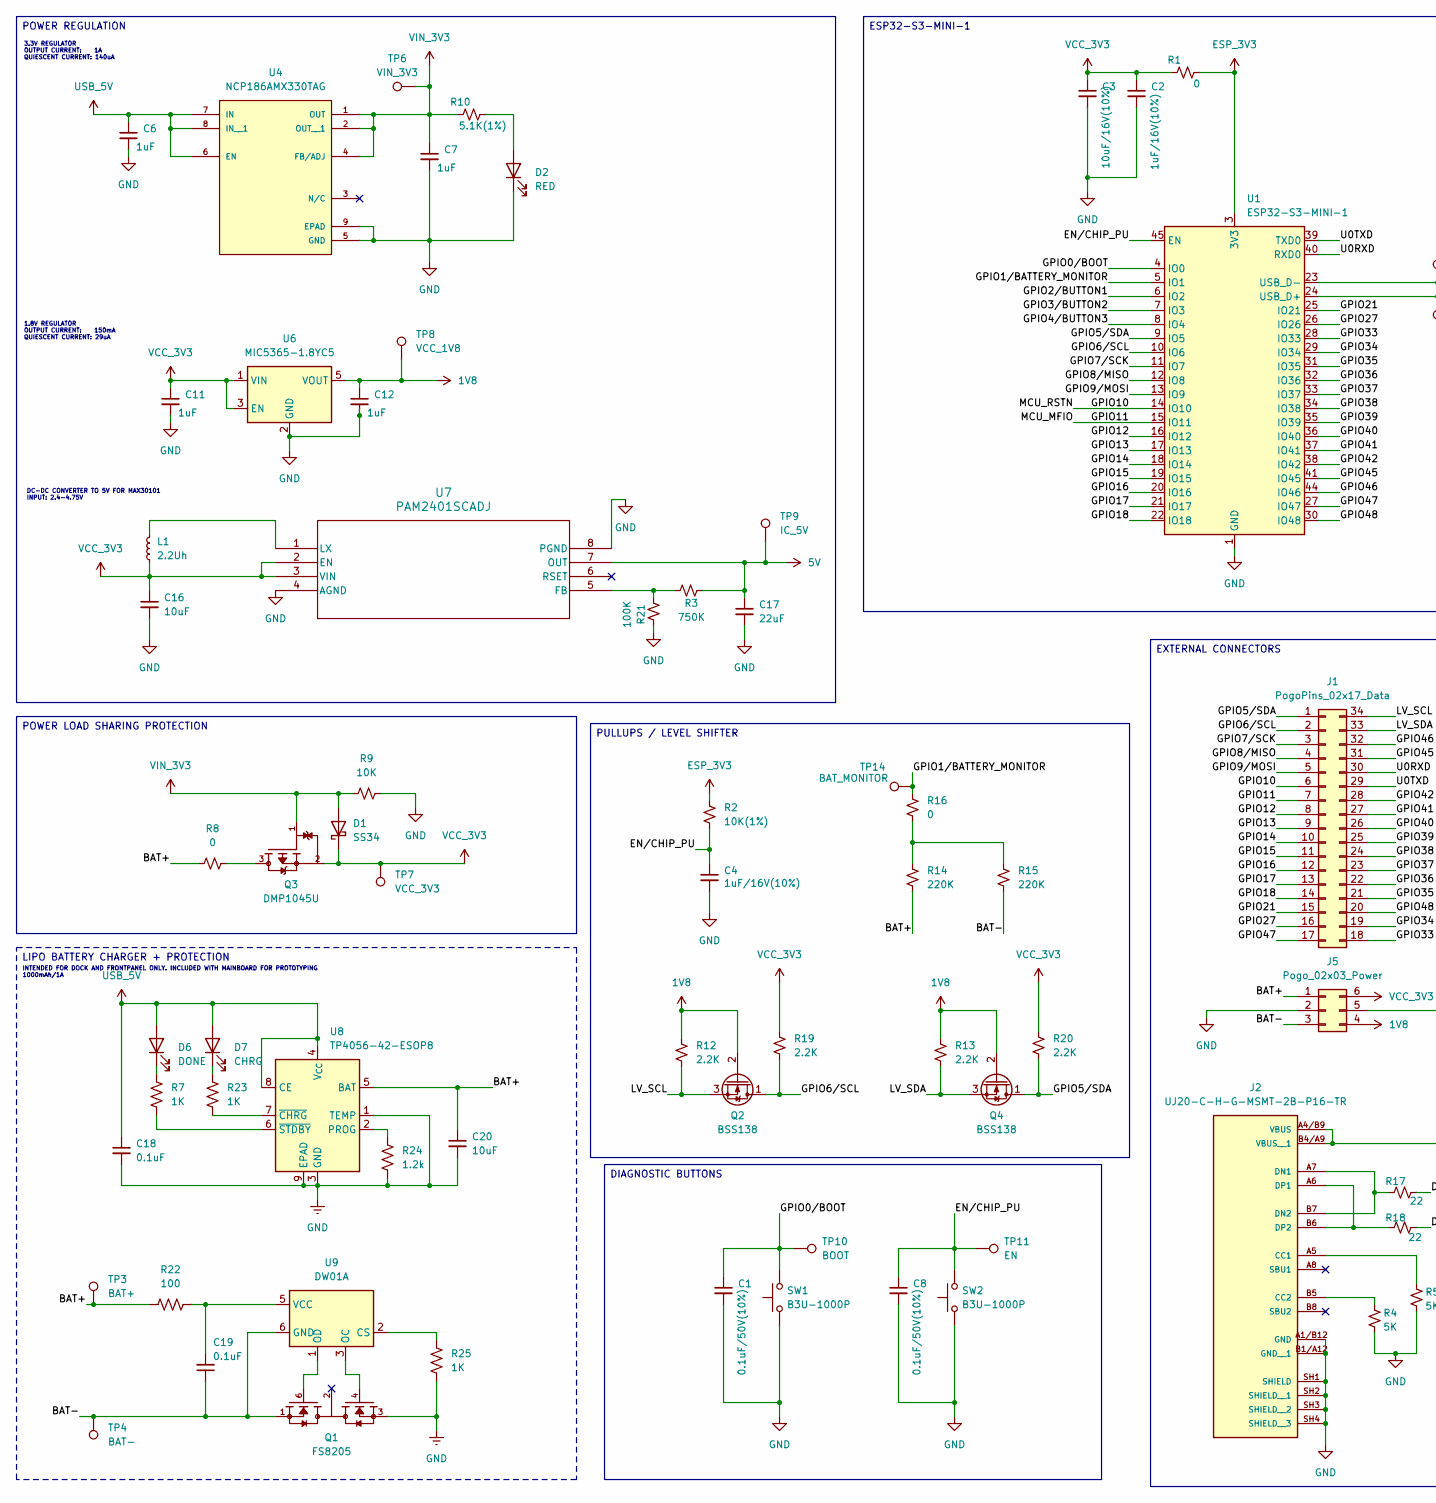
[picture p36: schematic satWatch_main_LargePrototype.kicad_sch, MAINBOARD: LARGE PROTOTYPE, part in row 1, column 1]

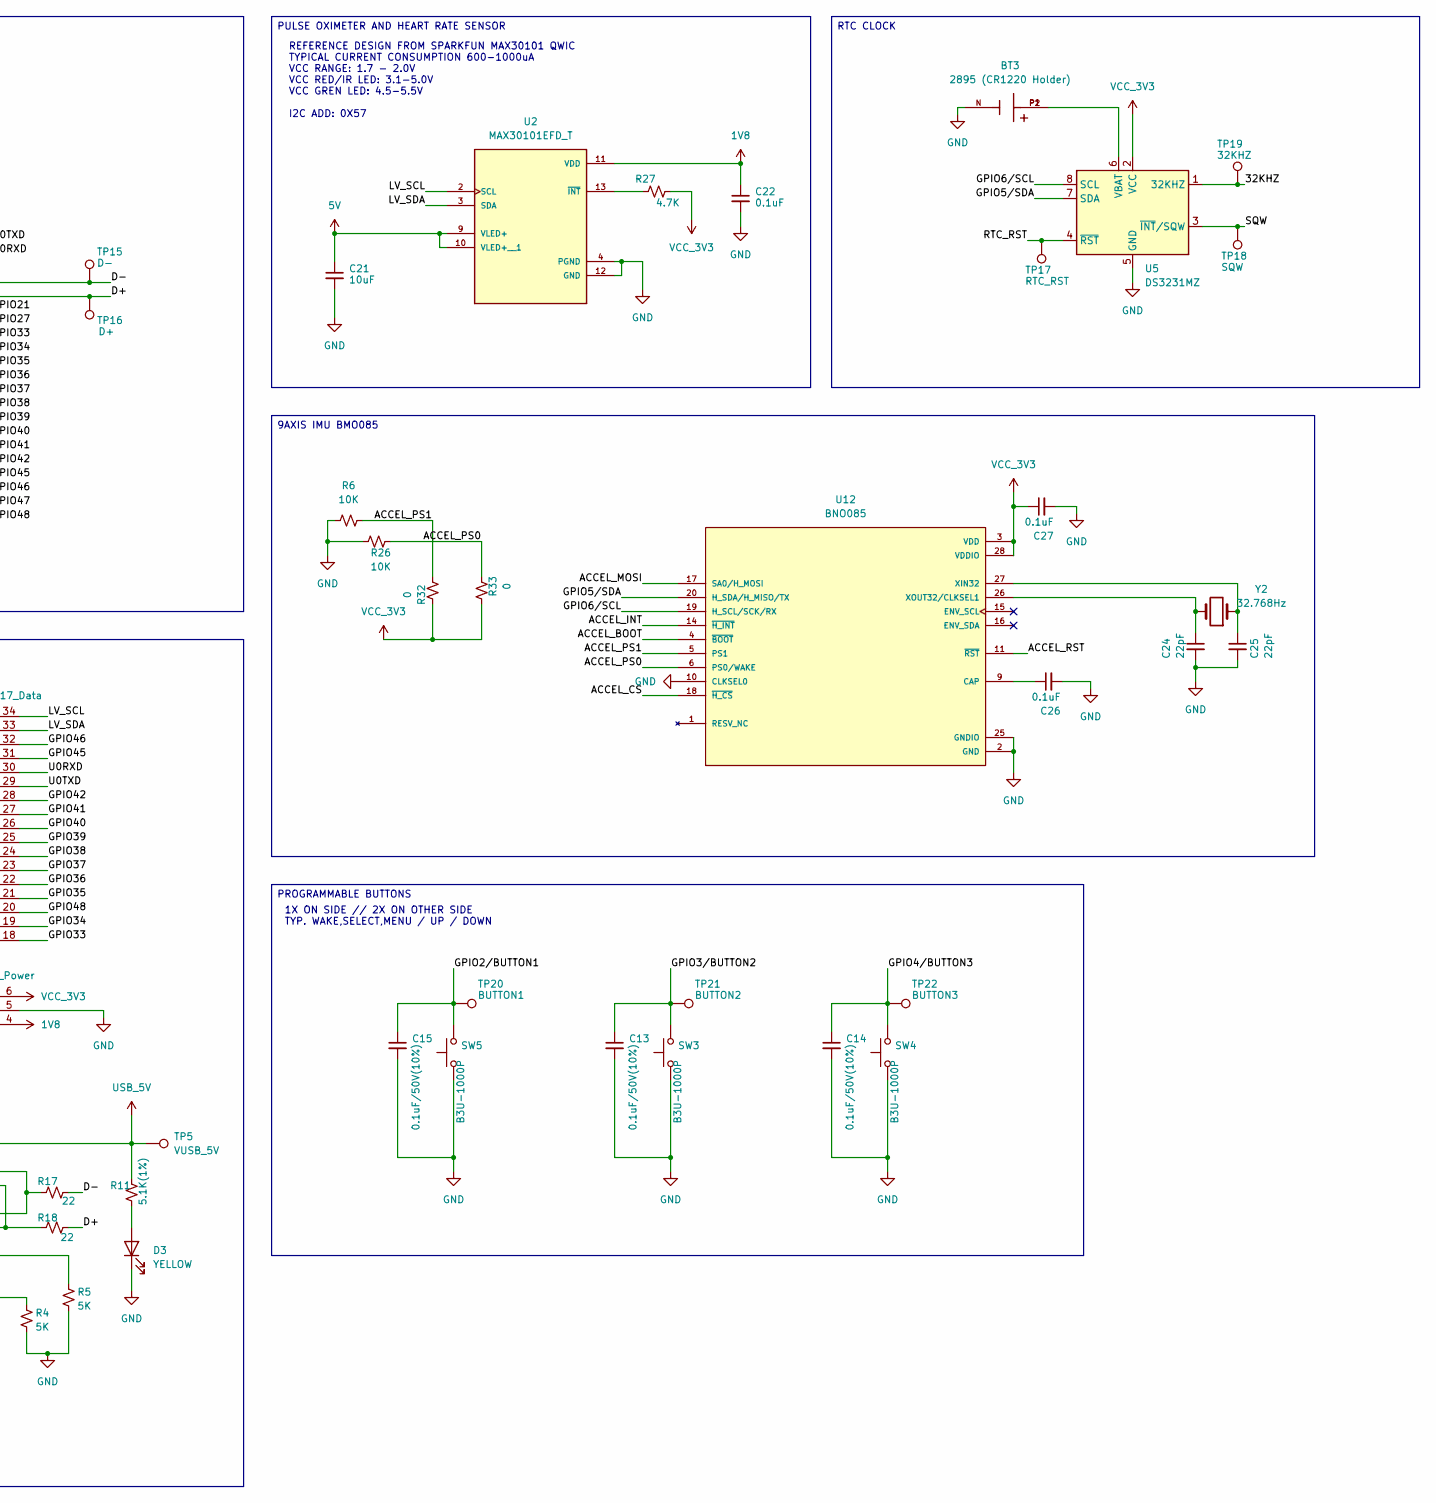
[picture p37: schematic satWatch_main_LargePrototype.kicad_sch, MAINBOARD: LARGE PROTOTYPE, part in row 1, column 2]

Parts:
BT3: 2895 (CR1220 Holder); BAT_2895; PARTREV B
C1, C8, C13, C14, C15: 0.1uF/50V(10%); C_0603_1608Metric_Pad1.08x0.95mm_HandSolder
C2, C4: 1uF/16V(10%); C_0603_1608Metric_Pad1.08x0.95mm_HandSolder
C3: 10uF/16V(10%); C_0603_1608Metric_Pad1.08x0.95mm_HandSolder
C6, C7, C11, C12: 1uF; C_0603_1608Metric_Pad1.08x0.95mm_HandSolder
C16, C20, C21: 10uF; C_0603_1608Metric_Pad1.08x0.95mm_HandSolder
C17: 22uF; C_0603_1608Metric_Pad1.08x0.95mm_HandSolder
C18, C19, C22, C26, C27: 0.1uF; C_0603_1608Metric_Pad1.08x0.95mm_HandSolder
C24, C25: 22pF; C_0603_1608Metric_Pad1.08x0.95mm_HandSolder
D1: SS34; D_0603_1608Metric_Pad1.05x0.95mm_HandSolder
D2: RED; LED_0603_1608Metric_Pad1.05x0.95mm_HandSolder
D3: YELLOW; LED_0603_1608Metric_Pad1.05x0.95mm_HandSolder
D6: DONE; LED_0603_1608Metric_Pad1.05x0.95mm_HandSolder
D7: CHRG; LED_0603_1608Metric_Pad1.05x0.95mm_HandSolder
J1: PogoPins_02x17_Data; PinHeader_2x17_P2.54mm_Vertical
J2: UJ20-C-H-G-MSMT-2B-P16-TR; SAMESKY_UJ20-C-H-G-MSMT-2B-P16-TR; PARTREV 1.0
J5: Pogo_02x03_Power; PinHeader_2x03_P2.54mm_Vertical
L1: 2.2Uh; L_0603_1608Metric_Pad1.05x0.95mm_HandSolder
Q1: FS8205; SOT95P280X145-6N; PARTREV 1.9
Q2, Q4: BSS138; SOT-23-3
Q3: DMP1045U; SOT-23-3; PARTREV 7 - 2
R1, R8, R16, R32, R33: 0; R_0603_1608Metric_Pad0.98x0.95mm_HandSolder
R2: 10K(1%); R_0603_1608Metric_Pad0.98x0.95mm_HandSolder
R3: 750K; R_0603_1608Metric_Pad0.98x0.95mm_HandSolder
R4, R5: 5K; R_0603_1608Metric_Pad0.98x0.95mm_HandSolder
R6, R9, R26: 10K; R_0603_1608Metric_Pad0.98x0.95mm_HandSolder
R7, R23, R25: 1K; R_0603_1608Metric_Pad0.98x0.95mm_HandSolder
R10, R11: 5.1K(1%); R_0603_1608Metric_Pad0.98x0.95mm_HandSolder
R12, R13, R19, R20: 2.2K; R_0603_1608Metric_Pad0.98x0.95mm_HandSolder
R14, R15: 220K; R_0603_1608Metric_Pad0.98x0.95mm_HandSolder
R17, R18: 22; R_0603_1608Metric_Pad0.98x0.95mm_HandSolder
R21: 100K; R_0603_1608Metric_Pad0.98x0.95mm_HandSolder
R22: 100; R_0603_1608Metric_Pad0.98x0.95mm_HandSolder
R24: 1.2k; R_0603_1608Metric_Pad0.98x0.95mm_HandSolder
R27: 4.7K; R_0603_1608Metric_Pad0.98x0.95mm_HandSolder
SW1, SW2, SW3, SW4, SW5: B3U-1000P; SW_SPST_B3U-1000P
TP3: BAT+; TestPoint_Pad_D2.5mm
TP4: BAT-; TestPoint_Pad_D2.5mm
TP5: VUSB_5V; TestPoint_Pad_D2.5mm
TP6: VIN_3V3; TestPoint_Pad_D2.5mm
TP7: VCC_3V3; TestPoint_Pad_D2.5mm
TP8: VCC_1V8; TestPoint_Pad_D2.5mm
TP9: IC_5V; TestPoint_Pad_D2.5mm
TP10: BOOT; TestPoint_Pad_D2.5mm
TP11: EN; TestPoint_Pad_D2.5mm
TP14: BAT_MONITOR; TestPoint_Pad_D2.5mm
TP15: D-; TestPoint_Pad_D2.5mm
TP16: D+; TestPoint_Pad_D2.5mm
TP17: RTC_RST; TestPoint_Pad_D2.5mm
TP18: SQW; TestPoint_Pad_D2.5mm
TP19: 32KHZ; TestPoint_Pad_D2.5mm
TP20: BUTTON1; TestPoint_Pad_D2.5mm
TP21: BUTTON2; TestPoint_Pad_D2.5mm
TP22: BUTTON3; TestPoint_Pad_D2.5mm
U1: ESP32-S3-MINI-1; ESP32-S2-MINI-1
U2: MAX30101EFD_T; MAX30101EFD+T; PARTREV 2
U4: NCP186AMX330TAG; PSON40P160X120X45-9N; PARTREV Rev.5
U5: DS3231MZ; SOIC-8_3.9x4.9mm_P1.27mm
U6: MIC5365-1.8YC5; SOT-353_SC-70-5
U7: PAM2401SCADJ; MSOP8_DIO
U8: TP4056-42-ESOP8; SOIC-8-1EP_3.9x4.9mm_P1.27mm_EP2.41x3.3mm_ThermalVias
U9: DW01A; SOT-23-6
U12: BNO085; IC_BNO085; PARTREV v1.17
Y2: 32.768Hz; ABS07-32.768KHZ-T

Connections:
1V8: C12.1, C22.1, J5.4, Q2.2 (G), Q4.2 (G), R12.1, R13.1, TP8.1 (1_1), U2.11 (VDD), U6.5 (VOUT)
5V: C17.1, C21.1, R3.2, TP9.1 (1_1), U2.9 (VLED+), U2.10 (VLED+__1), U7.7 (OUT)
/32KHZ: TP19.1 (1_1), U5.1 (32KHZ)
/ACCEL_BOOT: U12.4 (~BOOT)
/ACCEL_CS: U12.18 (~H_CS)
/ACCEL_INT: U12.14 (~H_INT)
/ACCEL_MOSI: U12.17 (SA0/H_MOSI)
/ACCEL_PS0: R26.2, R33.2, U12.6 (PS0/WAKE)
/ACCEL_PS1: R6.2, R32.1, U12.5 (PS1)
/ACCEL_RST: U12.11 (~RST)
/BAT+: C20.1, J5.1, R8.1, R14.2, R22.1, TP3.1 (1_1), U8.5 (BAT)
/BAT-: C19.1, J5.3, Q1.1, R15.2, TP4.1 (1_1), U9.6 (GND)
/D+: R18.1, TP16.1 (1_1), U1.24 (USB_D+)
/D-: R17.1, TP15.1 (1_1), U1.23 (USB_D-)
/EN/CHIP_PU: C4.1, C8.1, R2.2, SW2.2, TP11.1 (1_1), U1.45 (EN)
/GPIO0/BOOT: C1.1, SW1.2, TP10.1 (1_1), U1.4 (IO0)
/GPIO1/BATTERY_MONITOR: R16.1, TP14.1 (1_1), U1.5 (IO1)
/GPIO2/BUTTON1: C15.1, SW5.2, TP20.1 (1_1), U1.6 (IO2)
/GPIO3/BUTTON2: C13.1, SW3.2, TP21.1 (1_1), U1.7 (IO3)
/GPIO4/BUTTON3: C14.1, SW4.2, TP22.1 (1_1), U1.8 (IO4)
/GPIO5/SDA: J1.1, Q4.1 (D), R20.2, U1.9 (IO5), U5.7 (SDA), U12.20 (H_SDA/H_MISO/TX)
/GPIO6/SCL: J1.2, Q2.1 (D), R19.2, U1.10 (IO6), U5.8 (SCL), U12.19 (H_SCL/SCK/RX)
/GPIO7/SCK: J1.3, U1.11 (IO7)
/GPIO8/MISO: J1.4, U1.12 (IO8)
/GPIO9/MOSI: J1.5, U1.13 (IO9)
/GPIO10: J1.6, U1.14 (IO10)
/GPIO11: J1.7, U1.15 (IO11)
/GPIO12: J1.8, U1.16 (IO12)
/GPIO13: J1.9, U1.17 (IO13)
/GPIO14: J1.10, U1.18 (IO14)
/GPIO15: J1.11, U1.19 (IO15)
/GPIO16: J1.12, U1.20 (IO16)
/GPIO17: J1.13, U1.21 (IO17)
/GPIO18: J1.14, U1.22 (IO18)
/GPIO21: J1.15, U1.25 (IO21)
/GPIO27: J1.16, U1.26 (IO26)
/GPIO33: J1.18, U1.28 (IO33)
/GPIO34: J1.19, U1.29 (IO34)
/GPIO35: J1.21, U1.31 (IO35)
/GPIO36: J1.22, U1.32 (IO36)
/GPIO37: J1.23, U1.33 (IO37)
/GPIO38: J1.24, U1.34 (IO38)
/GPIO39: J1.25, U1.35 (IO39)
/GPIO40: J1.26, U1.36 (IO40)
/GPIO41: J1.27, U1.37 (IO41)
/GPIO42: J1.28, U1.38 (IO42)
/GPIO45: J1.31, U1.41 (IO45)
/GPIO46: J1.32, U1.44 (IO46)
/GPIO47: J1.17, U1.27 (IO47)
/GPIO48: J1.20, U1.30 (IO48)
/LV_SCL: J1.34, Q2.3 (S), R12.2, U2.2 (SCL)
/LV_SDA: J1.33, Q4.3 (S), R13.2, U2.3 (SDA)
/RTC_RST: TP17.1 (1_1), U5.4 (~RST)
/SQW: TP18.1 (1_1), U5.3 (~INT/SQW)
/U0RXD: J1.30, U1.40 (RXD0)
/U0TXD: J1.29, U1.39 (TXD0)
ESP_3V3: R1.2, R2.1, U1.3 (3V3)
GND: BT3.N, C1.2, C2.2, C3.2, C4.2, C6.2, C7.2, C8.2, C11.2, C12.2, C13.2, C14.2, C15.2, C16.2, C17.2, C18.2, C20.2, C21.2, C22.2, C24.2, C25.2, C26.2, C27.2, D2.1 (K), D3.1 (K), J2.A1/B12 (GND), J2.B1/A12 (GND__1), J2.SH1 (SHIELD), J2.SH2 (SHIELD__1), J2.SH3 (SHIELD__2), J2.SH4 (SHIELD__3), J5.2, J5.5, Q1.3, R4.2, R5.2, R6.1, R9.2, R21.2, R24.2, R25.1, R26.1, SW1.1, SW2.1, SW3.1, SW4.1, SW5.1, U1.1 (GND), U1.2 (GND), U1.42 (GND), U1.43 (GND), U1.46 (GND), U1.47 (GND), U1.48 (GND), U1.49 (GND), U1.50 (GND), U1.51 (GND), U1.52 (GND), U1.53 (GND), U1.54 (GND), U1.55 (GND), U1.56 (GND), U1.57 (GND), U1.58 (GND), U1.59 (GND), U1.60 (GND), U1.61 (GND), U1.62 (GND), U1.63 (GND), U1.64 (GND), U1.65 (GND), U2.4 (PGND), U2.12 (GND), U4.5 (GND), U4.9 (EPAD), U5.5 (GND), U6.2 (GND), U7.4 (AGND), U7.8 (PGND), U8.1 (TEMP), U8.3 (GND), U8.9 (EPAD), U12.2 (GND), U12.10 (CLKSEL0), U12.25 (GNDIO)
unnamed: D2.2 (A), R10.2
unnamed: D3.2 (A), R11.1
unnamed: D6.1 (K), R7.1
unnamed: D7.1 (K), R23.1
unnamed: J2.A5 (CC1), R5.1
unnamed: J2.B5 (CC2), R4.1
unnamed: J2.A7 (DN1), J2.B7 (DN2), R17.2
unnamed: J2.A6 (DP1), J2.B6 (DP2), R18.2
unnamed: Q3.3, R8.2
unnamed: R14.1, R15.1, R16.2
unnamed: R27.1, U2.13 (~INT)
unnamed: BT3.P1, BT3.P2, U5.6 (VBAT)
unnamed: R3.1, R21.1, U7.5 (FB)
unnamed: L1.2, U7.1 (LX)
unnamed: R24.1, U8.2 (PROG)
unnamed: R23.2, U8.7 (~CHRG)
unnamed: R7.2, U8.6 (~STDBY)
unnamed: R25.2, U9.2 (CS)
unnamed: Q1.4, U9.3 (OC)
unnamed: Q1.6, U9.1 (OD)
unnamed: C19.2, R22.2, U9.5 (VCC)
unnamed: C26.1, U12.9 (CAP)
unnamed: C25.1, U12.27 (XIN32), Y2.1
unnamed: C24.1, U12.26 (XOUT32/CLKSEL1), Y2.2
USB_5V: C6.1, C18.1, D6.2 (A), D7.2 (A), J2.A4/B9 (VBUS), J2.B4/A9 (VBUS__1), R11.2, TP5.1 (1_1), U4.6 (EN), U4.7 (IN), U4.8 (IN__1), U8.4 (V_{CC}), U8.8 (CE)
VCC_3V3: C2.1, C3.1, C11.1, C16.1, C27.1, D1.1 (K), J5.6, L1.1, Q3.2, R1.1, R19.1, R20.1, R27.2, R32.2, R33.1, TP7.1 (1_1), U5.2 (VCC), U6.1 (VIN), U6.3 (EN), U7.2 (EN), U7.3 (VIN), U12.3 (VDD), U12.28 (VDDIO)
VIN_3V3: C7.1, D1.2 (A), Q3.1, R9.1, R10.1, TP6.1 (1_1), U4.1 (OUT), U4.2 (OUT__1), U4.4 (FB/ADJ)

Notes on the sheet:
INTENDED FOR DOCK AND FRONTPANEL ONLY. INCLUDED WITH MAINBOARD FOR PROTOTYPING 1000mAh/1A
REFERENCE DESIGN FROM SPARKFUN MAX30101 QWIC TYPICAL CURRENT CONSUMPTION 600-1000uA VCC RANGE: 1.7 - 2.0V VCC RED/IR LED: 3.1-5.0V VCC GREN LED: 4.5-5.5V I2C ADD: 0X57
DC-DC CONVERTER TO 5V FOR MAX30101 INPUT: 2.4-4.75V
1.8V REGULATOR OUTPUT CURRENT: 150mA QUIESCENT CURRENT: 29uA
1X ON SIDE // 2X ON OTHER SIDE TYP. WAKE,SELECT,MENU / UP / DOWN
3.3V REGULATOR OUTPUT CURRENT: 1A QUIESCENT CURRENT: 140uA
RTC CLOCK
LIPO BATTERY CHARGER + PROTECTION
POWER REGULATION
ESP32-S3-MINI-1
EXTERNAL CONNECTORS
PULLUPS / LEVEL SHIFTER
9AXIS IMU BMO085
DIAGNOSTIC BUTTONS
PROGRAMMABLE BUTTONS
POWER LOAD SHARING PROTECTION
PULSE OXIMETER AND HEART RATE SENSOR

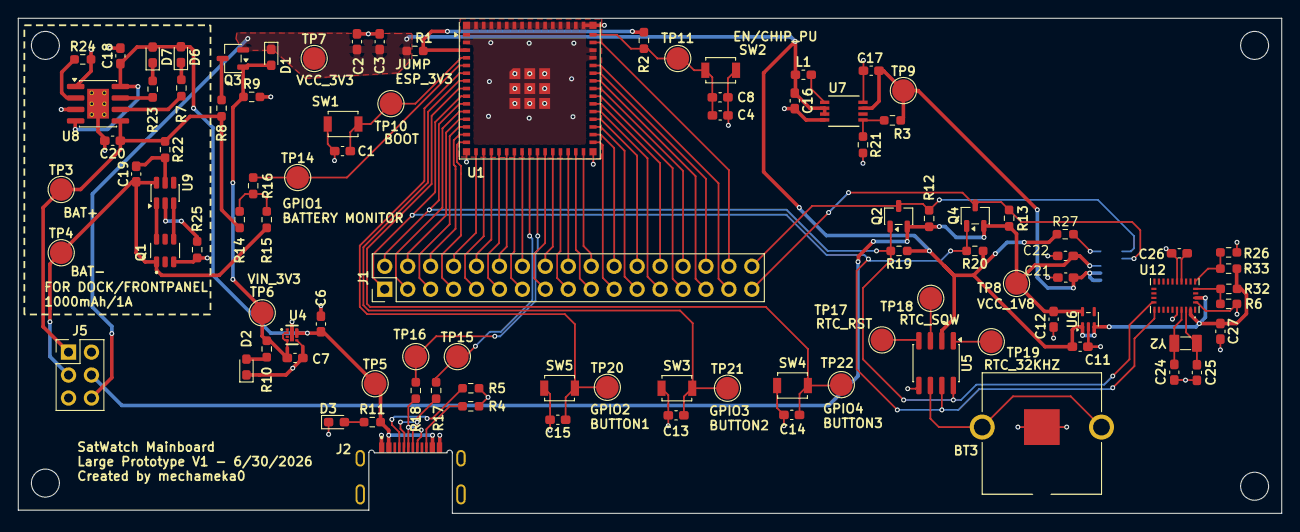
[picture p38: board satWatch_main_LargePrototype.kicad_pcb from above]

Board: 2 copper layers, 139.8 x 54.8 mm, 99 parts (1 on the bottom side), 80 nets.
