mechameka/satellite_watch/(commit log)

2026-06-10 v0.1
    Initial schematic layout completed
    [2895.step, MAX30101EFD_T.step, NCP186AMX180TAG.STEP, UJ20-C-H-G-MSMT-2B-P16-TR.step, fp1.kicad_sch, mb.kicad_sch, satellite_watch.kicad_pcb, satellite_watch.kicad_sch]
2026-06-10 v0.15
    wip of large-size PCB
    [MSOP8_DIO.step, fp1.kicad_sch, mb.kicad_sch, satellite_watch.kicad_pcb]
2026-06-17 v0.2
    schematic update. prepared file organization for multiple pcb layouts
    [FS8205.step, fp1.kicad_sch, mb.kicad_sch, satWatch_main_LargePrototype.kicad_pcb, satWatch_main_LargePrototype.kicad_sch, satellite_watch.kicad_pcb, satellite_watch.kicad_sch]
2026-06-24 v0.3
    Finalized initial draft of large mainboard PCB, ready for first production and testing
    [BNO085.step, satWatch_main_LargePrototype.kicad_pcb, satWatch_main_LargePrototype.kicad_sch]
2026-06-28 v0.4
    Finalized large prototyping PCB for manufacturing
    [satWatch_main.kicad_pcb, satWatch_main.kicad_sch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]
2026-07-01 v0.5
    removed MAX3264/MAX86141 for MAX30101 for reduced scope. editted PCB and via sizes based on manufacturer response.
    [satWatch_main_LargePrototype-B_Cu.gbr, satWatch_main_LargePrototype-B_Mask.gbr, satWatch_main_LargePrototype-B_Paste.gbr, satWatch_main_LargePrototype-B_Silkscreen.gbr, satWatch_main_LargePrototype-Edge_Cuts.gbr, satWatch_main_LargePrototype-F_Cu.gbr, satWatch_main_LargePrototype-F_Mask.gbr, satWatch_main_LargePrototype-F_Paste.gbr]
2026-07-06 v0.6
    Began layout work on watch-sized PCB. Backup of in-progress
    [PAM2401SCADJ.STEP, TL1105SF160Q.step, satWatch_main.kicad_pcb, satWatch_main.kicad_sch]
2026-07-07 V0.65
    mainboard progress backup
    [satWatch_main.kicad_pcb, satWatch_main.kicad_sch, satWatch_main_LargePrototype.csv]
2026-07-16 v1
    Completed large prototype testing. Implementing post-fab modifications into small-form board. Finalized mainboard routing iterations and added UART programming board.
    [855-22-006-10-001101.stp, ABS07-32.768KHZ-T.STEP, R-667995_MIT.step, SOT-416.step, satWatch_charger.kicad_sch, satWatch_face1.kicad_sch, satWatch_main.kicad_pcb, satWatch_main.kicad_sch]
2026-07-20 v1.1
    Completed board layout for charging dock configuration and a default watchface config
    [BC-2017.step, satWatch_charger.kicad_sch, satWatch_face1.kicad_sch, satWatch_main.kicad_pcb, satWatch_main.kicad_sch, satWatch_mainboard.kicad_sch, satWatch_programmer.kicad_sch]
2026-07-30 v1.2
    WIP of major revisions of PCB board. Changed components and layout for better routing
    [3028_2012BATTEYRHOLDER.step, BK-335-SM.step, HCMS-2901.STEP, HP_BubbleLED.step, SN74HC595NSR.stp, Same_Sky_UJ20-C-H-G-SMT-2A-P16-TR.step, ips_0.96_mock.step, mainboard.kicad_sch]
2026-08-15 v1.3
    progress update with PCB layout. Repurposing old board design.
    [face1.kicad_sch, face2.kicad_sch, mainboard.kicad_sch, proteus_watch.kicad_pcb, proteus_watch.kicad_sch]
2026-08-17 v1.31
    wip integrating face3
    [face1.kicad_sch, face3.kicad_sch, mainboard.kicad_sch, proteus_watch.kicad_pcb, proteus_watch.kicad_sch]
2026-08-17 v1.4
    completed board layout for production
    [face3.kicad_sch, mainboard.kicad_sch, proteus_watch.kicad_pcb]
2026-08-21 v1.41
    silkscreen prep
    [proteus_watch.kicad_pcb]
